crashmatt/Hardware/PX4uNode_V0_2_1.brd

## EAGLE design PX4uNode_V0_2_1.brd (2015-01-16)

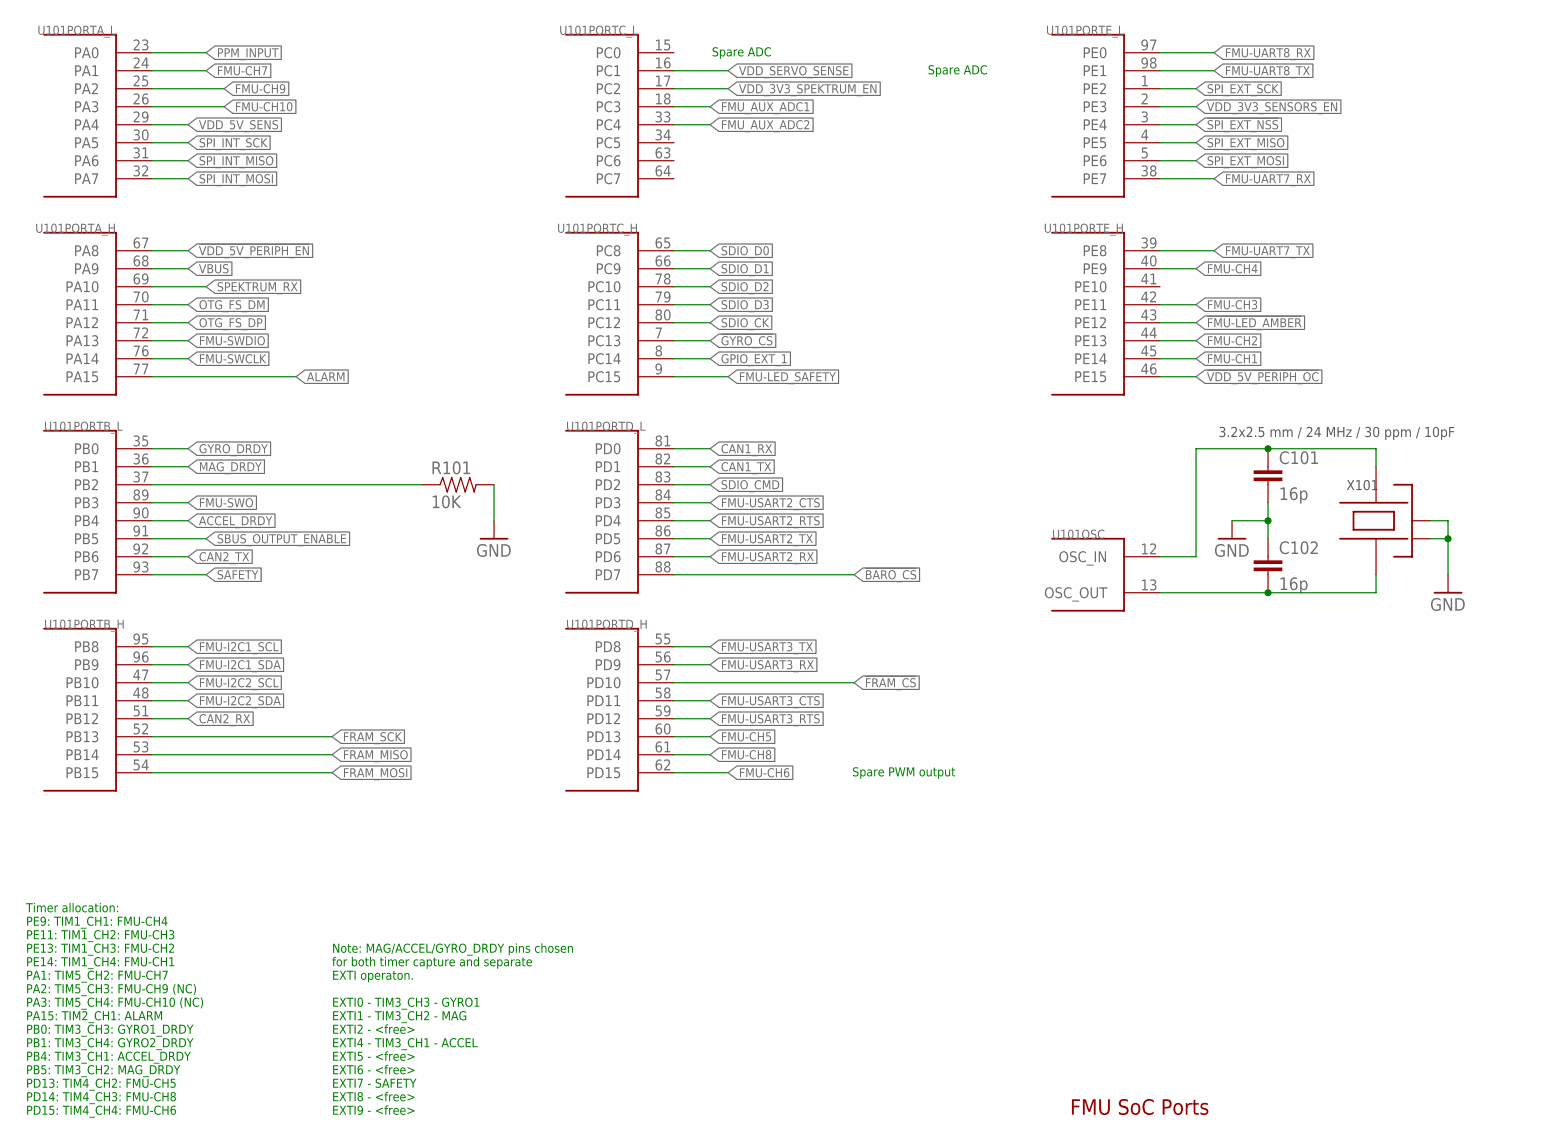
[picture p1: schematic PX4uNode_V0_2_1.sch, sheet 1]

Parts:
C101, C102: 16p; 0402-CAP; PARTNO C1005C0G1H160
R101: 10K; 0402-RES; PARTNO RC0402FR-0710KL
U101: STM32F4X7VX; TQFP100; PARTNO STM32F427VI
X101: 3.2x2.5 mm / 24 MHz / 30 ppm / 10pF; OSCILLATOR-3.2X2.5; PARTNO ABM8G-24.000MHZ-4Y-T3

Connections:
!BARO_CS: U101.88 (PD7)
!FMU-LED_AMBER: U101.43 (PE12); also elsewhere on the board
!FRAM_CS: U101.57 (PD10); also elsewhere on the board
!GYRO_CS: U101.7 (PC13); also elsewhere on the board
!SPI_EXT_NSS: U101.3 (PE4); also elsewhere on the board
!VDD_5V_PERIPH_EN: U101.67 (PA8); also elsewhere on the board
!VDD_5V_PERIPH_OC: U101.46 (PE15); also elsewhere on the board
ACCEL_DRDY: U101.90 (PB4); also elsewhere on the board
ALARM: U101.77 (PA15)
CAN1_RX: U101.81 (PD0); also elsewhere on the board
CAN1_TX: U101.82 (PD1); also elsewhere on the board
CAN2_RX: U101.51 (PB12); also elsewhere on the board
CAN2_TX: U101.92 (PB6); also elsewhere on the board
CLK1: C101.P$1 (1), U101.12 (OSC_IN), X101.3
CLK2: C102.P$2 (2), U101.13 (OSC_OUT), X101.1
FMU-CH1: U101.45 (PE14); also elsewhere on the board
FMU-CH2: U101.44 (PE13); also elsewhere on the board
FMU-CH3: U101.42 (PE11); also elsewhere on the board
FMU-CH4: U101.40 (PE9); also elsewhere on the board
FMU-CH5: U101.60 (PD13); also elsewhere on the board
FMU-CH6: U101.62 (PD15); also elsewhere on the board
FMU-CH7: U101.24 (PA1); also elsewhere on the board
FMU-CH8: U101.61 (PD14); also elsewhere on the board
FMU-CH9: U101.25 (PA2); also elsewhere on the board
FMU-CH10: U101.26 (PA3); also elsewhere on the board
FMU-I2C1_SCL: U101.95 (PB8); also elsewhere on the board
FMU-I2C1_SDA: U101.96 (PB9); also elsewhere on the board
FMU-I2C2_SCL: U101.47 (PB10); also elsewhere on the board
FMU-I2C2_SDA: U101.48 (PB11); also elsewhere on the board
FMU-LED_SAFETY: U101.9 (PC15); also elsewhere on the board
FMU-SWCLK: U101.76 (PA14); also elsewhere on the board
FMU-SWDIO: U101.72 (PA13); also elsewhere on the board
FMU-SWO: U101.89 (PB3); also elsewhere on the board
FMU-UART7_RX: U101.38 (PE7); also elsewhere on the board
FMU-UART7_TX: U101.39 (PE8); also elsewhere on the board
FMU-UART8_RX: U101.97 (PE0); also elsewhere on the board
FMU-UART8_TX: U101.98 (PE1); also elsewhere on the board
FMU-USART2_CTS: U101.84 (PD3); also elsewhere on the board
FMU-USART2_RTS: U101.85 (PD4); also elsewhere on the board
FMU-USART2_RX: U101.87 (PD6); also elsewhere on the board
FMU-USART2_TX: U101.86 (PD5); also elsewhere on the board
FMU-USART3_CTS: U101.58 (PD11); also elsewhere on the board
FMU-USART3_RTS: U101.59 (PD12); also elsewhere on the board
FMU-USART3_RX: U101.56 (PD9); also elsewhere on the board
FMU-USART3_TX: U101.55 (PD8); also elsewhere on the board
FMU_AUX_ADC1: U101.18 (PC3); also elsewhere on the board
FMU_AUX_ADC2: U101.33 (PC4); also elsewhere on the board
FRAM_MISO: U101.53 (PB14); also elsewhere on the board
FRAM_MOSI: U101.54 (PB15); also elsewhere on the board
FRAM_SCK: U101.52 (PB13); also elsewhere on the board
GND: C101.P$2 (2), C102.P$1 (1), R101.P$2 (2), X101.2 (NC_2), X101.4 (NC_4); also elsewhere on the board
GPIO_EXT_1: U101.8 (PC14); also elsewhere on the board
GYRO_DRDY: U101.35 (PB0); also elsewhere on the board
MAG_DRDY: U101.36 (PB1); also elsewhere on the board
OTG_FS_DM: U101.70 (PA11); also elsewhere on the board
OTG_FS_DP: U101.71 (PA12); also elsewhere on the board
PB2-BOOT1: R101.P$1 (1), U101.37 (PB2)
PPM_INPUT: U101.23 (PA0); also elsewhere on the board
SAFETY: U101.93 (PB7); also elsewhere on the board
SBUS_OUTPUT_ENABLE: U101.91 (PB5); also elsewhere on the board
SDIO_CK: U101.80 (PC12)
SDIO_CMD: U101.83 (PD2)
SDIO_D0: U101.65 (PC8)
SDIO_D1: U101.66 (PC9)
SDIO_D2: U101.78 (PC10)
SDIO_D3: U101.79 (PC11)
SPEKTRUM_RX: U101.69 (PA10); also elsewhere on the board
SPI_EXT_MISO: U101.4 (PE5); also elsewhere on the board
SPI_EXT_MOSI: U101.5 (PE6); also elsewhere on the board
SPI_EXT_SCK: U101.1 (PE2); also elsewhere on the board
SPI_INT_MISO: U101.31 (PA6); also elsewhere on the board
SPI_INT_MOSI: U101.32 (PA7); also elsewhere on the board
SPI_INT_SCK: U101.30 (PA5); also elsewhere on the board
VBUS: U101.68 (PA9); also elsewhere on the board
VDD_3V3_SENSORS_EN: U101.2 (PE3); also elsewhere on the board
VDD_3V3_SPEKTRUM_EN: U101.17 (PC2); also elsewhere on the board
VDD_5V_SENS: U101.29 (PA4); also elsewhere on the board
VDD_SERVO_SENSE: U101.16 (PC1); also elsewhere on the board

Notes on the sheet:
FMU SoC Ports
Note: MAG/ACCEL/GYRO_DRDY pins chosen for both timer capture and separate EXTI operaton. EXTI0 - TIM3_CH3 - GYRO1 EXTI1 - TIM3_CH2 - MAG EXTI2 - <free> EXTI4 - TIM3_CH1 - ACCEL EXTI5 - <free> EXTI6 - <free> EXTI7 - SAFETY EXTI8 - <free> EXTI9 - <free>
Timer allocation: PE9: TIM1_CH1: FMU-CH4 PE11: TIM1_CH2: FMU-CH3 PE13: TIM1_CH3: FMU-CH2 PE14: TIM1_CH4: FMU-CH1 PA1: TIM5_CH2: FMU-CH7 PA2: TIM5_CH3: FMU-CH9 (NC) PA3: TIM5_CH4: FMU-CH10 (NC) PA15: TIM2_CH1: ALARM PB0: TIM3_CH3: GYRO1_DRDY PB1: TIM3_CH4: GYRO2_DRDY PB4: TIM3_CH1: ACCEL_DRDY PB5: T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
Spare PWM output
Spare ADC

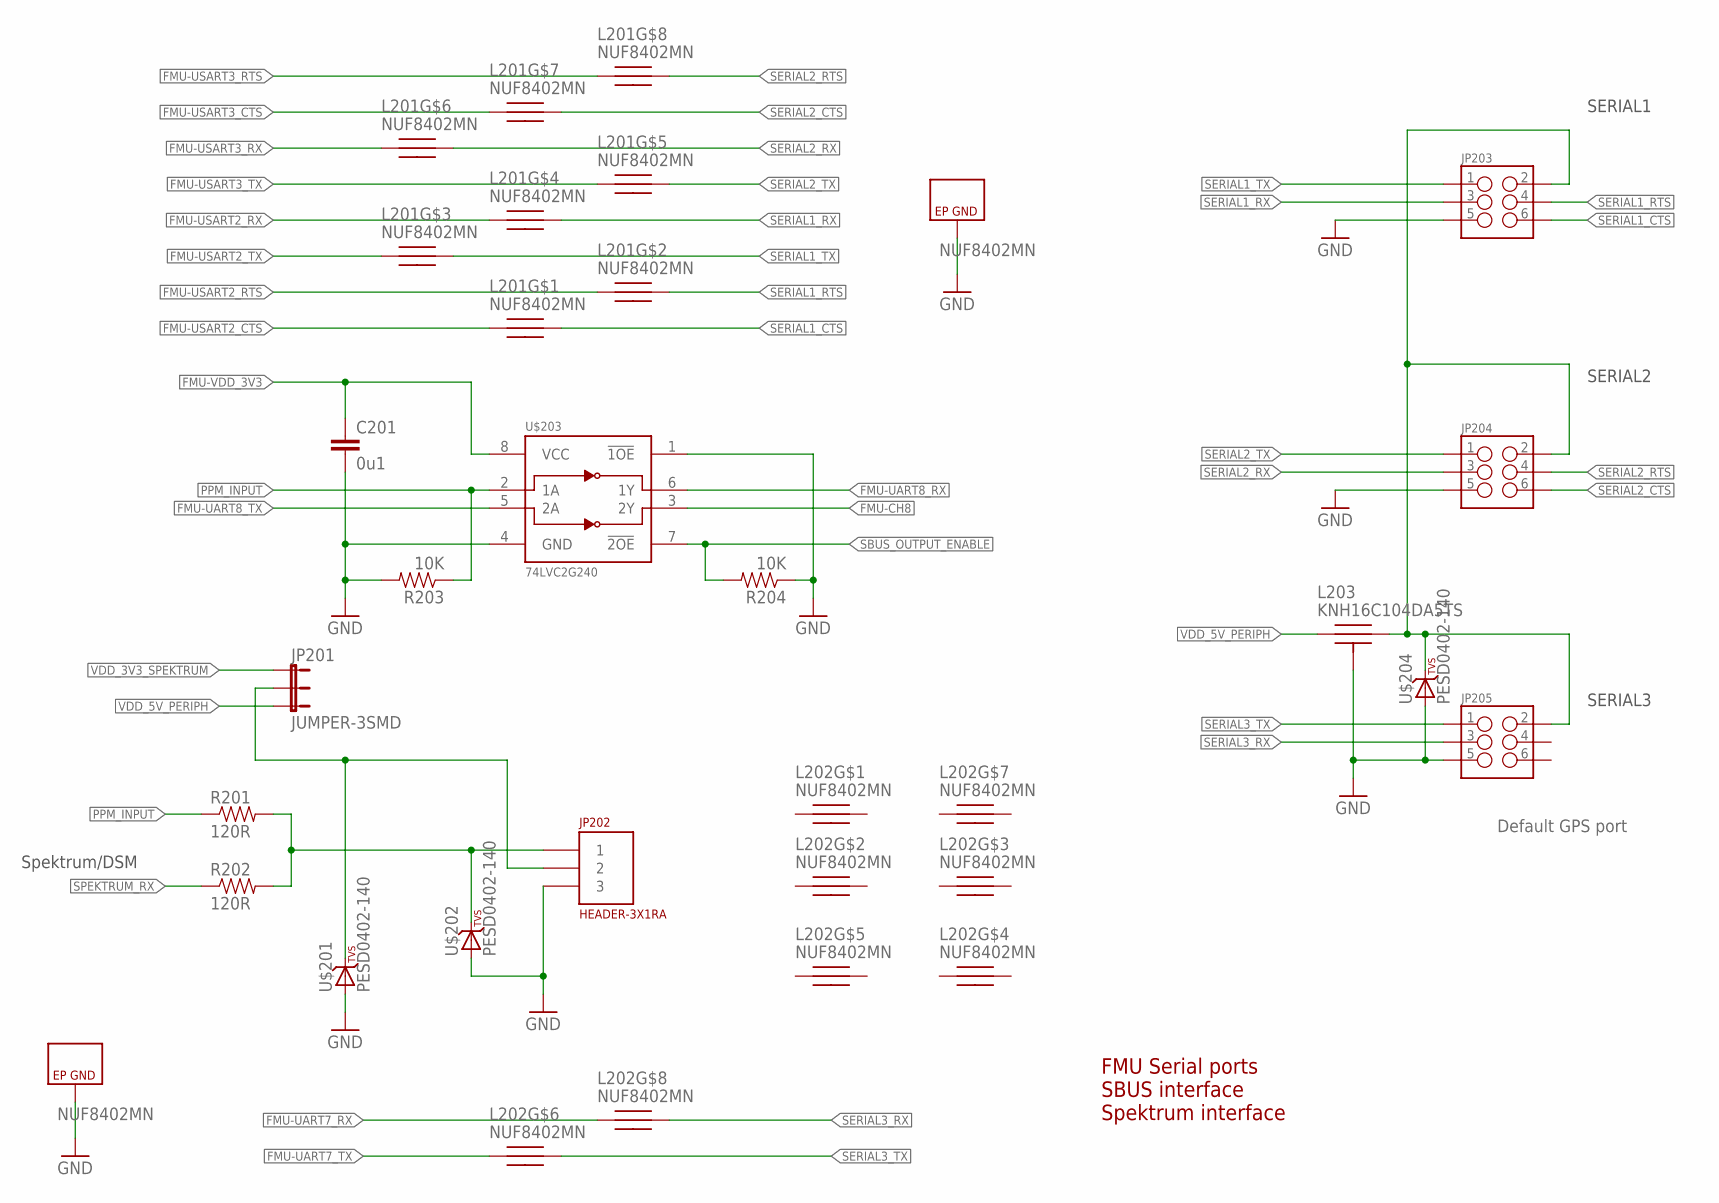
[picture p2: schematic PX4uNode_V0_2_1.sch, sheet 2]

Parts:
C201: 0u1; 0402-CAP; PARTNO CC0402ZRY5V7BB104
JP201: JUMPER-3SMD; SJ_3
JP202: HEADER-3X1RA; 3X1RA
JP203, JP204, JP205: M03X22X3_SILK_SM; 2X3
L201, L202: NUF8402MN; DFN16-THIN; PARTNO NUF8402MN
L203: KNH16C104DA5TS; KYOCERA-KNH16-DA; PARTNO KNH16C104DA5TS
R201, R202: 120R; 0402-RES; PARTNO RC0402FR-07120RL
R203, R204: 10K; 0402-RES; PARTNO RC0402FR-0710KL
U$201, U$202, U$204: PESD0402-140; 0402-TVS; PARTNO PESD0402-140
U$203: 74LVC2G240; VSSOP8; PARTNO 74LVC2G240

Connections:
5V_S3_FILTERED: JP203.2, JP204.2, JP205.2, L203.P$2, U$204.C
FMU-CH8: U$203.3 (2Y); also elsewhere on the board
FMU-UART7_RX: L202.P$8; also elsewhere on the board
FMU-UART7_TX: L202.P$6; also elsewhere on the board
FMU-UART8_RX: U$203.6 (1Y); also elsewhere on the board
FMU-UART8_TX: U$203.5 (2A); also elsewhere on the board
FMU-USART2_CTS: L201.P$1; also elsewhere on the board
FMU-USART2_RTS: L201.P$2; also elsewhere on the board
FMU-USART2_RX: L201.P$4; also elsewhere on the board
FMU-USART2_TX: L201.P$3; also elsewhere on the board
FMU-USART3_CTS: L201.P$7; also elsewhere on the board
FMU-USART3_RTS: L201.P$8; also elsewhere on the board
FMU-USART3_RX: L201.P$6; also elsewhere on the board
FMU-USART3_TX: L201.P$5; also elsewhere on the board
FMU-VDD_3V3: C201.P$1 (1), U$203.8 (VCC); also elsewhere on the board
GND: C201.P$2 (2), JP202.3, JP203.5, JP204.5, JP205.5, L201.P$EP (GND), L202.P$EP (GND), L203.P$3, L203.P$4, L203.P$5, R203.P$2 (2), R204.P$1 (1), U$201.A, U$202.A, U$203.1 (!1OE), U$203.4 (GND), U$204.A; also elsewhere on the board
unnamed: JP202.1, R201.P$2 (2), R202.P$2 (2), U$202.C
unnamed: JP201.2, JP202.2, U$201.C
PPM_INPUT: R201.P$1 (1), R203.P$1 (1), U$203.2 (1A); also elsewhere on the board
SBUS_OUTPUT_ENABLE: R204.P$2 (2), U$203.7 (!2OE); also elsewhere on the board
SERIAL1_CTS: JP203.6, L201.P$16
SERIAL1_RTS: JP203.4, L201.P$15
SERIAL1_RX: JP203.3, L201.P$13
SERIAL1_TX: JP203.1, L201.P$14
SERIAL2_CTS: JP204.6, L201.P$10
SERIAL2_RTS: JP204.4, L201.P$9
SERIAL2_RX: JP204.3, L201.P$11
SERIAL2_TX: JP204.1, L201.P$12
SERIAL3_RX: JP205.3, L202.P$9
SERIAL3_TX: JP205.1, L202.P$11
SPEKTRUM_RX: R202.P$1 (1); also elsewhere on the board
VDD_3V3_SPEKTRUM: JP201.1; also elsewhere on the board
VDD_5V_PERIPH: JP201.3, L203.P$1; also elsewhere on the board

Notes on the sheet:
FMU Serial ports SBUS interface Spektrum interface
SERIAL2
SERIAL1
SERIAL3
Default GPS port
Spektrum/DSM

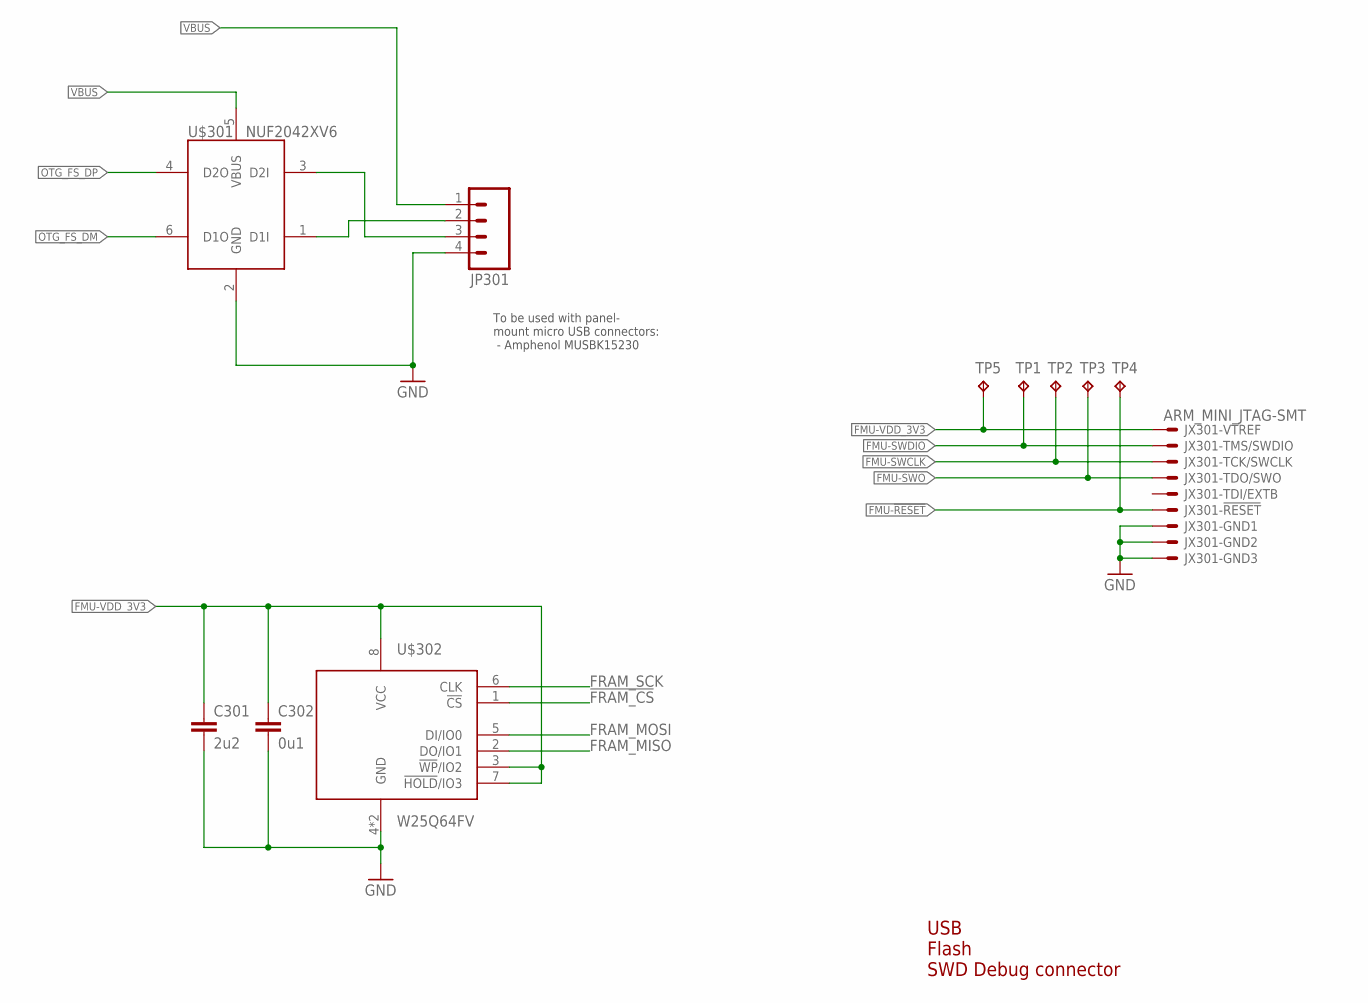
[picture p3: schematic PX4uNode_V0_2_1.sch, sheet 3]

Parts:
C301: 2u2; 0603-CAP; PARTNO C1608Y5V1C225Z
C302: 0u1; 0402-CAP; PARTNO CC0402ZRY5V7BB104
JP301: M04PTH; 1X04
JX301: ARM_MINI_JTAG-SMT; FTSH-105-01-XXX-DV-K; PARTNO M50-3900542
TP1, TP2, TP3, TP4, TP5: TPTP20R; TP20R
U$301: NUF2042XV6; SOT563-6; PARTNO NUF2042XV6
U$302: W25Q64FV; WSON-8-5X6; PARTNO W25Q64FVZP

Connections:
!FRAM_CS: U$302.1 (!CS); also elsewhere on the board
FMU-!RESET: JX301.10, TP4.TP; also elsewhere on the board
FMU-SWCLK: JX301.4, TP2.TP; also elsewhere on the board
FMU-SWDIO: JX301.2, TP1.TP; also elsewhere on the board
FMU-SWO: JX301.6, TP3.TP; also elsewhere on the board
FMU-VDD_3V3: C301.P$1 (1), C302.P$1 (1), JX301.1, TP5.TP, U$302.3 (!WP!/IO2), U$302.7 (!HOLD!/IO3), U$302.8 (VCC); also elsewhere on the board
FRAM_MISO: U$302.2 (DO/IO1); also elsewhere on the board
FRAM_MOSI: U$302.5 (DI/IO0); also elsewhere on the board
FRAM_SCK: U$302.6 (CLK); also elsewhere on the board
GND: C301.P$2 (2), C302.P$2 (2), JP301.4, JX301.3, JX301.5, JX301.9, U$301.2 (GND), U$302.4 (GND), U$302.PAD (GND); also elsewhere on the board
OTG_FS_DM: U$301.6 (D1O); also elsewhere on the board
OTG_FS_DP: U$301.4 (D2O); also elsewhere on the board
UDB_DP: JP301.3, U$301.3 (D2I)
USB_DM: JP301.2, U$301.1 (D1I)
VBUS: JP301.1, U$301.5 (VBUS); also elsewhere on the board

Notes on the sheet:
USB Flash SWD Debug connector
To be used with panel- mount micro USB connectors: - Amphenol MUSBK15230

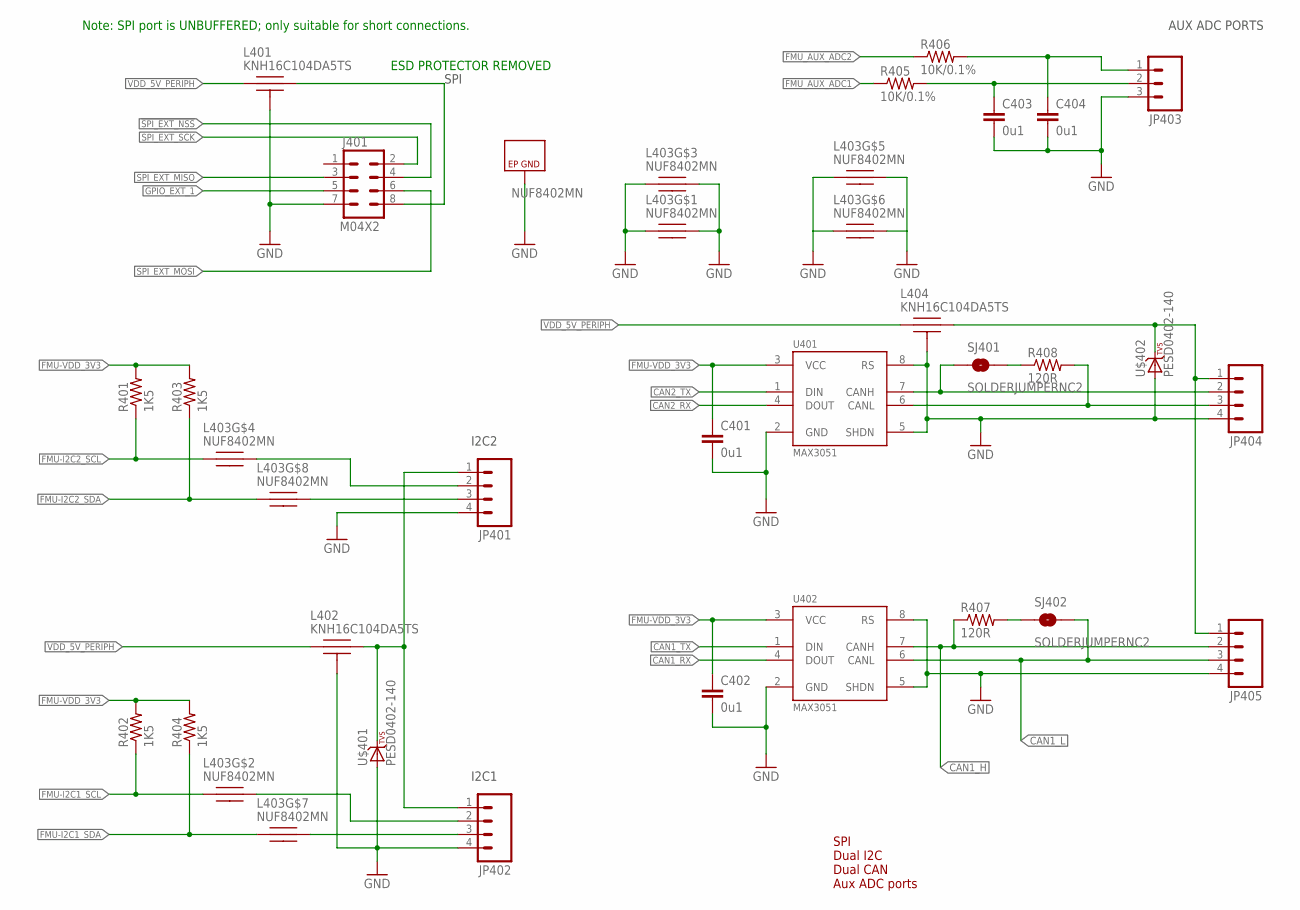
[picture p4: schematic PX4uNode_V0_2_1.sch, sheet 4]

Parts:
C401, C402, C403, C404: 0u1; 0402-CAP; PARTNO CC0402ZRY5V7BB104
J401: M04X2; 2X4
JP401, JP402, JP404, JP405: M04PTH; 1X04
JP403: M03PTH; 1X03; PARTNO EXCLUDE
L401, L402, L404: KNH16C104DA5TS; KYOCERA-KNH16-DA; PARTNO KNH16C104DA5TS
L403: NUF8402MN; DFN16-THIN; PARTNO NUF8402MN
R401, R402, R403, R404: 1K5; 0402-RES; PARTNO RC0402FR-071K5L
R405, R406: 10K/0.1%; 0402-RES; PARTNO ERA-2AEB103X
R407, R408: 120R; 0402-RES; PARTNO RC0402FR-07120RL
SJ401, SJ402: SOLDERJUMPERNC2; SJ_2S-NOTRACE
U401, U402: MAX3051; SOT23-8; PARTNO MAX3051EKA
U$401, U$402: PESD0402-140; 0402-TVS; PARTNO PESD0402-140

Connections:
!SPI_EXT_NSS: J401.4; also elsewhere on the board
CAN1_H: JP405.2, R407.P$1 (1), U402.7 (CANH)
CAN1_L: JP405.3, SJ402.2, U402.6 (CANL)
CAN1_RX: U402.4 (DOUT); also elsewhere on the board
CAN1_TX: U402.1 (DIN); also elsewhere on the board
CAN2_H: JP404.2, SJ401.1, U401.7 (CANH)
CAN2_L: JP404.3, R408.P$2 (2), U401.6 (CANL)
CAN2_RX: U401.4 (DOUT); also elsewhere on the board
CAN2_TX: U401.1 (DIN); also elsewhere on the board
FMU-I2C1_SCL: L403.P$2, R402.P$1 (1); also elsewhere on the board
FMU-I2C1_SDA: L403.P$7, R404.P$1 (1); also elsewhere on the board
FMU-I2C2_SCL: L403.P$4, R401.P$1 (1); also elsewhere on the board
FMU-I2C2_SDA: L403.P$8, R403.P$1 (1); also elsewhere on the board
FMU-VDD_3V3: C401.P$1 (1), C402.P$1 (1), R401.P$2 (2), R402.P$2 (2), R403.P$2 (2), R404.P$2 (2), U401.3 (VCC), U402.3 (VCC); also elsewhere on the board
FMU_AUX_ADC1: R405.P$1 (1); also elsewhere on the board
FMU_AUX_ADC1_PROT: C403.P$1 (1), JP403.2, R405.P$2 (2)
FMU_AUX_ADC2: R406.P$1 (1); also elsewhere on the board
FMU_AUX_ADC2_PROT: C404.P$1 (1), JP403.1, R406.P$2 (2)
GND: C401.P$2 (2), C402.P$2 (2), C403.P$2 (2), C404.P$2 (2), J401.7, JP401.4, JP402.4, JP403.3, JP404.4, JP405.4, L401.P$3, L401.P$4, L401.P$5, L402.P$3, L402.P$4, L402.P$5, L403.P$1, L403.P$3, L403.P$5, L403.P$6, L403.P$11, L403.P$12, L403.P$14, L403.P$16, L403.P$EP (GND), L404.P$3, L404.P$4, L404.P$5, U401.2 (GND), U401.5 (SHDN), U401.8 (RS), U402.2 (GND), U402.5 (SHDN), U402.8 (RS), U$401.A, U$402.A; also elsewhere on the board
GPIO_EXT_1: J401.5; also elsewhere on the board
IC2_VDD_5V: JP401.1, JP402.1, L402.P$2, U$401.C
unnamed: JP401.2, L403.P$13
unnamed: JP401.3, L403.P$9
unnamed: R408.P$1 (1), SJ401.2
unnamed: R407.P$2 (2), SJ402.1
unnamed: JP404.1, JP405.1, L404.P$2, U$402.C
unnamed: JP402.2, L403.P$15
unnamed: JP402.3, L403.P$10
unnamed: J401.8, L401.P$2
SPI_EXT_MISO: J401.3; also elsewhere on the board
SPI_EXT_MOSI: J401.6; also elsewhere on the board
SPI_EXT_SCK: J401.2; also elsewhere on the board
VDD_5V_PERIPH: L401.P$1, L402.P$1, L404.P$1; also elsewhere on the board

Notes on the sheet:
SPI
I2C2
AUX ADC PORTS
SPI Dual I2C Dual CAN Aux ADC ports
Note: SPI port is UNBUFFERED; only suitable for short connections.
I2C1
ESD PROTECTOR REMOVED

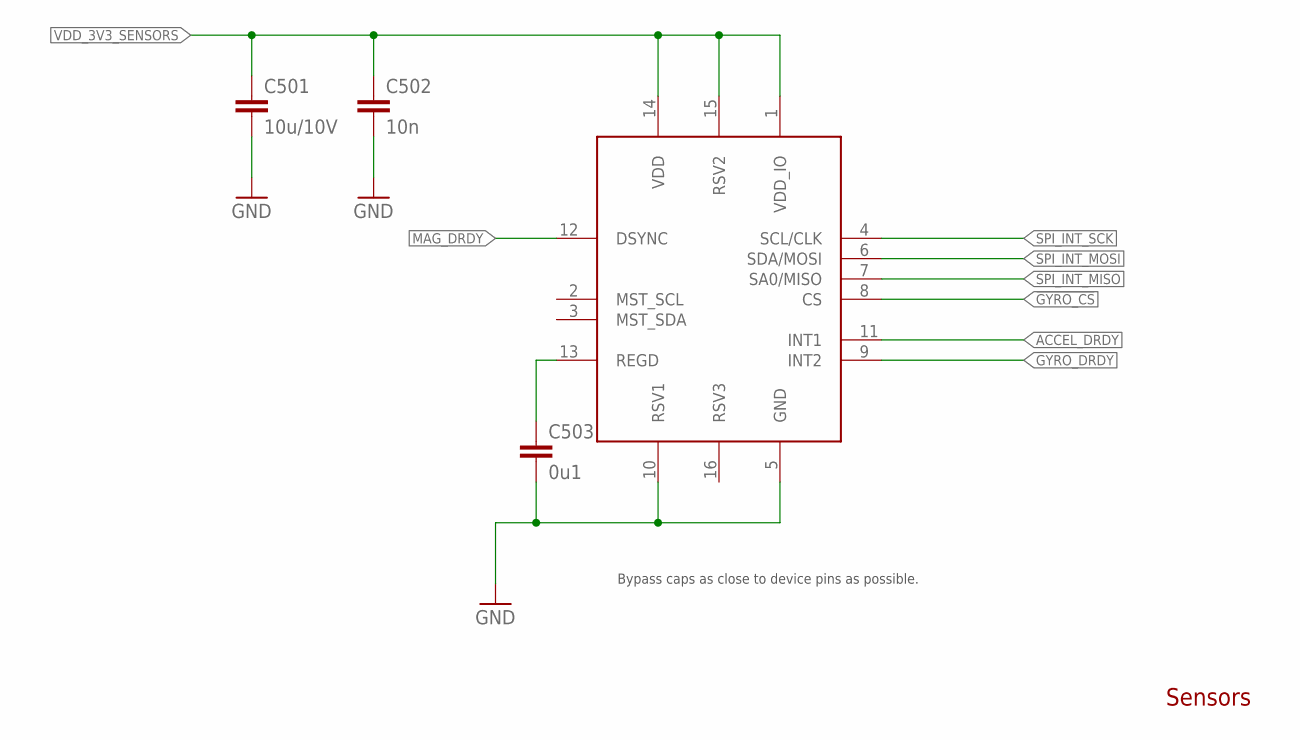
[picture p5: schematic PX4uNode_V0_2_1.sch, sheet 5]

Parts:
C501: 10u/10V; 0805-CAP; PARTNO CC0805ZKY5V6BB106
C502: 10n; 0402-CAP; PARTNO CC0402KRX7R7BB103
C503: 0u1; 0402-CAP; PARTNO CC0402ZRY5V7BB104
U$501: MAX21100; 16LGA-3X3; PARTNO MAX21100+

Connections:
!GYRO_CS: U$501.8 (CS); also elsewhere on the board
ACCEL_DRDY: U$501.11 (INT1); also elsewhere on the board
GND: C501.P$2 (2), C502.P$2 (2), C503.P$2 (2), U$501.5 (GND), U$501.10 (RSV1); also elsewhere on the board
GYRO_DRDY: U$501.9 (INT2); also elsewhere on the board
MAG_DRDY: U$501.12 (DSYNC); also elsewhere on the board
REGD: C503.P$1 (1), U$501.13 (REGD)
SPI_INT_MISO: U$501.7 (SA0/MISO); also elsewhere on the board
SPI_INT_MOSI: U$501.6 (SDA/MOSI); also elsewhere on the board
SPI_INT_SCK: U$501.4 (SCL/CLK); also elsewhere on the board
VDD_3V3_SENSORS: C501.P$1 (1), C502.P$1 (1), U$501.1 (VDD_IO), U$501.14 (VDD), U$501.15 (RSV2); also elsewhere on the board

Notes on the sheet:
Sensors
Bypass caps as close to device pins as possible.

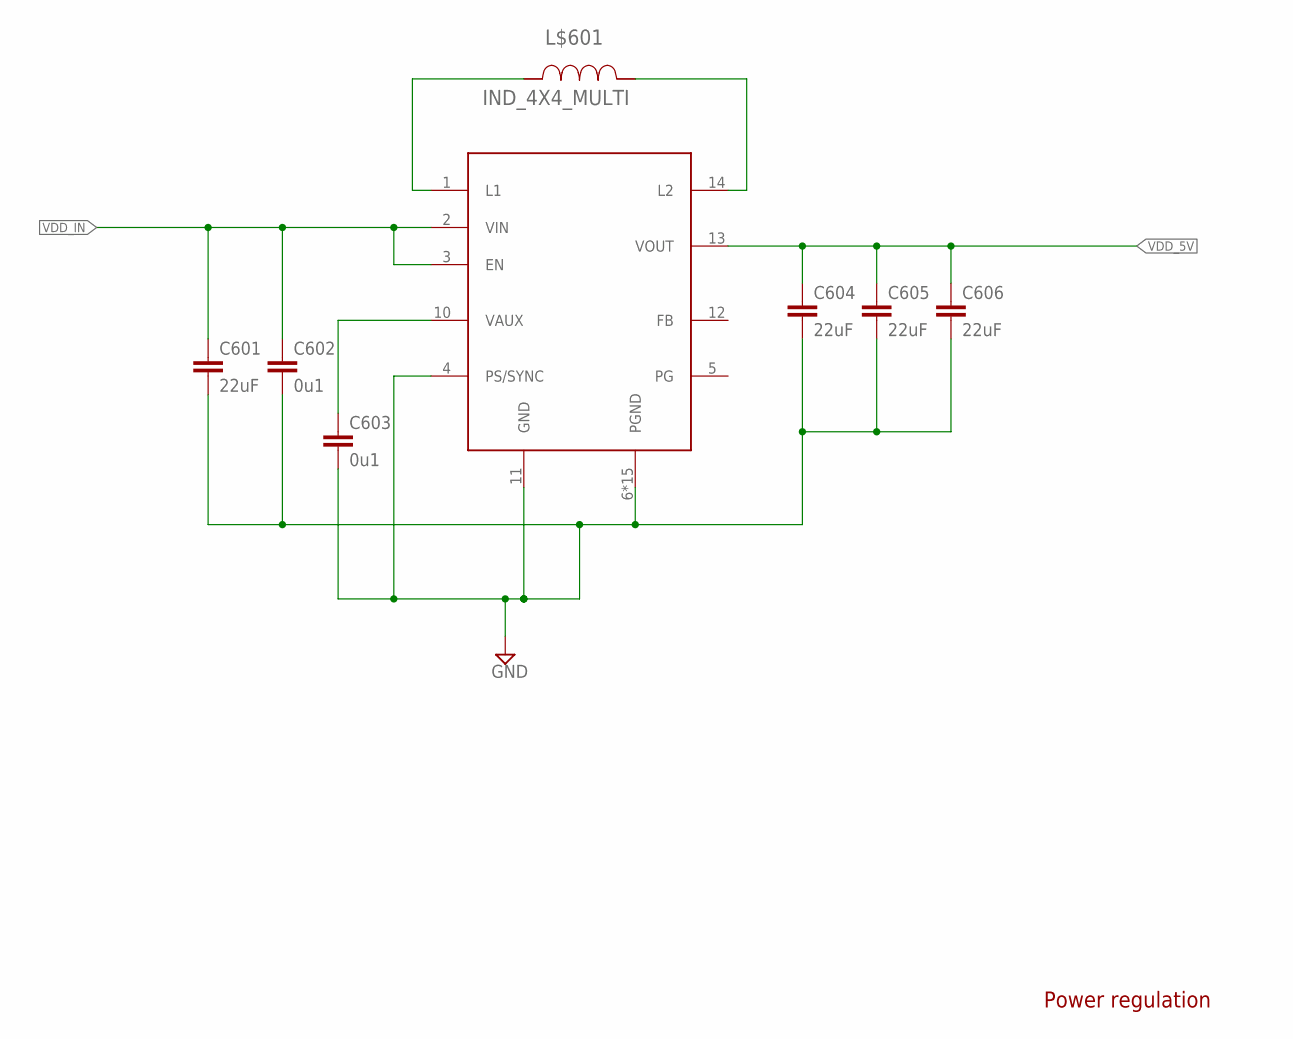
[picture p6: schematic PX4uNode_V0_2_1.sch, sheet 6]

Parts:
C601, C604, C605, C606: 22uF; 1210; PARTNO C3225X7R1C226M250AC
C602, C603: 0u1; 0402-CAP; PARTNO CC0402ZRY5V7BB104
L$601: IND_4X4_MULTI; PARTNO XFL4020-222MEB
U$601: TPS6303X; PWSON10; PARTNO TPS63061DSCT

Connections:
GND: C601.2, C602.P$2 (2), C603.P$2 (2), C604.2, C605.2, C606.2, U$601.4 (PS/SYNC), U$601.6 (PGND), U$601.7 (PGND), U$601.8 (PGND), U$601.9 (PGND), U$601.11 (GND), U$601.15 (PGND), U$601.16 (PGND), U$601.17 (PGND), U$601.18 (PGND), U$601.19 (PGND), U$601.20 (PGND), U$601.21 (PGND), U$601.22 (PGND), U$601.23 (PGND), U$601.EP (PGND), U$601.EP1 (PGND); also elsewhere on the board
unnamed: L$601.1, U$601.14 (L2)
unnamed: L$601.2, U$601.1 (L1)
unnamed: C603.P$1 (1), U$601.10 (VAUX)
VDD_5V: C604.1, C605.1, C606.1, U$601.13 (VOUT); also elsewhere on the board
VDD_IN: C601.1, C602.P$1 (1), U$601.2 (VIN), U$601.3 (EN); also elsewhere on the board

Notes on the sheet:
Power regulation

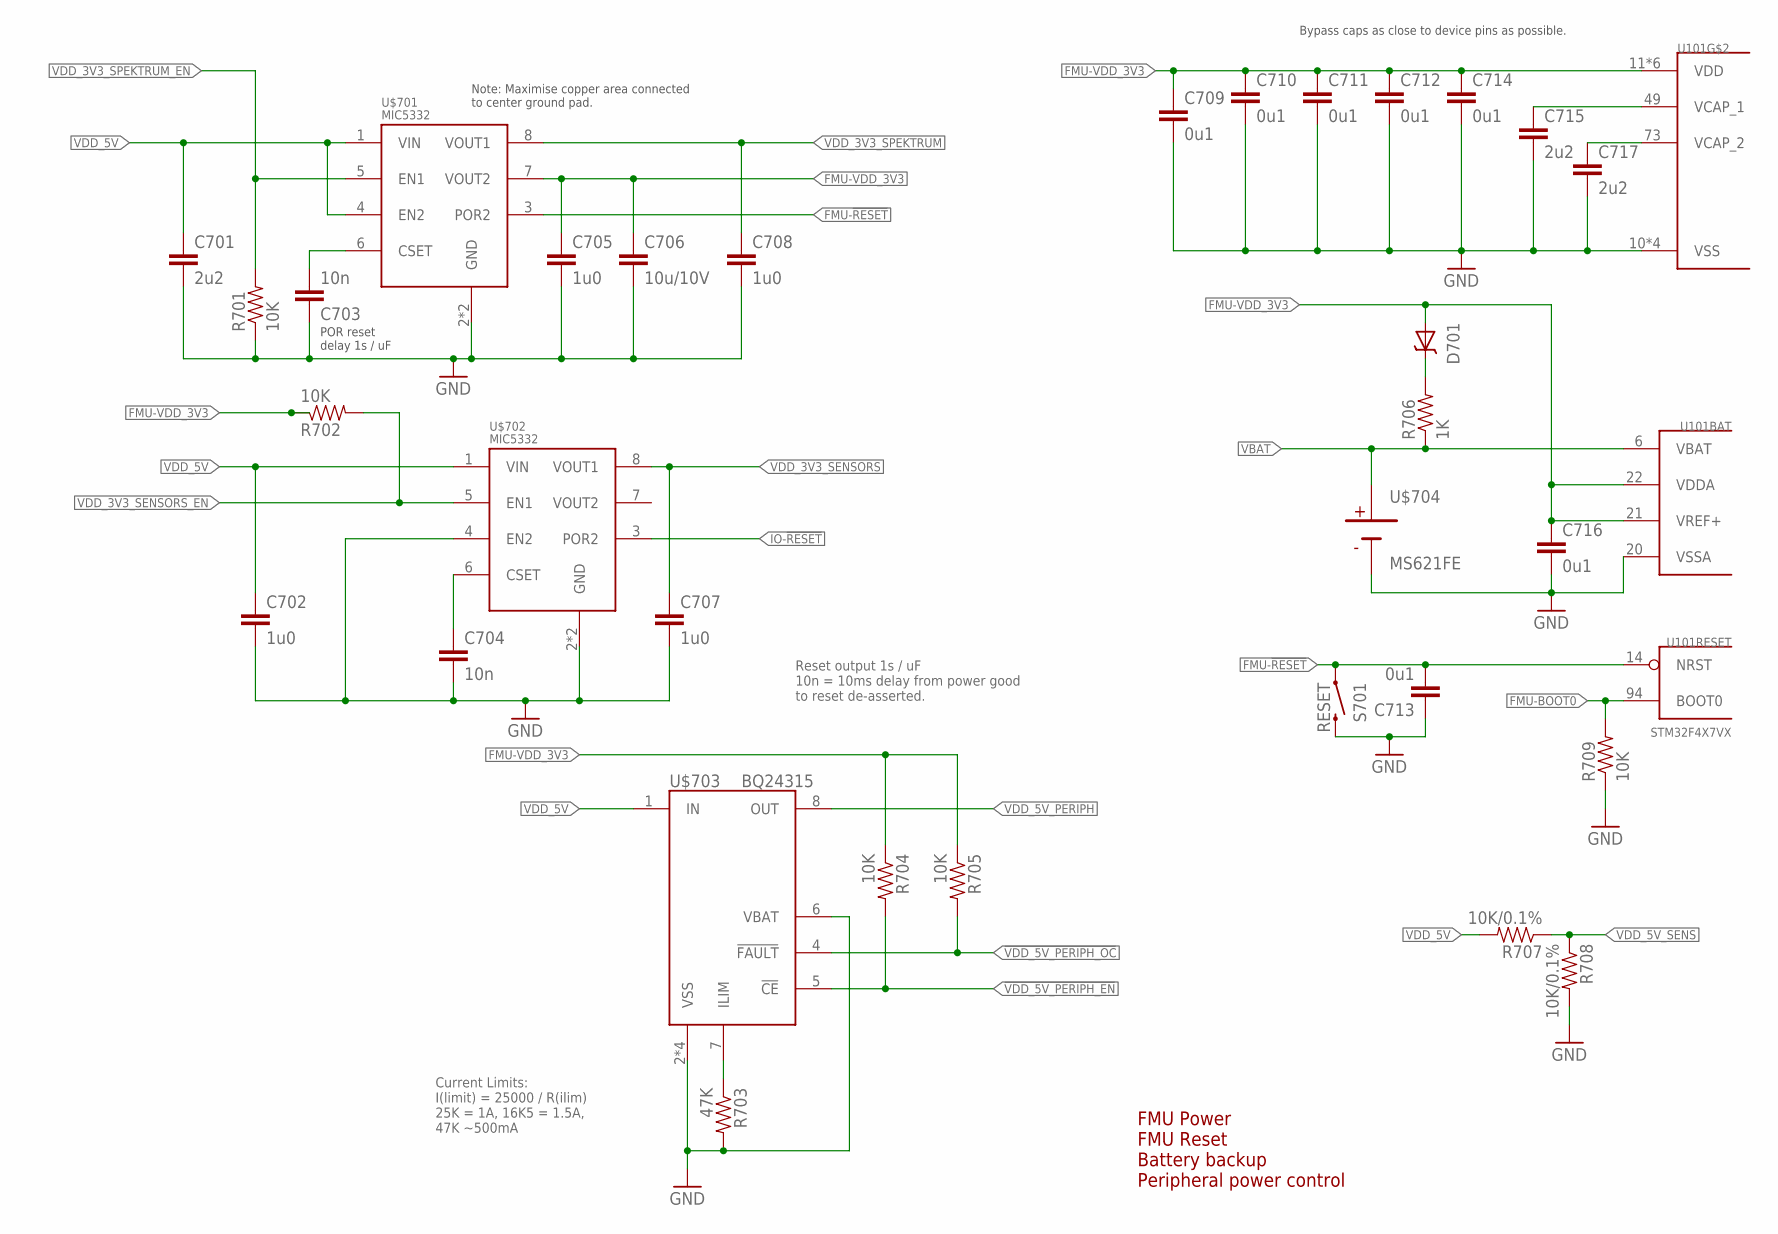
[picture p7: schematic PX4uNode_V0_2_1.sch, sheet 7]

Parts:
C701, C715, C717: 2u2; 0603-CAP; PARTNO C1608Y5V1C225Z
C702, C705, C707, C708: 1u0; 0603-CAP; PARTNO CC0603ZRY5V7BB105
C703, C704: 10n; 0402-CAP; PARTNO CC0402KRX7R7BB103
C706: 10u/10V; 0805-CAP; PARTNO CC0805ZKY5V6BB106
C709, C710, C711, C712, C713, C714, C716: 0u1; 0402-CAP; PARTNO CC0402ZRY5V7BB104
D701: DIODE-SCHOTTKY; SOD-523; PARTNO MBRA140
R701, R702, R704, R705, R709: 10K; 0402-RES; PARTNO RC0402FR-0710KL
R703: 47K; 0402-RES; PARTNO RMCF0402FT47K
R706: 1K; 0402-RES; PARTNO RC0402FR-071KL
R707, R708: 10K/0.1%; 0402-RES; PARTNO ERA-2AEB103X
S701: RESET; EVQP7J01K; PARTNO EVQP7J01K
U101: STM32F4X7VX; TQFP100; PARTNO STM32F427VI
U$701, U$702: MIC5332; MLF-8-EPAD; PARTNO MIC5332-SSYMT
U$703: BQ24315; QFN8-DSG; PARTNO BQ24315DSGR
U$704: MS621FE

Connections:
!VDD_5V_PERIPH_EN: R704.P$2 (2), U$703.5 (!CE); also elsewhere on the board
!VDD_5V_PERIPH_OC: R705.P$2 (2), U$703.4 (!FAULT); also elsewhere on the board
FMU-!RESET: C713.P$2 (2), S701.A1 (1), U101.14 (NRST), U$701.3 (POR2); also elsewhere on the board
FMU-BOOT0: R709.P$2 (2), U101.94 (BOOT0); also elsewhere on the board
FMU-VDD_3V3: C705.P$1 (1), C706.P$1 (1), C709.P$1 (1), C710.P$1 (1), C711.P$1 (1), C712.P$1 (1), C714.P$1 (1), C716.P$1 (1), D701.A, R702.P$1 (1), R704.P$1 (1), R705.P$1 (1), U101.11 (VDD), U101.19 (VDD), U101.21 (VREF+), U101.22 (VDDA), U101.28 (VDD), U101.50 (VDD), U101.75 (VDD), U101.100 (VDD), U$701.7 (VOUT2); also elsewhere on the board
GND: C701.P$2 (2), C702.P$2 (2), C703.P$1 (1), C704.P$2 (2), C705.P$2 (2), C706.P$2 (2), C707.P$2 (2), C708.P$2 (2), C709.P$2 (2), C710.P$2 (2), C711.P$2 (2), C712.P$2 (2), C713.P$1 (1), C714.P$2 (2), C715.P$2 (2), C716.P$2 (2), C717.P$2 (2), R701.P$1 (1), R703.P$2 (2), R708.P$2 (2), R709.P$1 (1), S701.B3 (2), U101.10 (VSS), U101.20 (VSSA), U101.27 (VSS), U101.74 (VSS), U101.99 (VSS), U$701.2 (GND), U$701.GND, U$702.2 (GND), U$702.4 (EN2), U$702.GND, U$703.2 (VSS), U$703.6 (VBAT), U$703.GND (VSS), U$703.P$2 (VSS), U$703.P$3 (VSS), U$704.2 (NEG); also elsewhere on the board
IO-!RESET: U$702.3 (POR2)
unnamed: D701.C, R706.P$2 (2)
unnamed: C703.P$2 (2), U$701.6 (CSET)
unnamed: R703.P$1 (1), U$703.7 (ILIM)
unnamed: C704.P$1 (1), U$702.6 (CSET)
VBAT: R706.P$1 (1), U101.6 (VBAT), U$704.1 (POS)
VCAP_1: C715.P$1 (1), U101.49 (VCAP_1)
VCAP_2: C717.P$1 (1), U101.73 (VCAP_2)
VDD_3V3_SENSORS: C707.P$1 (1), U$702.8 (VOUT1); also elsewhere on the board
VDD_3V3_SENSORS_EN: R702.P$2 (2), U$702.5 (EN1); also elsewhere on the board
VDD_3V3_SPEKTRUM: C708.P$1 (1), U$701.8 (VOUT1); also elsewhere on the board
VDD_3V3_SPEKTRUM_EN: R701.P$2 (2), U$701.5 (EN1); also elsewhere on the board
VDD_5V: C701.P$1 (1), C702.P$1 (1), R707.P$2 (2), U$701.1 (VIN), U$701.4 (EN2), U$702.1 (VIN), U$703.1 (IN); also elsewhere on the board
VDD_5V_PERIPH: U$703.8 (OUT); also elsewhere on the board
VDD_5V_SENS: R707.P$1 (1), R708.P$1 (1); also elsewhere on the board

Notes on the sheet:
FMU Power FMU Reset Battery backup Peripheral power control
Bypass caps as close to device pins as possible.
Note: Maximise copper area connected to center ground pad.
POR reset delay 1s / uF
Current Limits: I(limit) = 25000 / R(ilim) 25K = 1A, 16K5 = 1.5A, 47K ~500mA
Reset output 1s / uF 10n = 10ms delay from power good to reset de-asserted.

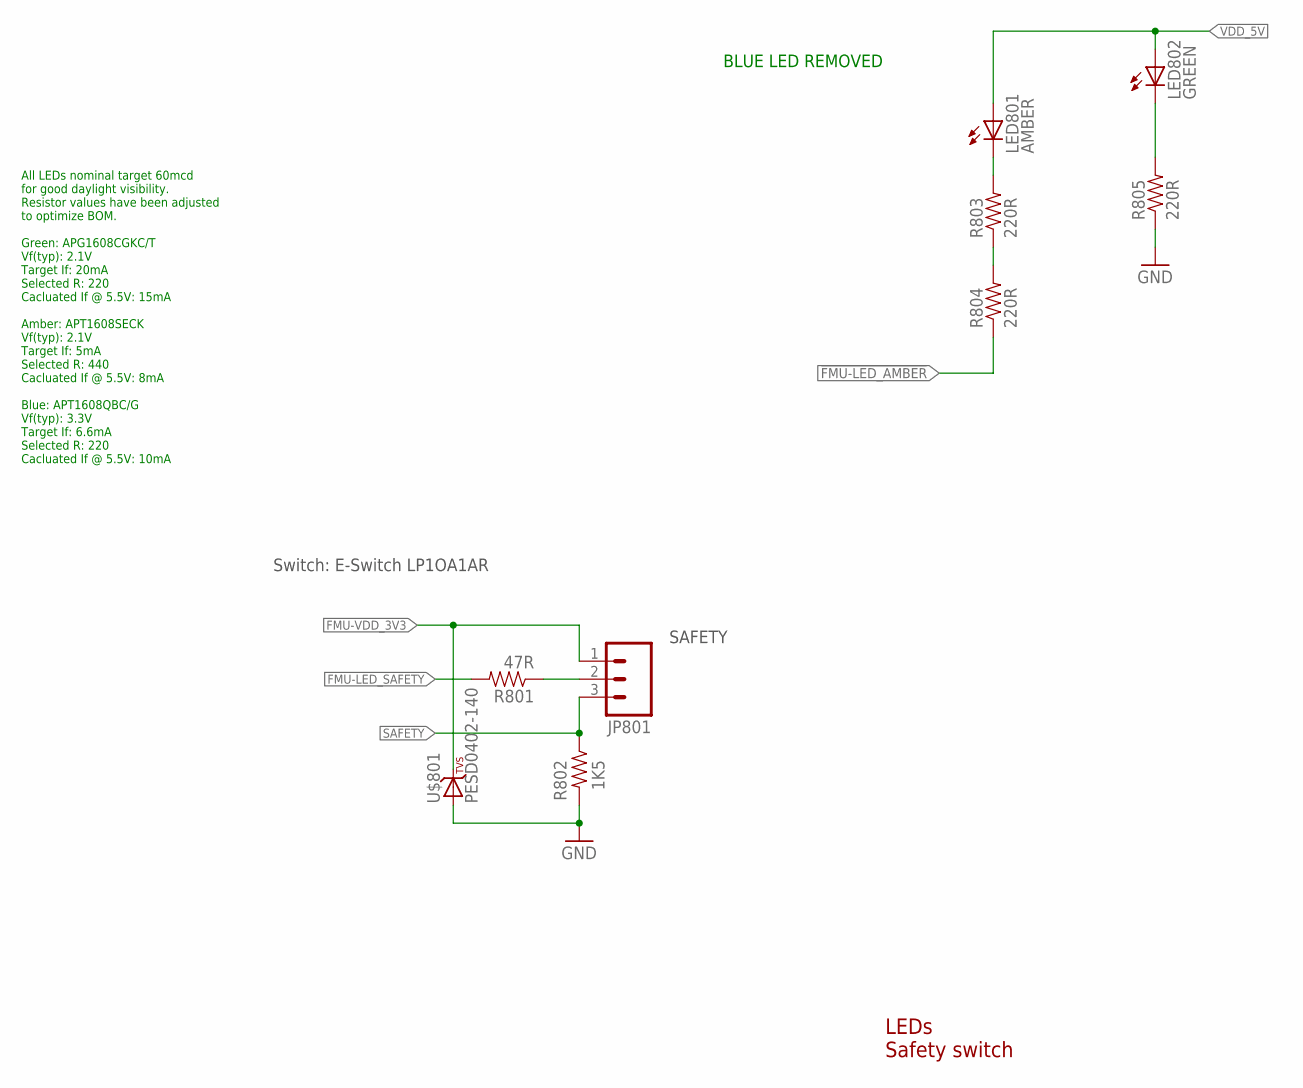
[picture p8: schematic PX4uNode_V0_2_1.sch, sheet 8]

Parts:
JP801: M03PTH; 1X03
LED801: AMBER; 0603-LED; PARTNO APTD1608SECK
LED802: GREEN; 0603-LED; PARTNO APTD1608CGCK
R801: 47R; 0402-RES; PARTNO RC0402JR-0747RL
R802: 1K5; 0402-RES; PARTNO RC0402FR-071K5L
R803, R804, R805: 220R; 0402-RES; PARTNO RC0402FR-07220RL
U$801: PESD0402-140; 0402-TVS; PARTNO PESD0402-140

Connections:
!FMU-LED_AMBER: R804.P$1 (1); also elsewhere on the board
FMU-LED_SAFETY: R801.P$2 (2); also elsewhere on the board
FMU-VDD_3V3: JP801.1, U$801.C; also elsewhere on the board
GND: R802.P$2 (2), R805.P$1 (1), U$801.A; also elsewhere on the board
unnamed: LED802.C, R805.P$2 (2)
unnamed: R803.P$1 (1), R804.P$2 (2)
unnamed: LED801.C, R803.P$2 (2)
unnamed: JP801.2, R801.P$1 (1)
SAFETY: JP801.3, R802.P$1 (1); also elsewhere on the board
VDD_5V: LED801.A, LED802.A; also elsewhere on the board

Notes on the sheet:
LEDs Safety switch
Switch: E-Switch LP1OA1AR
SAFETY
All LEDs nominal target 60mcd for good daylight visibility. Resistor values have been adjusted to optimize BOM. Green: APG1608CGKC/T Vf(typ): 2.1V Target If: 20mA Selected R: 220 Cacluated If @ 5.5V: 15mA Amber: APT1608SECK Vf(typ): 2.1V Target If: 5mA Selected R: 440 Cacluated If @ 5.5V: 8mA Blue: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
BLUE LED REMOVED
