crashmatt/Hardware/PX4uNode_V0_2_1.brd

## EAGLE design PX4uNode_V0_2_1.brd (continued)

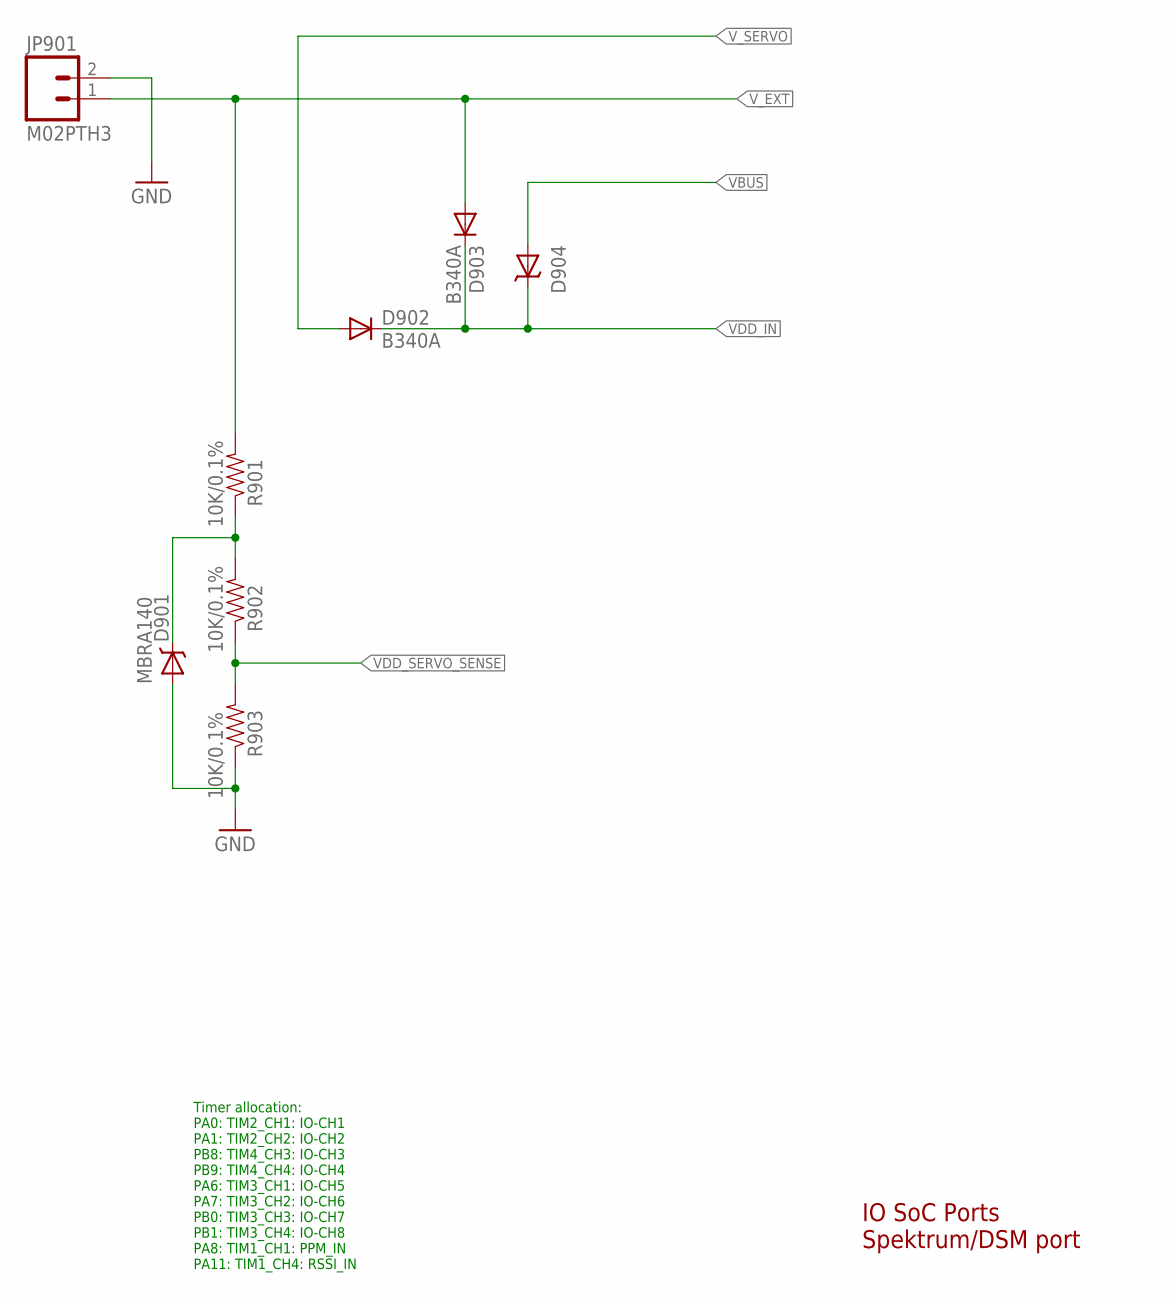
[picture p9: schematic PX4uNode_V0_2_1.sch, sheet 9]

Parts:
D901: DIODE-SCHOTTKY; SOD-523; PARTNO MBRA140
D902, D903: B340A; SMA-DIODE; PARTNO B340A
D904: MSS1P4-M3; MICROSMP; PARTNO MSS1P4-M3/89A
JP901: M02PTH3; 1X02_LONGPADS
R901, R902, R903: 10K/0.1%; 0402-RES; PARTNO ERA-2AEB103X

Connections:
GND: D901.A, JP901.2, R903.P$1 (1); also elsewhere on the board
unnamed: D901.C, R901.P$1 (1), R902.P$2 (2)
VBUS: D904.ANODE (A); also elsewhere on the board
VDD_IN: D902.C, D903.C, D904.CATHODE (C); also elsewhere on the board
VDD_SERVO_SENSE: R902.P$1 (1), R903.P$2 (2); also elsewhere on the board
V_EXT: D903.A, JP901.1, R901.P$2 (2)
V_SERVO: D902.A; also elsewhere on the board

Notes on the sheet:
IO SoC Ports Spektrum/DSM port
Timer allocation: PA0: TIM2_CH1: IO-CH1 PA1: TIM2_CH2: IO-CH2 PB8: TIM4_CH3: IO-CH3 PB9: TIM4_CH4: IO-CH4 PA6: TIM3_CH1: IO-CH5 PA7: TIM3_CH2: IO-CH6 PB0: TIM3_CH3: IO-CH7 PB1: TIM3_CH4: IO-CH8 PA8: TIM1_CH1: PPM_IN PA11: TIM1_CH4: RSSI_IN

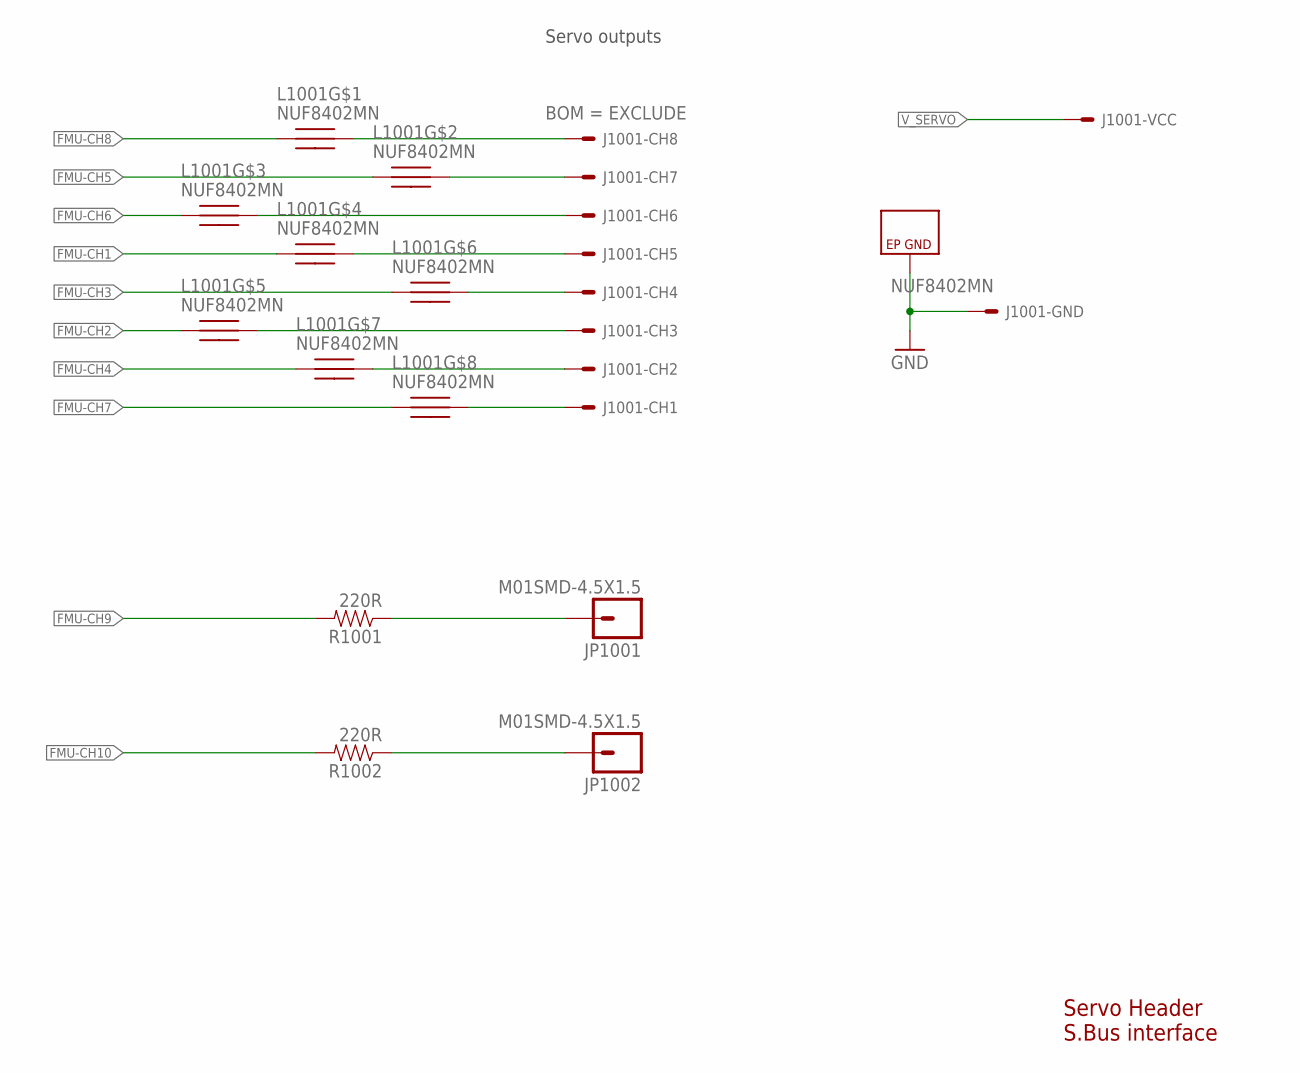
[picture p10: schematic PX4uNode_V0_2_1.sch, sheet 10]

Parts:
J1001: SERVO_HEADER-3X8; 3X8RA_SERVO
JP1001, JP1002: M01SMD-4.5X1.5; PAD-1.5X4.5
L1001: NUF8402MN; DFN16-THIN; PARTNO NUF8402MN
R1001, R1002: 220R; 0402-RES; PARTNO RC0402FR-07220RL

Connections:
FMU-CH1: L1001.P$4; also elsewhere on the board
FMU-CH1-PROT: J1001.S1, L1001.P$9
FMU-CH2: L1001.P$5; also elsewhere on the board
FMU-CH3: L1001.P$6; also elsewhere on the board
FMU-CH4: L1001.P$7; also elsewhere on the board
FMU-CH5: L1001.P$2; also elsewhere on the board
FMU-CH6: L1001.P$3; also elsewhere on the board
FMU-CH7: L1001.P$8; also elsewhere on the board
FMU-CH8: L1001.P$1; also elsewhere on the board
FMU-CH9: R1001.P$2 (2); also elsewhere on the board
FMU-CH10: R1002.P$2 (2); also elsewhere on the board
GND: J1001.GND_S1, J1001.GND_S2, J1001.GND_S3, J1001.GND_S4, J1001.GND_S5, J1001.GND_S6, J1001.GND_S7, J1001.GND_S8, L1001.P$EP (GND); also elsewhere on the board
unnamed: J1001.S8, L1001.P$16
unnamed: J1001.S7, L1001.P$15
unnamed: JP1001.P$1, R1001.P$1 (1)
unnamed: JP1002.P$1, R1002.P$1 (1)
unnamed: J1001.S6, L1001.P$14
unnamed: J1001.S5, L1001.P$13
unnamed: J1001.S4, L1001.P$11
unnamed: J1001.S3, L1001.P$12
unnamed: J1001.S2, L1001.P$10
V_SERVO: J1001.PWR_S1, J1001.PWR_S2, J1001.PWR_S3, J1001.PWR_S4, J1001.PWR_S5, J1001.PWR_S6, J1001.PWR_S7, J1001.PWR_S8; also elsewhere on the board

Notes on the sheet:
Servo Header S.Bus interface
Servo outputs

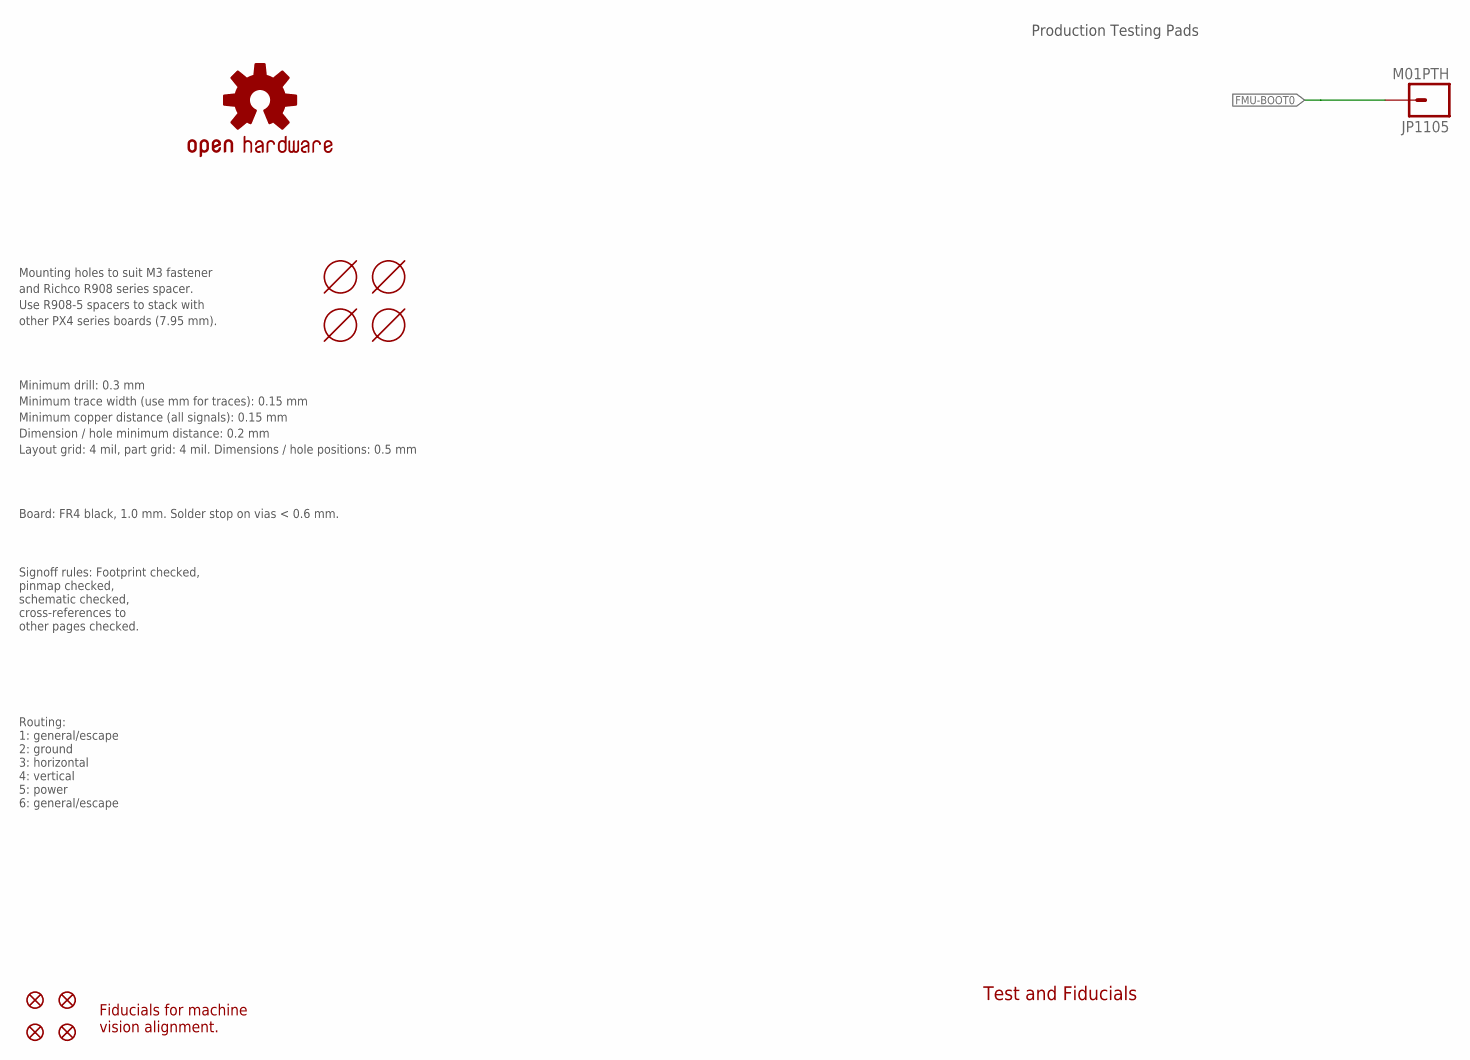
[picture p11: schematic PX4uNode_V0_2_1.sch, sheet 11]

Parts:
JP1101, JP1102, JP1103, JP1104: FIDUCIAL1.5X3; FIDUCIAL-1.5X3; PARTNO *
JP1105: M01PTH; 1X01
M3_MOUNT1101, M3_MOUNT1102, M3_MOUNT1103, M3_MOUNT1104: MOUNT-HOLE3.1MM; MOUNT-HOLE3.1; PARTNO *
OSHW_LOGO: OSHW-LOGOS; OSHW-LOGO-S; PARTNO *

Connections:
FMU-BOOT0: JP1105.1; also elsewhere on the board

Notes on the sheet:
Mounting holes to suit M3 fastener
and Richco R908 series spacer.
Use R908-5 spacers to stack with
other PX4 series boards (7.95 mm).
Production Testing Pads
Test and Fiducials
Minimum drill: 0.3 mm
Minimum trace width (use mm for traces): 0.15 mm
Minimum copper distance (all signals): 0.15 mm
Dimension / hole minimum distance: 0.2 mm
Layout grid: 4 mil, part grid: 4 mil. Dimensions / hole positions: 0.5 mm
Board: FR4 black, 1.0 mm. Solder stop on vias < 0.6 mm.
Signoff rules: Footprint checked, pinmap checked, schematic checked, cross-references to other pages checked.
Routing: 1: general/escape 2: ground 3: horizontal 4: vertical 5: power 6: general/escape
Fiducials for machine vision alignment.

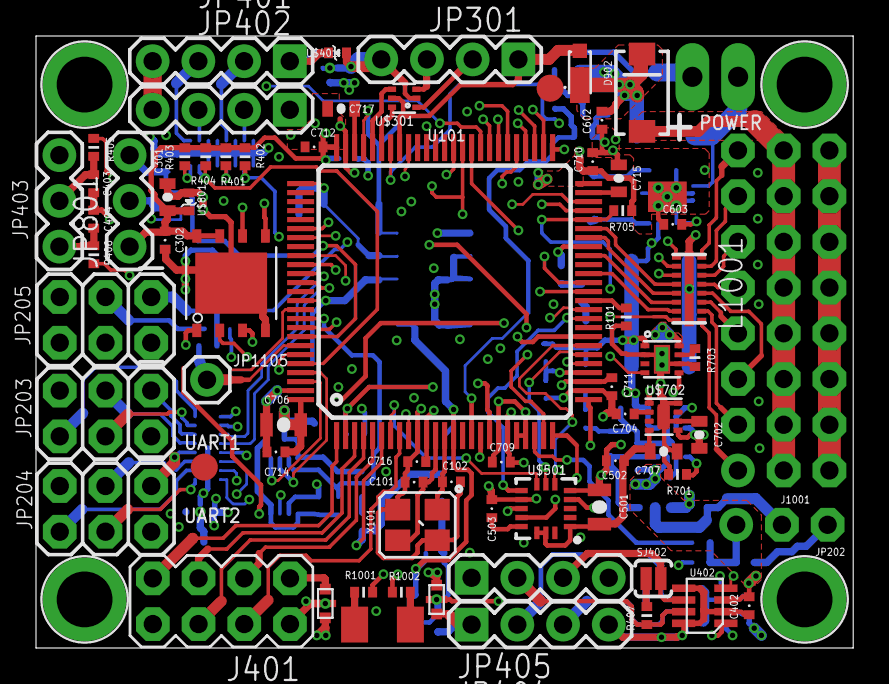
[picture p12: board PX4uNode_V0_2_1.brd from above]

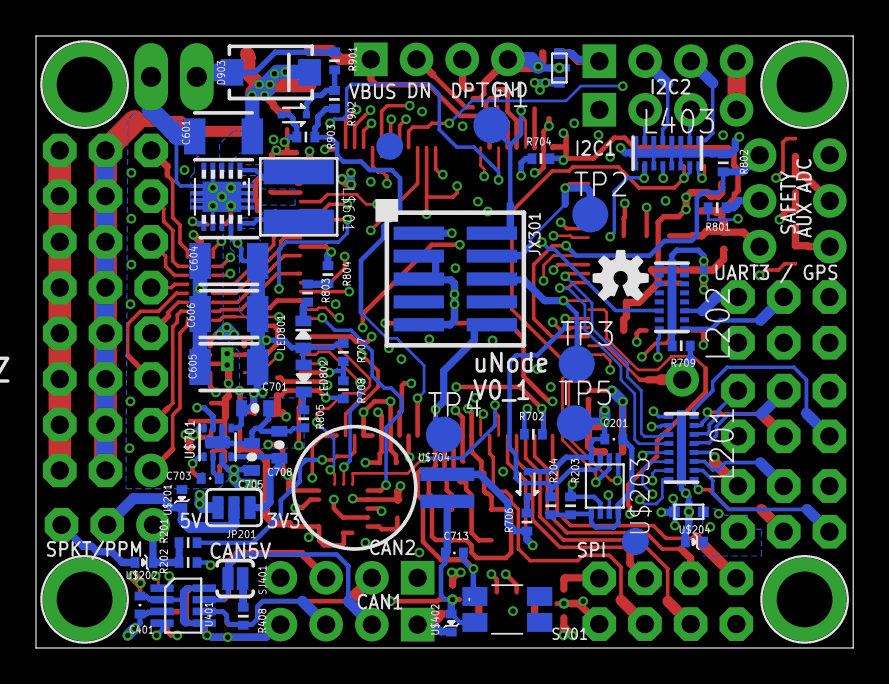
[picture p13: board PX4uNode_V0_2_1.brd from below]

Board: 6 copper layers, 45.4 x 34.0 mm, 138 parts (62 on the bottom side), 136 nets.
