crashmatt/Hardware/PX4mNode_V0_1_1.brd

## EAGLE design PX4mNode_V0_1_1.brd (2014-02-04)

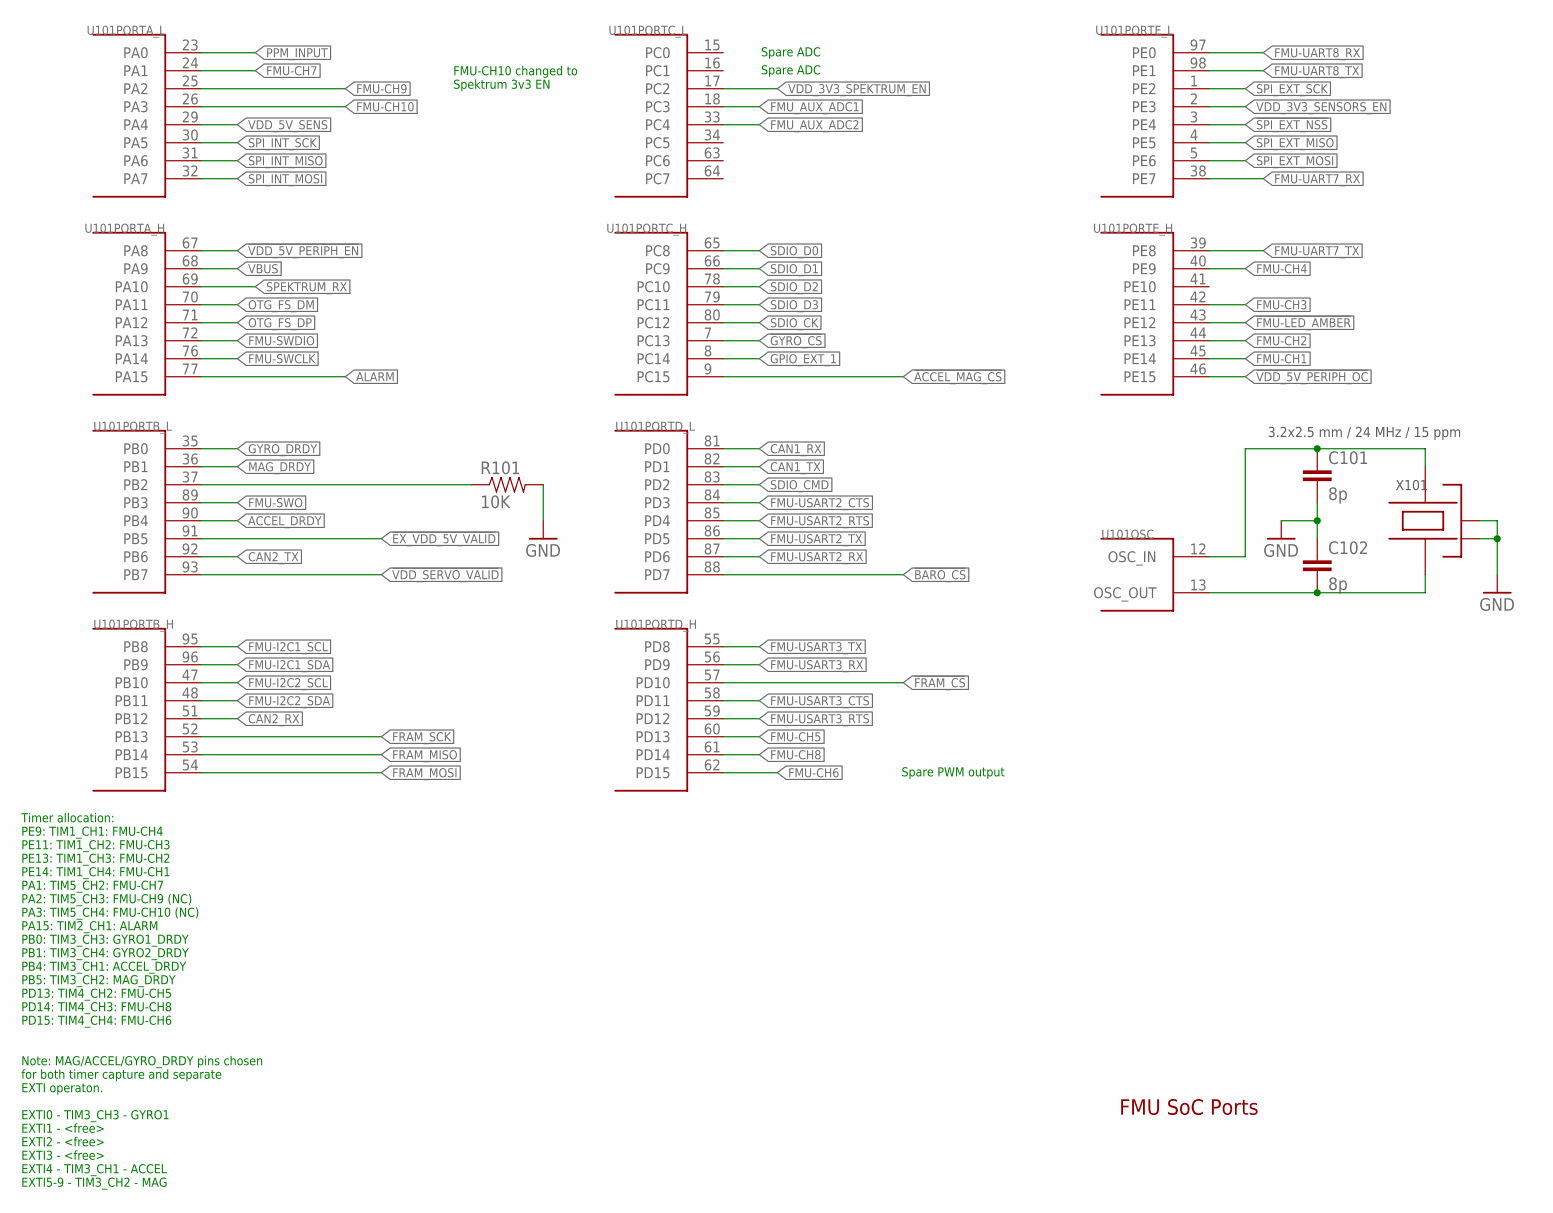
[picture p14: schematic PX4mNode_V0_1_1.sch, sheet 1]

Parts:
C101, C102: 8p; 0402-CAP; PARTNO C1005C0G1H080C
R101: 10K; 0402-RES; PARTNO RC0402FR-0710KL
U101: STM32F4X7VX; TQFP100; PARTNO STM32F427VI
X101: 3.2x2.5 mm / 24 MHz / 15 ppm; OSCILLATOR-3.2X2.5; PARTNO NX3225SA-24.000000MHZ

Connections:
!ACCEL_MAG_CS: U101.9 (PC15)
!BARO_CS: U101.88 (PD7)
!EX_VDD_5V_VALID: U101.91 (PB5)
!FMU-LED_AMBER: U101.43 (PE12); also elsewhere on the board
!FRAM_CS: U101.57 (PD10)
!GYRO_CS: U101.7 (PC13); also elsewhere on the board
!SPI_EXT_NSS: U101.3 (PE4); also elsewhere on the board
!VDD_5V_PERIPH_EN: U101.67 (PA8); also elsewhere on the board
!VDD_5V_PERIPH_OC: U101.46 (PE15); also elsewhere on the board
!VDD_SERVO_VALID: U101.93 (PB7)
ACCEL_DRDY: U101.90 (PB4); also elsewhere on the board
ALARM: U101.77 (PA15)
CAN1_RX: U101.81 (PD0); also elsewhere on the board
CAN1_TX: U101.82 (PD1); also elsewhere on the board
CAN2_RX: U101.51 (PB12); also elsewhere on the board
CAN2_TX: U101.92 (PB6); also elsewhere on the board
FMU-CH1: U101.45 (PE14); also elsewhere on the board
FMU-CH2: U101.44 (PE13); also elsewhere on the board
FMU-CH3: U101.42 (PE11); also elsewhere on the board
FMU-CH4: U101.40 (PE9); also elsewhere on the board
FMU-CH5: U101.60 (PD13); also elsewhere on the board
FMU-CH6: U101.62 (PD15); also elsewhere on the board
FMU-CH7: U101.24 (PA1); also elsewhere on the board
FMU-CH8: U101.61 (PD14); also elsewhere on the board
FMU-CH9: U101.25 (PA2); also elsewhere on the board
FMU-CH10: U101.26 (PA3); also elsewhere on the board
FMU-I2C1_SCL: U101.95 (PB8); also elsewhere on the board
FMU-I2C1_SDA: U101.96 (PB9); also elsewhere on the board
FMU-I2C2_SCL: U101.47 (PB10); also elsewhere on the board
FMU-I2C2_SDA: U101.48 (PB11); also elsewhere on the board
FMU-SWCLK: U101.76 (PA14); also elsewhere on the board
FMU-SWDIO: U101.72 (PA13); also elsewhere on the board
FMU-SWO: U101.89 (PB3); also elsewhere on the board
FMU-UART7_RX: U101.38 (PE7); also elsewhere on the board
FMU-UART7_TX: U101.39 (PE8); also elsewhere on the board
FMU-UART8_RX: U101.97 (PE0); also elsewhere on the board
FMU-UART8_TX: U101.98 (PE1); also elsewhere on the board
FMU-USART2_CTS: U101.84 (PD3); also elsewhere on the board
FMU-USART2_RTS: U101.85 (PD4); also elsewhere on the board
FMU-USART2_RX: U101.87 (PD6); also elsewhere on the board
FMU-USART2_TX: U101.86 (PD5); also elsewhere on the board
FMU-USART3_CTS: U101.58 (PD11); also elsewhere on the board
FMU-USART3_RTS: U101.59 (PD12); also elsewhere on the board
FMU-USART3_RX: U101.56 (PD9); also elsewhere on the board
FMU-USART3_TX: U101.55 (PD8); also elsewhere on the board
FMU_AUX_ADC1: U101.18 (PC3); also elsewhere on the board
FMU_AUX_ADC2: U101.33 (PC4); also elsewhere on the board
FRAM_MISO: U101.53 (PB14)
FRAM_MOSI: U101.54 (PB15)
FRAM_SCK: U101.52 (PB13)
GND: C101.P$2 (2), C102.P$1 (1), R101.P$2 (2), X101.2 (NC_2), X101.4 (NC_4); also elsewhere on the board
GPIO_EXT_1: U101.8 (PC14); also elsewhere on the board
GYRO_DRDY: U101.35 (PB0); also elsewhere on the board
MAG_DRDY: U101.36 (PB1); also elsewhere on the board
unnamed: C102.P$2 (2), U101.13 (OSC_OUT), X101.1
unnamed: C101.P$1 (1), U101.12 (OSC_IN), X101.3
OTG_FS_DM: U101.70 (PA11); also elsewhere on the board
OTG_FS_DP: U101.71 (PA12); also elsewhere on the board
PB2-BOOT1: R101.P$1 (1), U101.37 (PB2)
PPM_INPUT: U101.23 (PA0); also elsewhere on the board
SDIO_CK: U101.80 (PC12); also elsewhere on the board
SDIO_CMD: U101.83 (PD2); also elsewhere on the board
SDIO_D0: U101.65 (PC8); also elsewhere on the board
SDIO_D1: U101.66 (PC9); also elsewhere on the board
SDIO_D2: U101.78 (PC10); also elsewhere on the board
SDIO_D3: U101.79 (PC11); also elsewhere on the board
SPEKTRUM_RX: U101.69 (PA10); also elsewhere on the board
SPI_EXT_MISO: U101.4 (PE5); also elsewhere on the board
SPI_EXT_MOSI: U101.5 (PE6); also elsewhere on the board
SPI_EXT_SCK: U101.1 (PE2); also elsewhere on the board
SPI_INT_MISO: U101.31 (PA6); also elsewhere on the board
SPI_INT_MOSI: U101.32 (PA7); also elsewhere on the board
SPI_INT_SCK: U101.30 (PA5); also elsewhere on the board
VBUS: U101.68 (PA9); also elsewhere on the board
VDD_3V3_SENSORS_EN: U101.2 (PE3); also elsewhere on the board
VDD_3V3_SPEKTRUM_EN: U101.17 (PC2); also elsewhere on the board
VDD_5V_SENS: U101.29 (PA4); also elsewhere on the board

Notes on the sheet:
FMU SoC Ports
Note: MAG/ACCEL/GYRO_DRDY pins chosen for both timer capture and separate EXTI operaton. EXTI0 - TIM3_CH3 - GYRO1 EXTI1 - <free> EXTI2 - <free> EXTI3 - <free> EXTI4 - TIM3_CH1 - ACCEL EXTI5-9 - TIM3_CH2 - MAG
Timer allocation: PE9: TIM1_CH1: FMU-CH4 PE11: TIM1_CH2: FMU-CH3 PE13: TIM1_CH3: FMU-CH2 PE14: TIM1_CH4: FMU-CH1 PA1: TIM5_CH2: FMU-CH7 PA2: TIM5_CH3: FMU-CH9 (NC) PA3: TIM5_CH4: FMU-CH10 (NC) PA15: TIM2_CH1: ALARM PB0: TIM3_CH3: GYRO1_DRDY PB1: TIM3_CH4: GYRO2_DRDY PB4: TIM3_CH1: ACCEL_DRDY PB5: T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
Spare PWM output
Spare ADC
FMU-CH10 changed to Spektrum 3v3 EN

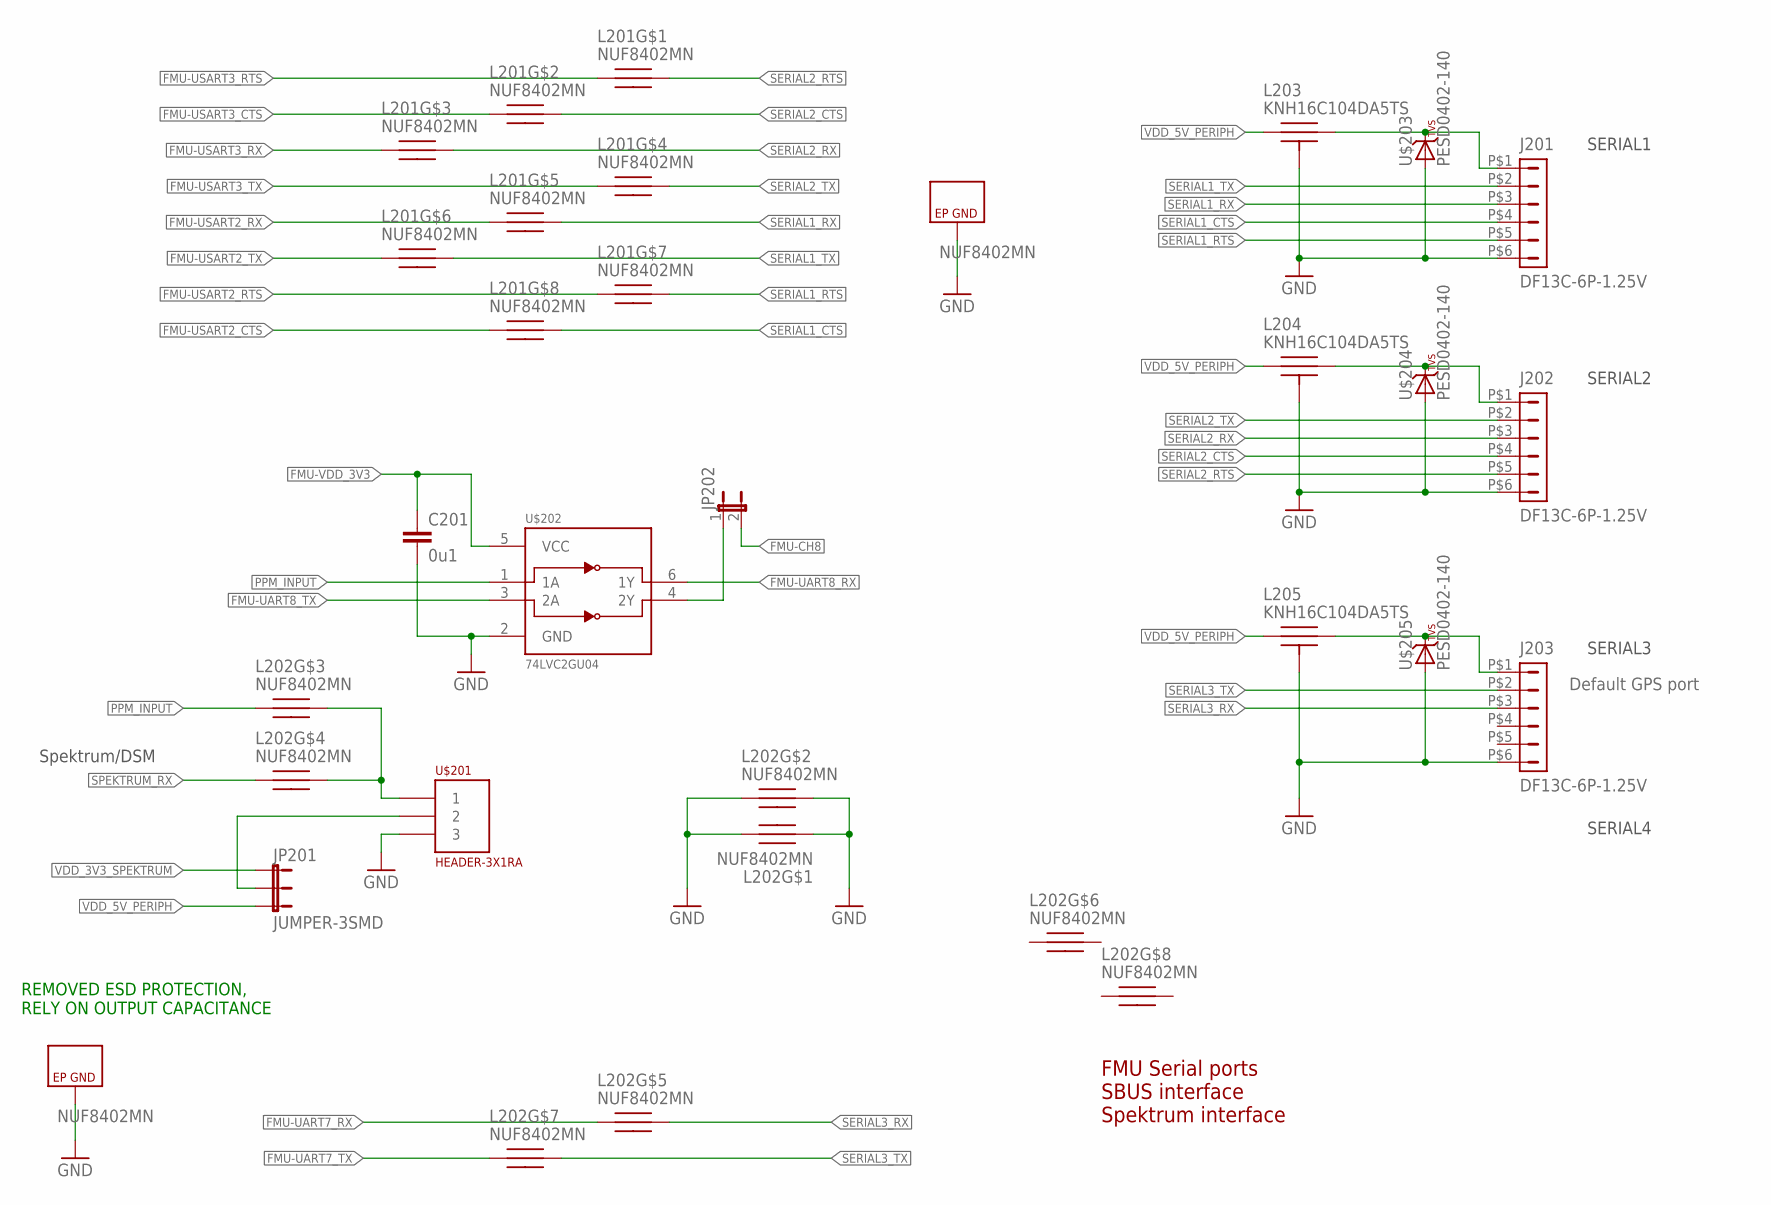
[picture p15: schematic PX4mNode_V0_1_1.sch, sheet 2]

Parts:
C201: 0u1; 0402-CAP; PARTNO CC0402ZRY5V7BB104
J201, J202, J203: DF13C-6P-1.25V; PARTNO DF13C-6P-1.25V(20)
JP201: JUMPER-3SMD; SJ_3
JP202: JUMPER-2SMD-NO; SJ_2S-NO
L201, L202: NUF8402MN; DFN16-THIN
L203, L204, L205: KNH16C104DA5TS; KYOCERA-KNH16-DA; PARTNO KNH16C104DA5TS
U$201: HEADER-3X1RA; 3X1RA
U$202: 74LVC2GU04; SOT363_PHILIPS; PARTNO 74LVC2GU04
U$203, U$204, U$205: PESD0402-140; 0402-TVS; PARTNO PESD0402-140

Connections:
5V_S1_FILTERED: J201.P$1 (1), L203.P$2, U$203.C
5V_S2_FILTERED: J202.P$1 (1), L204.P$2, U$204.C
5V_S3_FILTERED: J203.P$1 (1), L205.P$2, U$205.C
FMU-CH8: JP202.2; also elsewhere on the board
FMU-UART7_RX: L202.P$5; also elsewhere on the board
FMU-UART7_TX: L202.P$7; also elsewhere on the board
FMU-UART8_RX: U$202.6 (1Y); also elsewhere on the board
FMU-UART8_TX: U$202.3 (2A); also elsewhere on the board
FMU-USART2_CTS: L201.P$8; also elsewhere on the board
FMU-USART2_RTS: L201.P$7; also elsewhere on the board
FMU-USART2_RX: L201.P$5; also elsewhere on the board
FMU-USART2_TX: L201.P$6; also elsewhere on the board
FMU-USART3_CTS: L201.P$2; also elsewhere on the board
FMU-USART3_RTS: L201.P$1; also elsewhere on the board
FMU-USART3_RX: L201.P$3; also elsewhere on the board
FMU-USART3_TX: L201.P$4; also elsewhere on the board
FMU-VDD_3V3: C201.P$1 (1), U$202.5 (VCC); also elsewhere on the board
GND: C201.P$2 (2), J201.P$6 (6), J202.P$6 (6), J203.P$6 (6), L201.P$EP (GND), L202.P$1, L202.P$2, L202.P$15, L202.P$16, L202.P$EP (GND), L203.P$3, L203.P$4, L203.P$5, L204.P$3, L204.P$4, L204.P$5, L205.P$3, L205.P$4, L205.P$5, U$201.3, U$202.2 (GND), U$203.A, U$204.A, U$205.A; also elsewhere on the board
unnamed: JP202.1, U$202.4 (2Y)
unnamed: L202.P$13, L202.P$14, U$201.1
PPM_INPUT: L202.P$3, U$202.1 (1A); also elsewhere on the board
SERIAL1_CTS: J201.P$4 (4), L201.P$9
SERIAL1_RTS: J201.P$5 (5), L201.P$10
SERIAL1_RX: J201.P$3 (3), L201.P$12
SERIAL1_TX: J201.P$2 (2), L201.P$11
SERIAL2_CTS: J202.P$4 (4), L201.P$15
SERIAL2_RTS: J202.P$5 (5), L201.P$16
SERIAL2_RX: J202.P$3 (3), L201.P$14
SERIAL2_TX: J202.P$2 (2), L201.P$13
SERIAL3_RX: J203.P$3 (3), L202.P$12
SERIAL3_TX: J203.P$2 (2), L202.P$10
SPEKTRUM_RX: L202.P$4; also elsewhere on the board
VDD_3V3_SPEKTRUM: JP201.1; also elsewhere on the board
VDD_5V_PERIPH: JP201.3, L203.P$1, L204.P$1, L205.P$1; also elsewhere on the board
VDD_RX_POWER: JP201.2, U$201.2

Notes on the sheet:
FMU Serial ports SBUS interface Spektrum interface
SERIAL2
SERIAL1
SERIAL3
SERIAL4
Default GPS port
Spektrum/DSM
REMOVED ESD PROTECTION, RELY ON OUTPUT CAPACITANCE

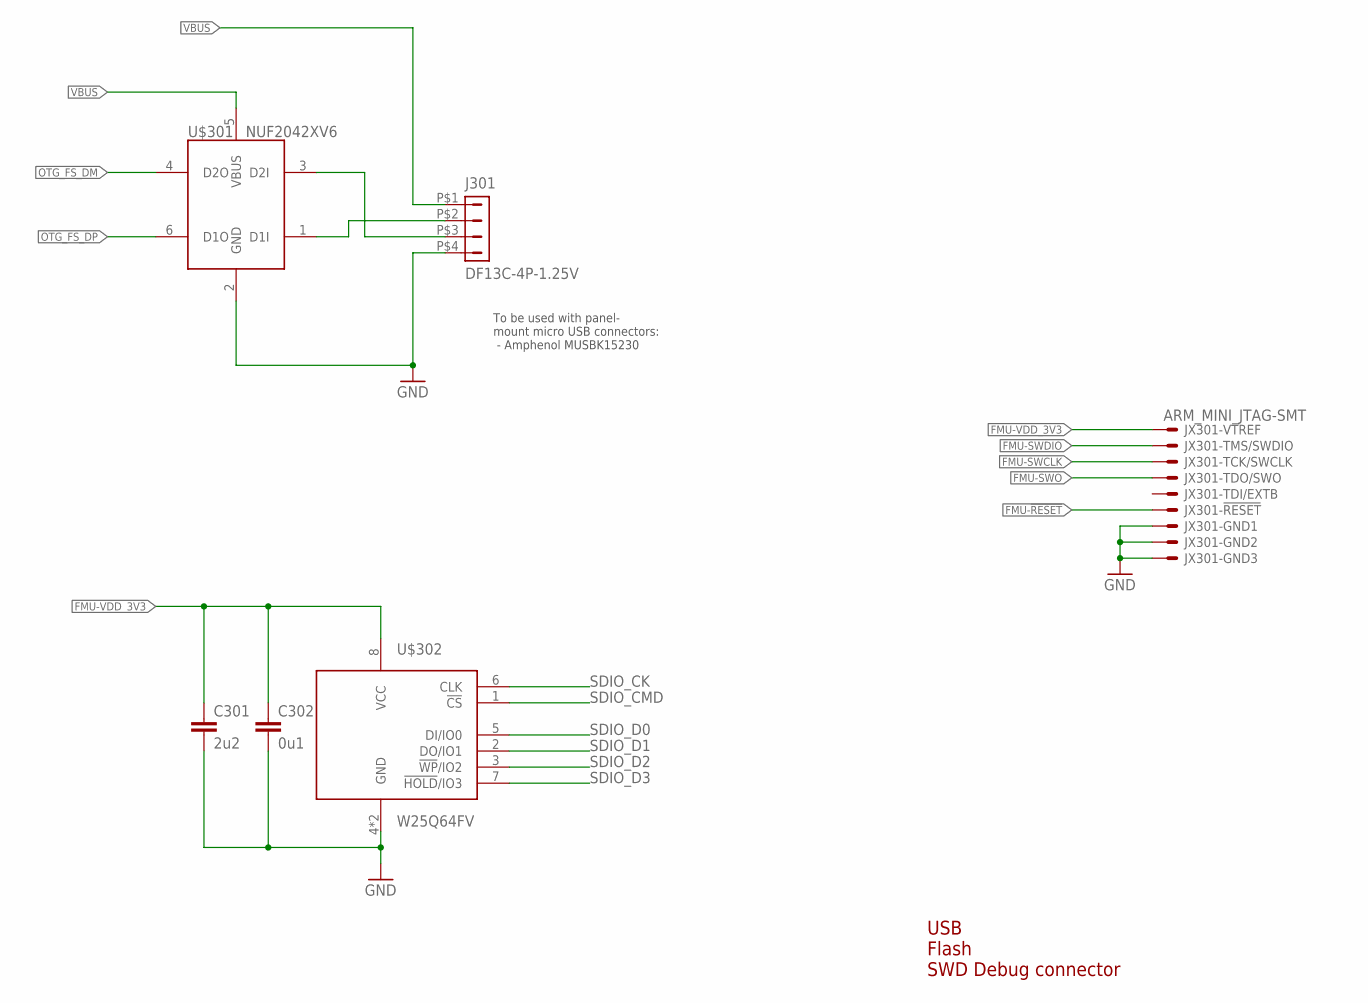
[picture p16: schematic PX4mNode_V0_1_1.sch, sheet 3]

Parts:
C301: 2u2; 0603-CAP; PARTNO C1608Y5V1C225Z
C302: 0u1; 0402-CAP; PARTNO CC0402ZRY5V7BB104
J301: DF13C-4P-1.25V; PARTNO DF13C-4P-1.25V(20)
JX301: ARM_MINI_JTAG-SMT; FTSH-105-01-XXX-DV-K; PARTNO M50-3900542
U$301: NUF2042XV6; SOT563-6
U$302: W25Q64FV; WSON-8-5X6

Connections:
FMU-!RESET: JX301.10; also elsewhere on the board
FMU-SWCLK: JX301.4; also elsewhere on the board
FMU-SWDIO: JX301.2; also elsewhere on the board
FMU-SWO: JX301.6; also elsewhere on the board
FMU-VDD_3V3: C301.P$1 (1), C302.P$1 (1), JX301.1, U$302.8 (VCC); also elsewhere on the board
GND: C301.P$2 (2), C302.P$2 (2), J301.P$4 (4), JX301.3, JX301.5, JX301.9, U$301.2 (GND), U$302.4 (GND), U$302.PAD (GND); also elsewhere on the board
OTG_DM1: J301.P$3 (3), U$301.3 (D2I)
OTG_DP1: J301.P$2 (2), U$301.1 (D1I)
OTG_FS_DM: U$301.4 (D2O); also elsewhere on the board
OTG_FS_DP: U$301.6 (D1O); also elsewhere on the board
SDIO_CK: U$302.6 (CLK); also elsewhere on the board
SDIO_CMD: U$302.1 (!CS); also elsewhere on the board
SDIO_D0: U$302.5 (DI/IO0); also elsewhere on the board
SDIO_D1: U$302.2 (DO/IO1); also elsewhere on the board
SDIO_D2: U$302.3 (!WP!/IO2); also elsewhere on the board
SDIO_D3: U$302.7 (!HOLD!/IO3); also elsewhere on the board
VBUS: J301.P$1 (1), U$301.5 (VBUS); also elsewhere on the board

Notes on the sheet:
USB Flash SWD Debug connector
To be used with panel- mount micro USB connectors: - Amphenol MUSBK15230

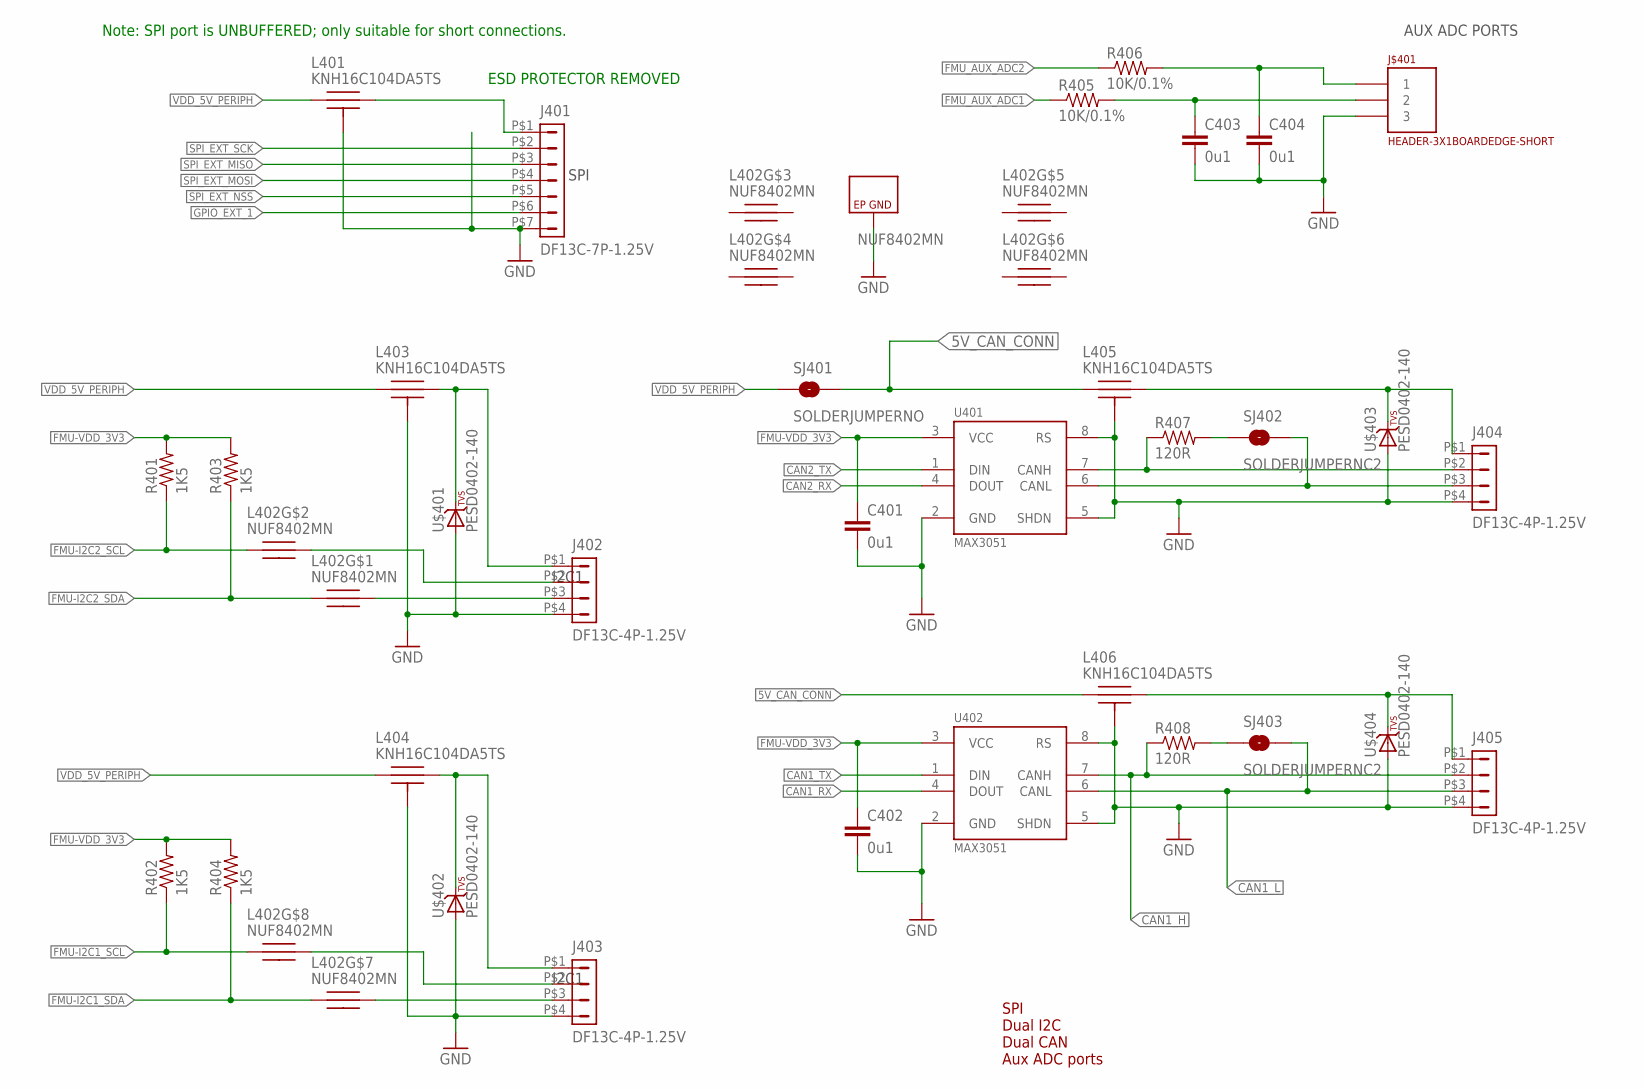
[picture p17: schematic PX4mNode_V0_1_1.sch, sheet 4]

Parts:
C401, C402, C403, C404: 0u1; 0402-CAP; PARTNO CC0402ZRY5V7BB104
J401: DF13C-7P-1.25V; PARTNO DF13C-7P-1.25V(20)
J402, J403, J404, J405: DF13C-4P-1.25V; PARTNO DF13C-4P-1.25V(20)
J$401: HEADER-3X1BOARDEDGE-SHORT; HEADER_3X01_SMD_H_BOARD_EDGE_SHORT
L401, L403, L404, L405, L406: KNH16C104DA5TS; KYOCERA-KNH16-DA; PARTNO KNH16C104DA5TS
L402: NUF8402MN; DFN16-THIN
R401, R402, R403, R404: 1K5; 0402-RES; PARTNO RC0402FR-071K5L
R405, R406: 10K/0.1%; 0402-RES; PARTNO ERA-2AEB103X
R407, R408: 120R; 0402-RES; PARTNO RC0402FR-07120RL
SJ401: SOLDERJUMPERNO; SJ_2S-NO
SJ402, SJ403: SOLDERJUMPERNC2; SJ_2S-NOTRACE
U401, U402: MAX3051; SOT23-8; PARTNO MAX3051EKA
U$401, U$402, U$403, U$404: PESD0402-140; 0402-TVS; PARTNO PESD0402-140

Connections:
5V_CAN_CONN: L405.P$1, L406.P$1, SJ401.2
!SPI_EXT_NSS: J401.P$5 (5); also elsewhere on the board
CAN1_H: J405.P$2 (2), R408.P$1 (1), U402.7 (CANH)
CAN1_L: J405.P$3 (3), SJ403.2, U402.6 (CANL)
CAN1_RX: U402.4 (DOUT); also elsewhere on the board
CAN1_TX: U402.1 (DIN); also elsewhere on the board
CAN2_H: J404.P$2 (2), R407.P$1 (1), U401.7 (CANH)
CAN2_L: J404.P$3 (3), SJ402.2, U401.6 (CANL)
CAN2_RX: U401.4 (DOUT); also elsewhere on the board
CAN2_TX: U401.1 (DIN); also elsewhere on the board
FMU-I2C1_SCL: L402.P$8, R402.P$1 (1); also elsewhere on the board
FMU-I2C1_SDA: L402.P$7, R404.P$1 (1); also elsewhere on the board
FMU-I2C2_SCL: L402.P$2, R401.P$1 (1); also elsewhere on the board
FMU-I2C2_SDA: L402.P$1, R403.P$1 (1); also elsewhere on the board
FMU-VDD_3V3: C401.P$1 (1), C402.P$1 (1), R401.P$2 (2), R402.P$2 (2), R403.P$2 (2), R404.P$2 (2), U401.3 (VCC), U402.3 (VCC); also elsewhere on the board
FMU_AUX_ADC1: R405.P$1 (1); also elsewhere on the board
FMU_AUX_ADC1_PROT: C403.P$1 (1), J$401.2, R405.P$2 (2)
FMU_AUX_ADC2: R406.P$1 (1); also elsewhere on the board
FMU_AUX_ADC2_PROT: C404.P$1 (1), J$401.1, R406.P$2 (2)
GND: C401.P$2 (2), C402.P$2 (2), C403.P$2 (2), C404.P$2 (2), J401.P$7 (7), J402.P$4 (4), J403.P$4 (4), J404.P$4 (4), J405.P$4 (4), J$401.3, L401.P$3, L401.P$4, L401.P$5, L402.P$EP (GND), L403.P$3, L403.P$4, L403.P$5, L404.P$3, L404.P$4, L404.P$5, L405.P$3, L405.P$4, L405.P$5, L406.P$3, L406.P$4, L406.P$5, U401.2 (GND), U401.5 (SHDN), U401.8 (RS), U402.2 (GND), U402.5 (SHDN), U402.8 (RS), U$401.A, U$402.A, U$403.A, U$404.A; also elsewhere on the board
GPIO_EXT_1: J401.P$6 (6); also elsewhere on the board
unnamed: J402.P$2 (2), L402.P$15
unnamed: J402.P$3 (3), L402.P$16
unnamed: J402.P$1 (1), L403.P$2, U$401.C
unnamed: R408.P$2 (2), SJ403.1
unnamed: J404.P$1 (1), L405.P$2, U$403.C
unnamed: R407.P$2 (2), SJ402.1
unnamed: J403.P$2 (2), L402.P$9
unnamed: J403.P$3 (3), L402.P$10
unnamed: J401.P$1 (1), L401.P$2
unnamed: J403.P$1 (1), L404.P$2, U$402.C
unnamed: J405.P$1 (1), L406.P$2, U$404.C
SPI_EXT_MISO: J401.P$3 (3); also elsewhere on the board
SPI_EXT_MOSI: J401.P$4 (4); also elsewhere on the board
SPI_EXT_SCK: J401.P$2 (2); also elsewhere on the board
VDD_5V_PERIPH: L401.P$1, L403.P$1, L404.P$1, SJ401.1; also elsewhere on the board

Notes on the sheet:
SPI
I2C1
AUX ADC PORTS
SPI Dual I2C Dual CAN Aux ADC ports
Note: SPI port is UNBUFFERED; only suitable for short connections.
ESD PROTECTOR REMOVED
