crashmatt/Hardware/PX4mNode_V0_1_1.brd

## EAGLE design PX4mNode_V0_1_1.brd (continued)


Parts:
C501: 10u/10V; 0805-CAP; PARTNO CC0805ZKY5V6BB106
C502: 10n; 0402-CAP; PARTNO CC0402KRX7R7BB103
C503: 0u1; 0402-CAP; PARTNO CC0402ZRY5V7BB104
U$501: MAX21100; 16LGA-3X3

Connections:
!GYRO_CS: U$501.8 (CS); also elsewhere on the board
ACCEL_DRDY: U$501.11 (INT1); also elsewhere on the board
GND: C501.P$2 (2), C502.P$2 (2), C503.P$2 (2), U$501.5 (GND), U$501.10 (RSV1); also elsewhere on the board
GYRO_DRDY: U$501.9 (INT2); also elsewhere on the board
MAG_DRDY: U$501.12 (DSYNC); also elsewhere on the board
REGD: C503.P$1 (1), U$501.13 (REGD)
SPI_INT_MISO: U$501.7 (SA0/MISO); also elsewhere on the board
SPI_INT_MOSI: U$501.6 (SDA/MOSI); also elsewhere on the board
SPI_INT_SCK: U$501.4 (SCL/CLK); also elsewhere on the board
VDD_3V3_SENSORS: C501.P$1 (1), C502.P$1 (1), U$501.1 (VDD_IO), U$501.14 (VDD), U$501.15 (RSV2); also elsewhere on the board

Notes on the sheet:
Sensors
Bypass caps as close to device pins as possible.

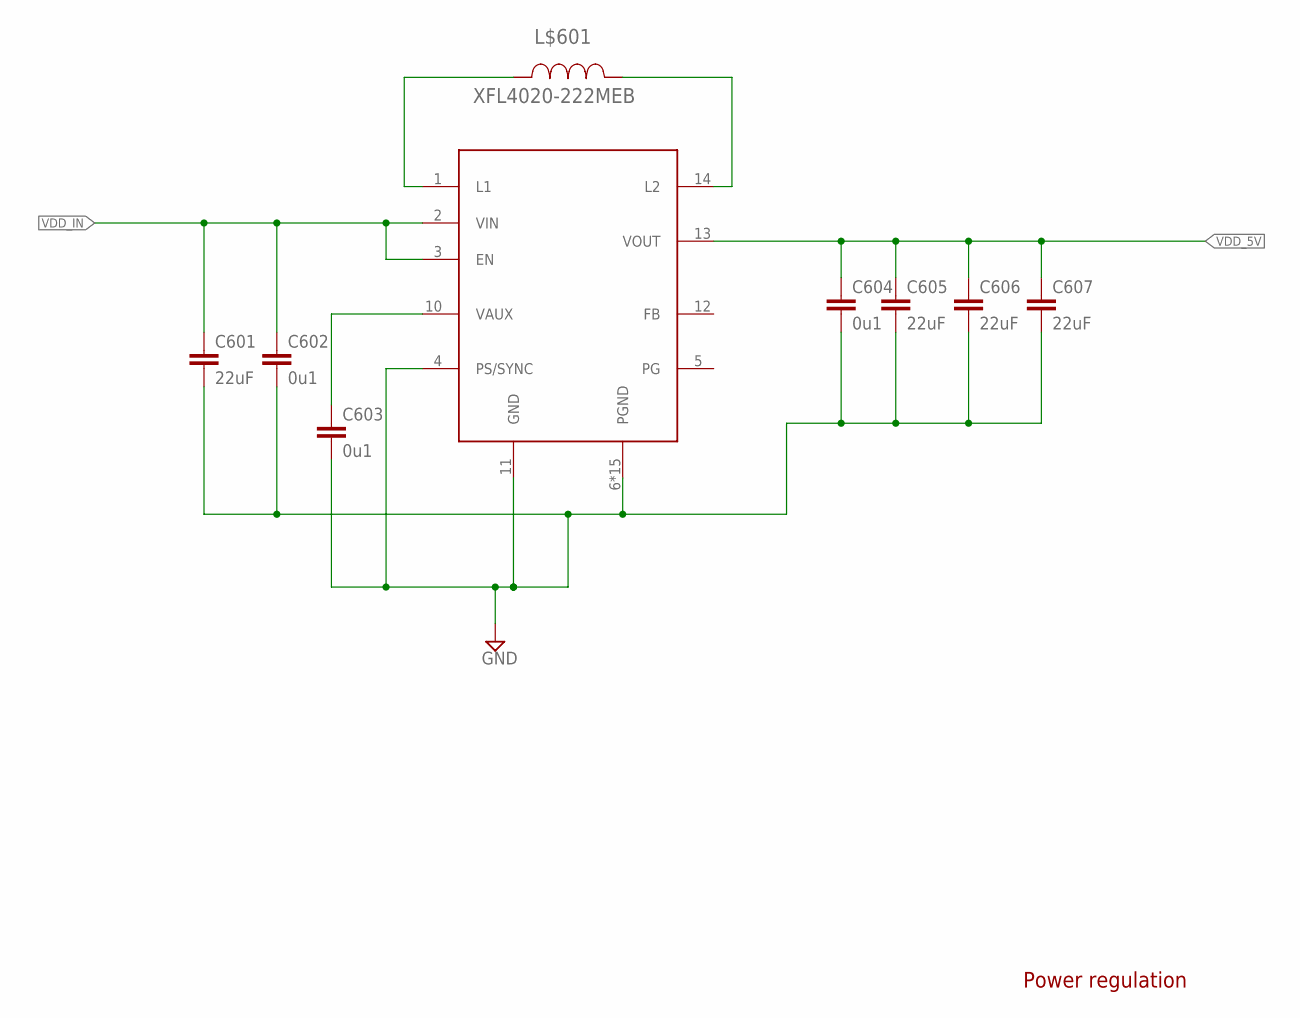
[picture p18: schematic PX4mNode_V0_1_1.sch, sheet 6]

Parts:
C601, C605, C606, C607: 22uF; 1210
C602, C603, C604: 0u1; 0402-CAP; PARTNO CC0402ZRY5V7BB104
L$601: XFL4020-222MEB; XFL4020
U$601: TPS6303X; PWSON10

Connections:
GND: C601.2, C602.P$2 (2), C603.P$2 (2), C604.P$2 (2), C605.2, C606.2, C607.2, U$601.4 (PS/SYNC), U$601.6 (PGND), U$601.7 (PGND), U$601.8 (PGND), U$601.9 (PGND), U$601.11 (GND), U$601.15 (PGND), U$601.16 (PGND), U$601.17 (PGND), U$601.18 (PGND), U$601.19 (PGND), U$601.20 (PGND), U$601.21 (PGND), U$601.22 (PGND), U$601.23 (PGND), U$601.EP (PGND), U$601.EP1 (PGND); also elsewhere on the board
unnamed: L$601.1, U$601.14 (L2)
unnamed: L$601.2, U$601.1 (L1)
unnamed: C603.P$1 (1), U$601.10 (VAUX)
VDD_5V: C604.P$1 (1), C605.1, C606.1, C607.1, U$601.13 (VOUT); also elsewhere on the board
VDD_IN: C601.1, C602.P$1 (1), U$601.2 (VIN), U$601.3 (EN); also elsewhere on the board

Notes on the sheet:
Power regulation

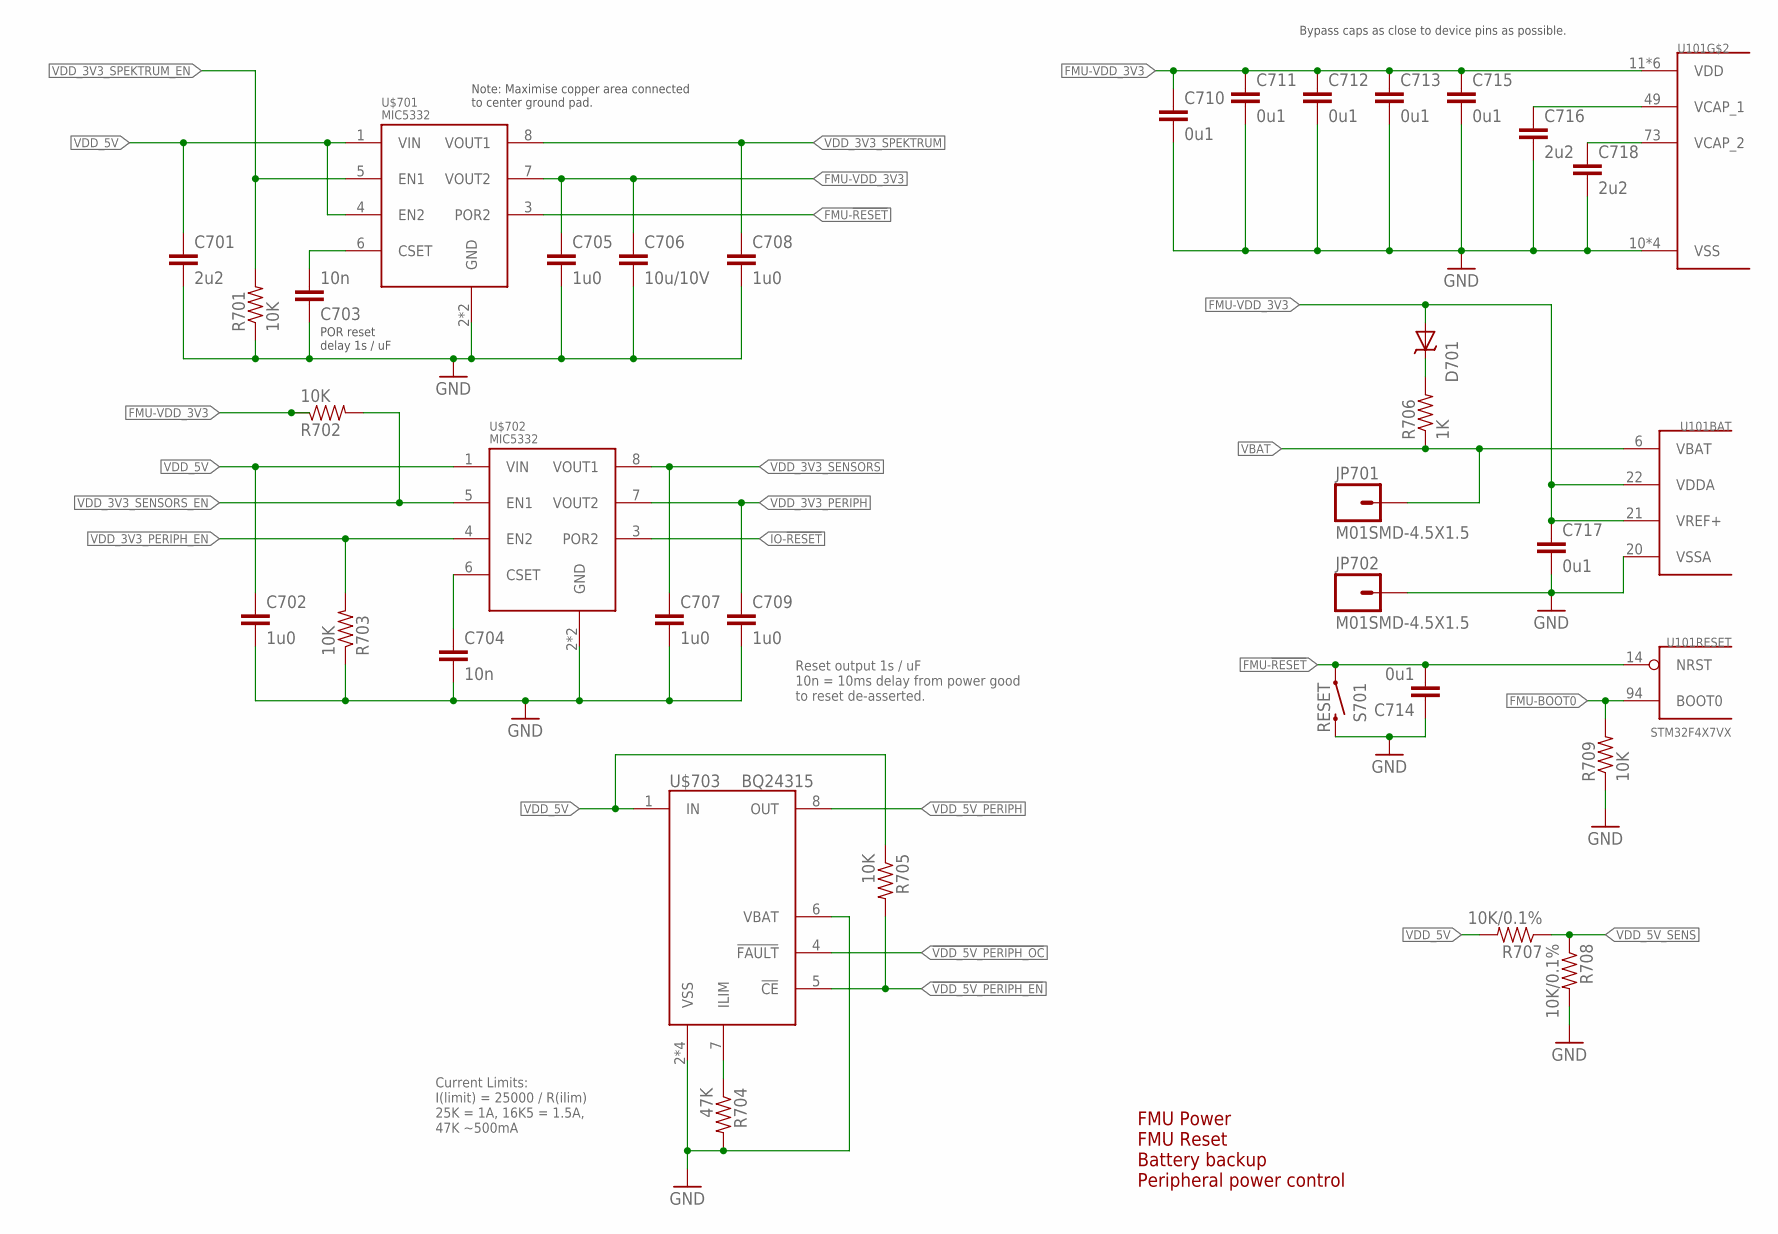
[picture p19: schematic PX4mNode_V0_1_1.sch, sheet 7]

Parts:
C701, C716, C718: 2u2; 0603-CAP; PARTNO C1608Y5V1C225Z
C702, C705, C707, C708, C709: 1u0; 0603-CAP; PARTNO CC0603ZRY5V7BB105
C703, C704: 10n; 0402-CAP; PARTNO CC0402KRX7R7BB103
C706: 10u/10V; 0805-CAP; PARTNO CC0805ZKY5V6BB106
C710, C711, C712, C713, C714, C715, C717: 0u1; 0402-CAP; PARTNO CC0402ZRY5V7BB104
D701: MSS1P4-M3; MICROSMP; PARTNO MSS1P4-M3/89A
JP701, JP702: M01SMD-4.5X1.5; PAD-1.5X4.5
R701, R702, R703, R705, R709: 10K; 0402-RES; PARTNO RC0402FR-0710KL
R704: 47K; 0402-RES; PARTNO RMCF0402FT47K
R706: 1K; 0402-RES; PARTNO RC0402FR-071KL
R707, R708: 10K/0.1%; 0402-RES; PARTNO ERA-2AEB103X
S701: RESET; EVQP7J01K; PARTNO EVQP7J01K
U101: STM32F4X7VX; TQFP100; PARTNO STM32F427VI
U$701, U$702: MIC5332; MLF-8-EPAD; PARTNO MIC5332-SSYMT
U$703: BQ24315; QFN8-DSG; PARTNO BQ24315DSGR

Connections:
!VDD_5V_PERIPH_EN: R705.P$2 (2), U$703.5 (!CE); also elsewhere on the board
!VDD_5V_PERIPH_OC: U$703.4 (!FAULT); also elsewhere on the board
FMU-!RESET: C714.P$2 (2), S701.A1 (1), U101.14 (NRST), U$701.3 (POR2); also elsewhere on the board
FMU-BOOT0: R709.P$2 (2), U101.94 (BOOT0); also elsewhere on the board
FMU-VDD_3V3: C705.P$1 (1), C706.P$1 (1), C710.P$1 (1), C711.P$1 (1), C712.P$1 (1), C713.P$1 (1), C715.P$1 (1), C717.P$1 (1), D701.ANODE (A), R702.P$1 (1), U101.11 (VDD), U101.19 (VDD), U101.21 (VREF+), U101.22 (VDDA), U101.28 (VDD), U101.50 (VDD), U101.75 (VDD), U101.100 (VDD), U$701.7 (VOUT2); also elsewhere on the board
GND: C701.P$2 (2), C702.P$2 (2), C703.P$1 (1), C704.P$2 (2), C705.P$2 (2), C706.P$2 (2), C707.P$2 (2), C708.P$2 (2), C709.P$2 (2), C710.P$2 (2), C711.P$2 (2), C712.P$2 (2), C713.P$2 (2), C714.P$1 (1), C715.P$2 (2), C716.P$2 (2), C717.P$2 (2), C718.P$2 (2), JP702.P$1, R701.P$1 (1), R703.P$1 (1), R704.P$2 (2), R708.P$2 (2), R709.P$1 (1), S701.B3 (2), U101.10 (VSS), U101.20 (VSSA), U101.27 (VSS), U101.74 (VSS), U101.99 (VSS), U$701.2 (GND), U$701.GND, U$702.2 (GND), U$702.GND, U$703.2 (VSS), U$703.6 (VBAT), U$703.GND (VSS), U$703.P$2 (VSS), U$703.P$3 (VSS); also elsewhere on the board
IO-!RESET: U$702.3 (POR2)
unnamed: C718.P$1 (1), U101.73 (VCAP_2)
unnamed: D701.CATHODE (C), R706.P$2 (2)
unnamed: C703.P$2 (2), U$701.6 (CSET)
unnamed: C716.P$1 (1), U101.49 (VCAP_1)
unnamed: R704.P$1 (1), U$703.7 (ILIM)
unnamed: C704.P$1 (1), U$702.6 (CSET)
VBAT: JP701.P$1, R706.P$1 (1), U101.6 (VBAT)
VDD_3V3_PERIPH: C709.P$1 (1), U$702.7 (VOUT2)
VDD_3V3_PERIPH_EN: R703.P$2 (2), U$702.4 (EN2)
VDD_3V3_SENSORS: C707.P$1 (1), U$702.8 (VOUT1); also elsewhere on the board
VDD_3V3_SENSORS_EN: R702.P$2 (2), U$702.5 (EN1); also elsewhere on the board
VDD_3V3_SPEKTRUM: C708.P$1 (1), U$701.8 (VOUT1); also elsewhere on the board
VDD_3V3_SPEKTRUM_EN: R701.P$2 (2), U$701.5 (EN1); also elsewhere on the board
VDD_5V: C701.P$1 (1), C702.P$1 (1), R705.P$1 (1), R707.P$2 (2), U$701.1 (VIN), U$701.4 (EN2), U$702.1 (VIN), U$703.1 (IN); also elsewhere on the board
VDD_5V_PERIPH: U$703.8 (OUT); also elsewhere on the board
VDD_5V_SENS: R707.P$1 (1), R708.P$1 (1); also elsewhere on the board

Notes on the sheet:
FMU Power FMU Reset Battery backup Peripheral power control
Bypass caps as close to device pins as possible.
Note: Maximise copper area connected to center ground pad.
POR reset delay 1s / uF
Current Limits: I(limit) = 25000 / R(ilim) 25K = 1A, 16K5 = 1.5A, 47K ~500mA
Reset output 1s / uF 10n = 10ms delay from power good to reset de-asserted.

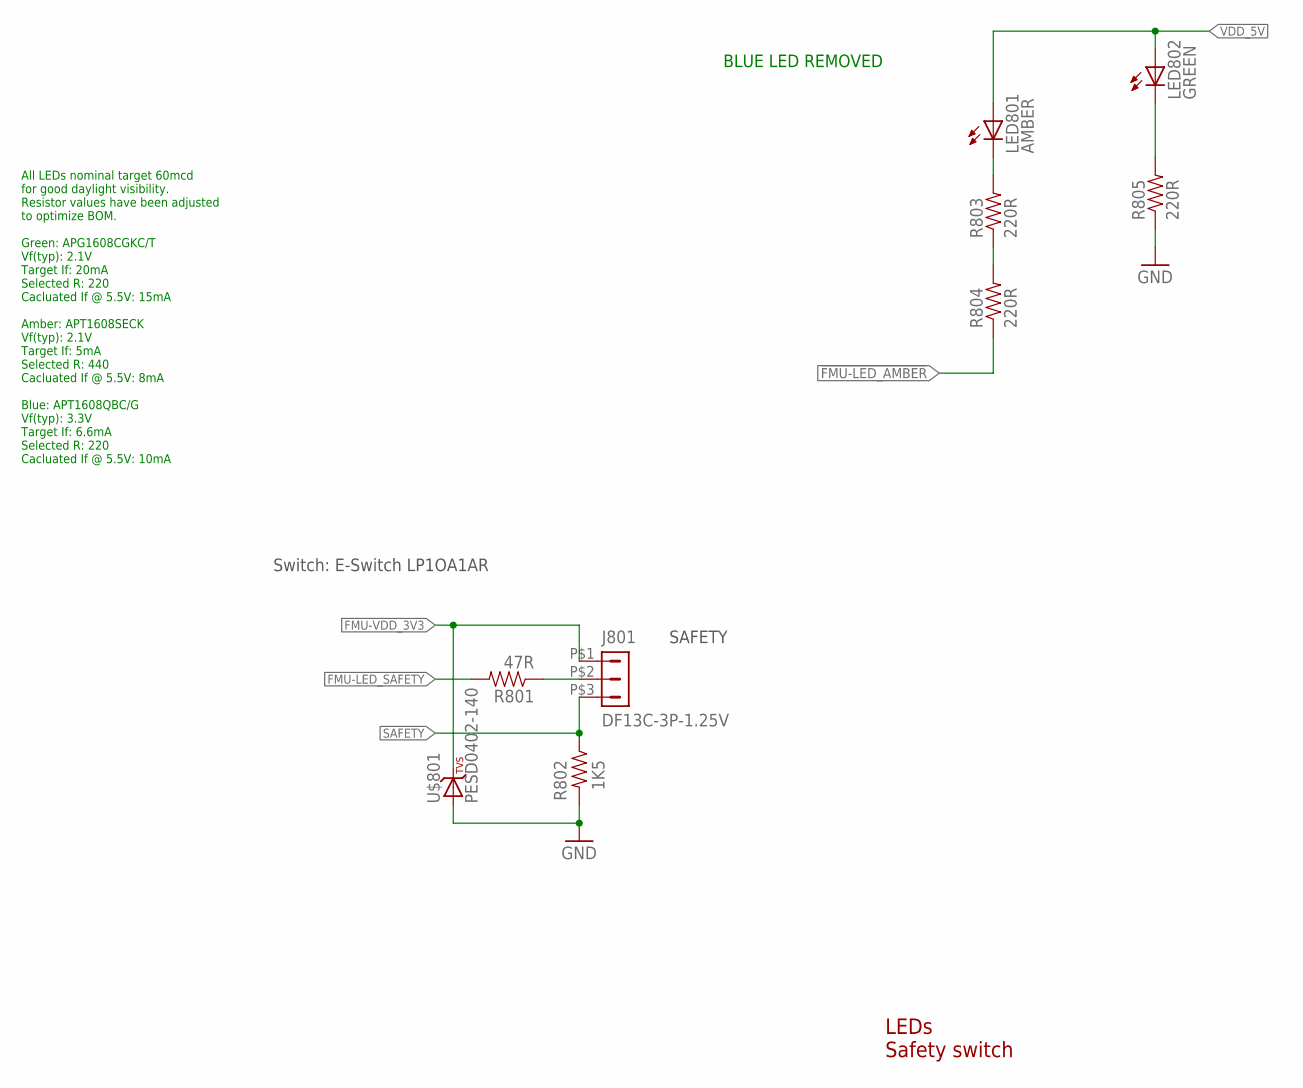
[picture p20: schematic PX4mNode_V0_1_1.sch, sheet 8]

Parts:
J801: DF13C-3P-1.25V; PARTNO DF13C-3P-1.25V(20)
LED801: AMBER; 0603-LED; PARTNO APTD1608SECK
LED802: GREEN; 0603-LED; PARTNO APTD1608CGCK
R801: 47R; 0402-RES; PARTNO RC0402JR-0747RL
R802: 1K5; 0402-RES; PARTNO RC0402FR-071K5L
R803, R804, R805: 220R; 0402-RES; PARTNO RC0402FR-07220RL
U$801: PESD0402-140; 0402-TVS; PARTNO PESD0402-140

Connections:
!FMU-LED_AMBER: R804.P$1 (1); also elsewhere on the board
FMU-LED_SAFETY: R801.P$2 (2)
FMU-VDD_3V3: J801.P$1 (1), U$801.C; also elsewhere on the board
GND: R802.P$2 (2), R805.P$1 (1), U$801.A; also elsewhere on the board
unnamed: LED802.C, R805.P$2 (2)
unnamed: R803.P$1 (1), R804.P$2 (2)
unnamed: LED801.C, R803.P$2 (2)
unnamed: J801.P$2 (2), R801.P$1 (1)
SAFETY: J801.P$3 (3), R802.P$1 (1)
VDD_5V: LED801.A, LED802.A; also elsewhere on the board

Notes on the sheet:
LEDs Safety switch
Switch: E-Switch LP1OA1AR
SAFETY
All LEDs nominal target 60mcd for good daylight visibility. Resistor values have been adjusted to optimize BOM. Green: APG1608CGKC/T Vf(typ): 2.1V Target If: 20mA Selected R: 220 Cacluated If @ 5.5V: 15mA Amber: APT1608SECK Vf(typ): 2.1V Target If: 5mA Selected R: 440 Cacluated If @ 5.5V: 8mA Blue: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
BLUE LED REMOVED

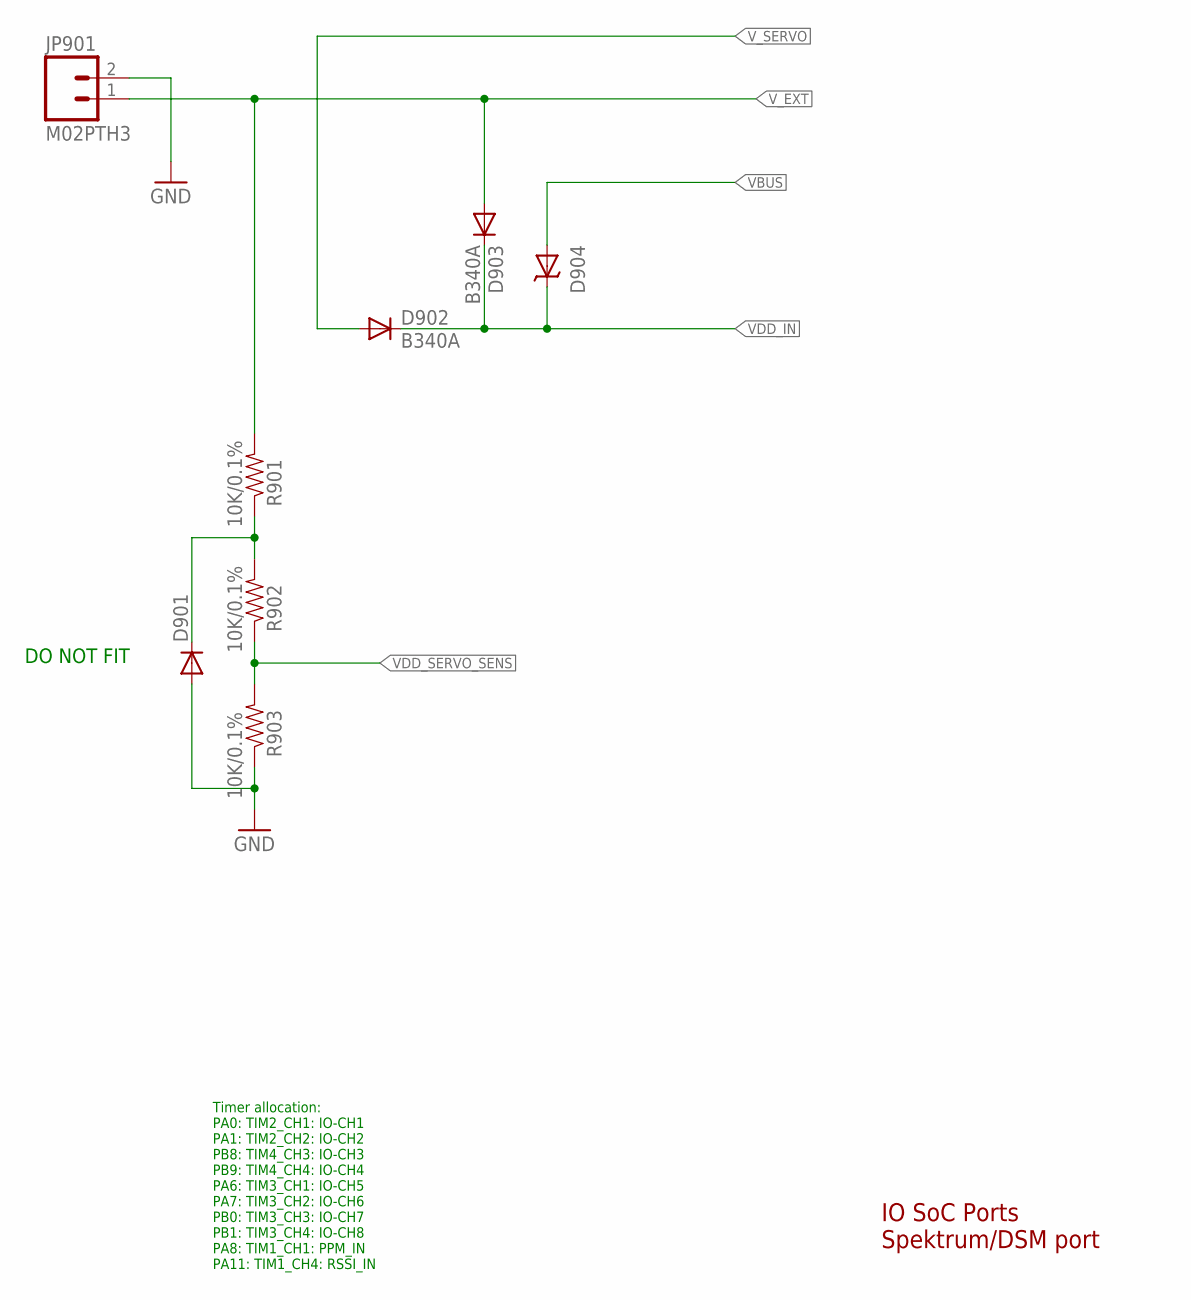
[picture p21: schematic PX4mNode_V0_1_1.sch, sheet 9]

Parts:
D901: DIODESOD; SOD-323
D902, D903: B340A; SMA-DIODE; PARTNO B340A
D904: MSS1P4-M3; MICROSMP; PARTNO MSS1P4-M3/89A
JP901: M02PTH3; 1X02_LONGPADS
R901, R902, R903: 10K/0.1%; 0402-RES; PARTNO ERA-2AEB103X

Connections:
GND: D901.2 (A), JP901.2, R903.P$1 (1); also elsewhere on the board
unnamed: D901.1 (C), R901.P$1 (1), R902.P$2 (2)
VBUS: D904.ANODE (A); also elsewhere on the board
VDD_IN: D902.C, D903.C, D904.CATHODE (C); also elsewhere on the board
VDD_SERVO_SENS: R902.P$1 (1), R903.P$2 (2)
V_EXT: D903.A, JP901.1, R901.P$2 (2)
V_SERVO: D902.A; also elsewhere on the board

Notes on the sheet:
IO SoC Ports Spektrum/DSM port
Timer allocation: PA0: TIM2_CH1: IO-CH1 PA1: TIM2_CH2: IO-CH2 PB8: TIM4_CH3: IO-CH3 PB9: TIM4_CH4: IO-CH4 PA6: TIM3_CH1: IO-CH5 PA7: TIM3_CH2: IO-CH6 PB0: TIM3_CH3: IO-CH7 PB1: TIM3_CH4: IO-CH8 PA8: TIM1_CH1: PPM_IN PA11: TIM1_CH4: RSSI_IN
DO NOT FIT

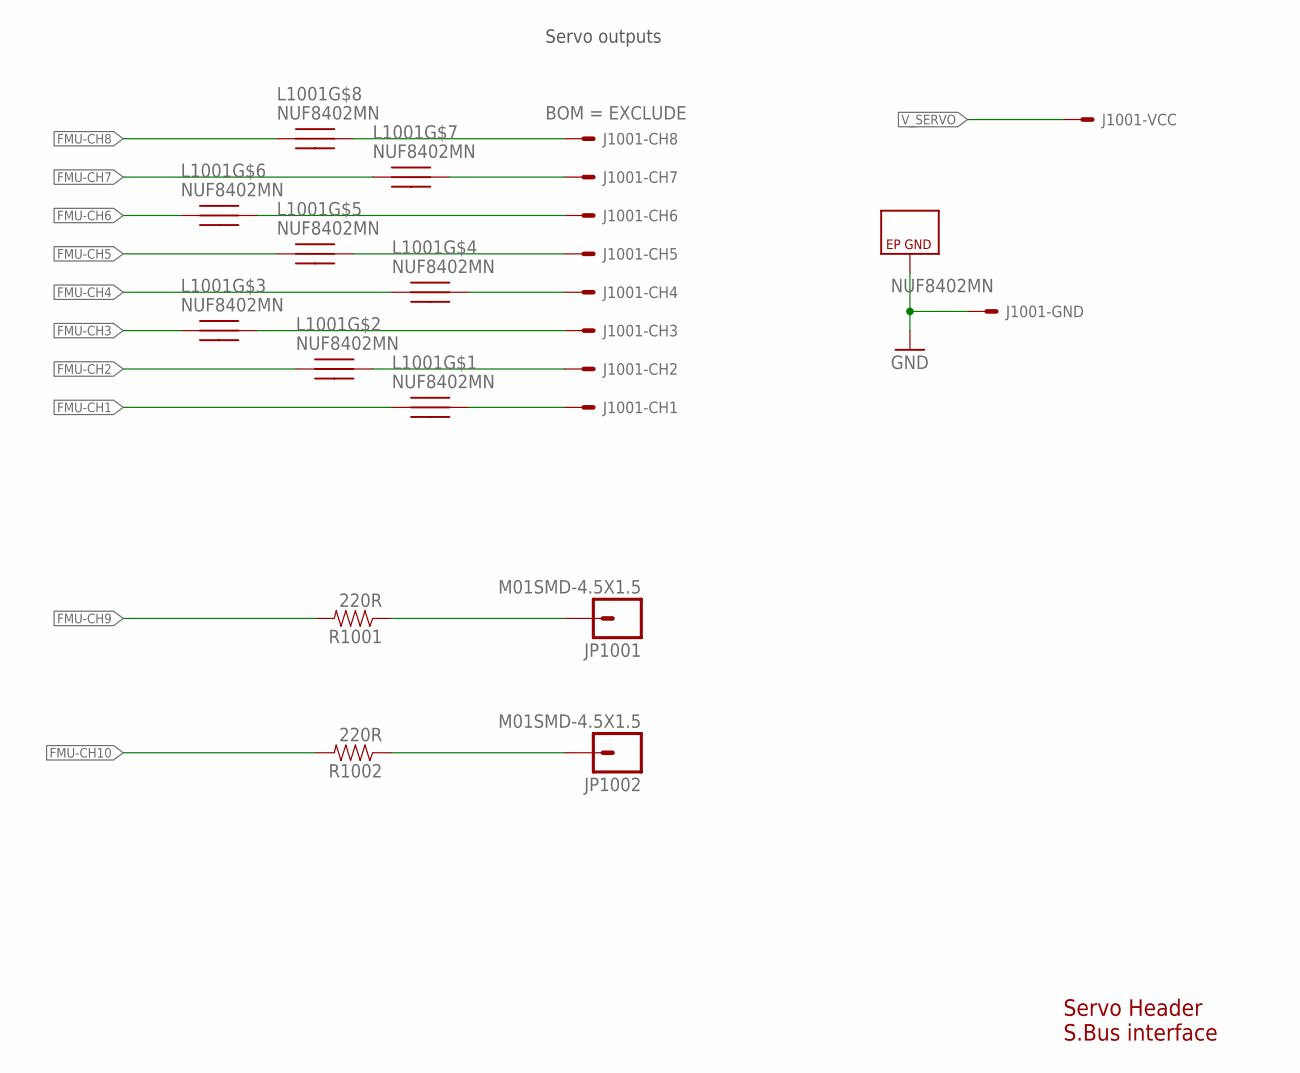
[picture p22: schematic PX4mNode_V0_1_1.sch, sheet 10]

Parts:
J1001: SERVO_HEADER-3X8; 3X8RA_SERVO
JP1001, JP1002: M01SMD-4.5X1.5; PAD-1.5X4.5
L1001: NUF8402MN; DFN16-THIN
R1001, R1002: 220R; 0402-RES; PARTNO RC0402FR-07220RL

Connections:
FMU-CH1: L1001.P$1; also elsewhere on the board
FMU-CH1-PROT: J1001.S1, L1001.P$16
FMU-CH2: L1001.P$2; also elsewhere on the board
FMU-CH3: L1001.P$3; also elsewhere on the board
FMU-CH4: L1001.P$4; also elsewhere on the board
FMU-CH5: L1001.P$5; also elsewhere on the board
FMU-CH6: L1001.P$6; also elsewhere on the board
FMU-CH7: L1001.P$7; also elsewhere on the board
FMU-CH8: L1001.P$8; also elsewhere on the board
FMU-CH9: R1001.P$2 (2); also elsewhere on the board
FMU-CH10: R1002.P$2 (2); also elsewhere on the board
GND: J1001.GND_S1, J1001.GND_S2, J1001.GND_S3, J1001.GND_S4, J1001.GND_S5, J1001.GND_S6, J1001.GND_S7, J1001.GND_S8, L1001.P$EP (GND); also elsewhere on the board
unnamed: J1001.S8, L1001.P$9
unnamed: J1001.S7, L1001.P$10
unnamed: JP1001.P$1, R1001.P$1 (1)
unnamed: JP1002.P$1, R1002.P$1 (1)
unnamed: J1001.S6, L1001.P$11
unnamed: J1001.S5, L1001.P$12
unnamed: J1001.S4, L1001.P$13
unnamed: J1001.S3, L1001.P$14
unnamed: J1001.S2, L1001.P$15
V_SERVO: J1001.PWR_S1, J1001.PWR_S2, J1001.PWR_S3, J1001.PWR_S4, J1001.PWR_S5, J1001.PWR_S6, J1001.PWR_S7, J1001.PWR_S8; also elsewhere on the board

Notes on the sheet:
Servo Header S.Bus interface
Servo outputs

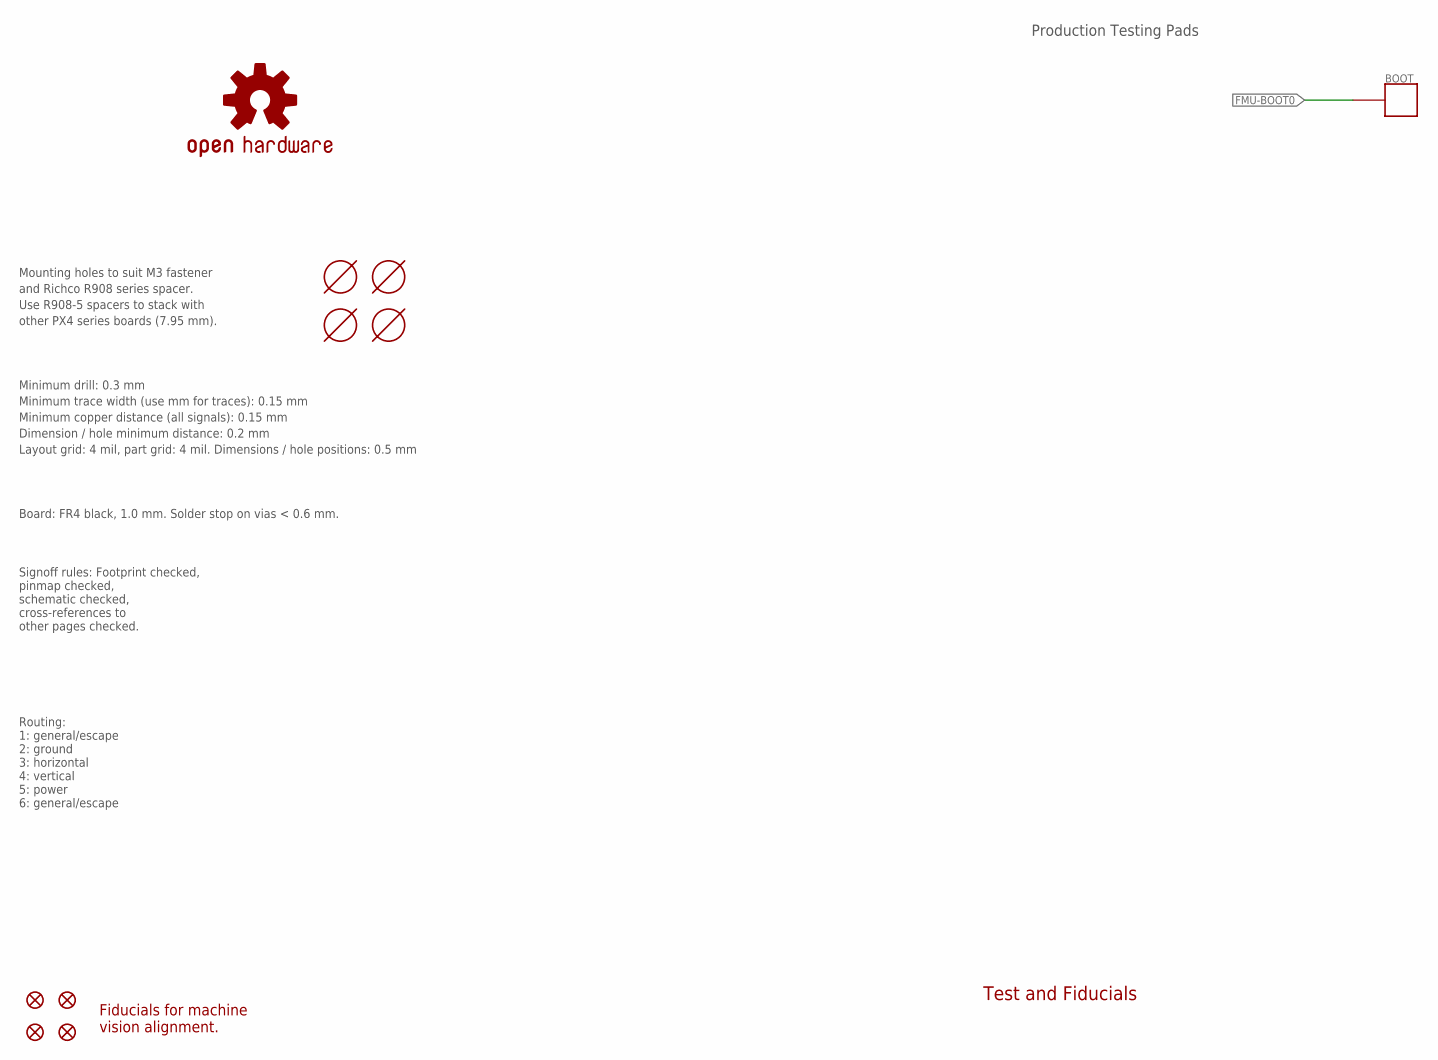
[picture p23: schematic PX4mNode_V0_1_1.sch, sheet 11]

Parts:
BOOT: PAD.04; PAD.04X.04; PARTNO *
JP1101, JP1102, JP1103, JP1104: FIDUCIAL1.5X3; FIDUCIAL-1.5X3; PARTNO *
M3_MOUNT1101, M3_MOUNT1102, M3_MOUNT1103, M3_MOUNT1104: MOUNT-HOLE3.1MM; MOUNT-HOLE3.1; PARTNO *
OSHW_LOGO: OSHW-LOGOS; OSHW-LOGO-S; PARTNO *

Connections:
FMU-BOOT0: BOOT.P$1; also elsewhere on the board

Notes on the sheet:
Mounting holes to suit M3 fastener
and Richco R908 series spacer.
Use R908-5 spacers to stack with
other PX4 series boards (7.95 mm).
Production Testing Pads
Test and Fiducials
Minimum drill: 0.3 mm
Minimum trace width (use mm for traces): 0.15 mm
Minimum copper distance (all signals): 0.15 mm
Dimension / hole minimum distance: 0.2 mm
Layout grid: 4 mil, part grid: 4 mil. Dimensions / hole positions: 0.5 mm
Board: FR4 black, 1.0 mm. Solder stop on vias < 0.6 mm.
Signoff rules: Footprint checked, pinmap checked, schematic checked, cross-references to other pages checked.
Routing: 1: general/escape 2: ground 3: horizontal 4: vertical 5: power 6: general/escape
Fiducials for machine vision alignment.

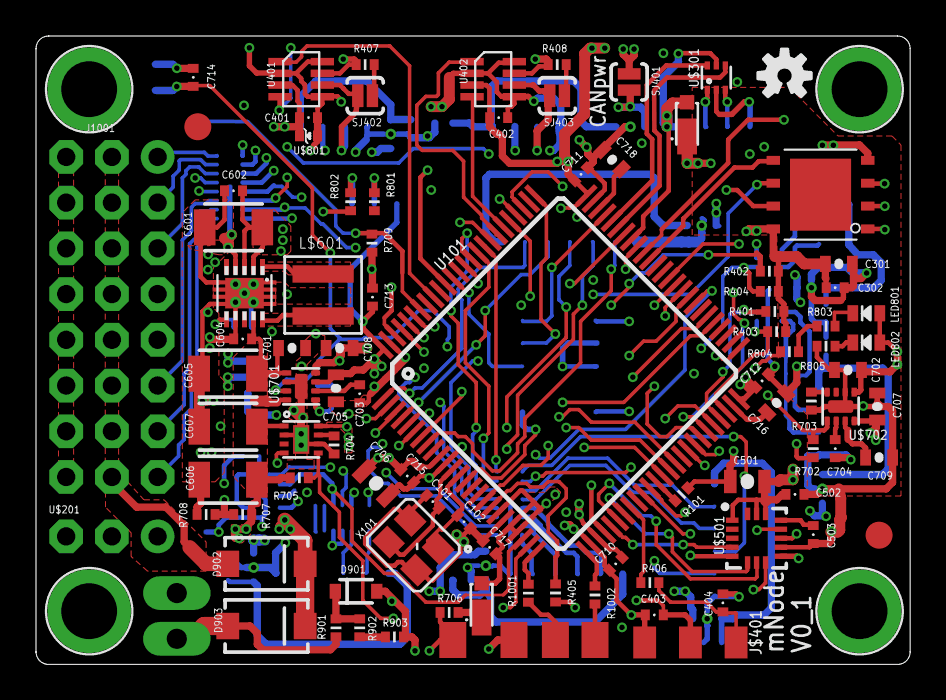
[picture p24: board PX4mNode_V0_1_1.brd from above]

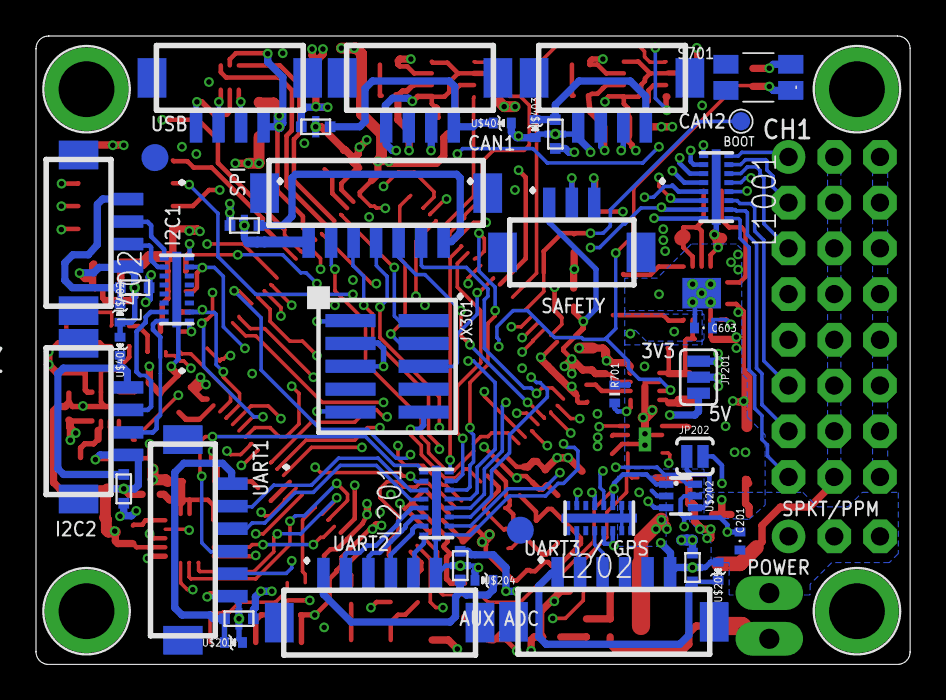
[picture p25: board PX4mNode_V0_1_1.brd from below]

Board: 6 copper layers, 48.6 x 34.9 mm, 140 parts (40 on the bottom side), 144 nets.
