crashmatt/Hardware/PX4Isolator.brd

## EAGLE design PX4Isolator.brd (2013-12-21)

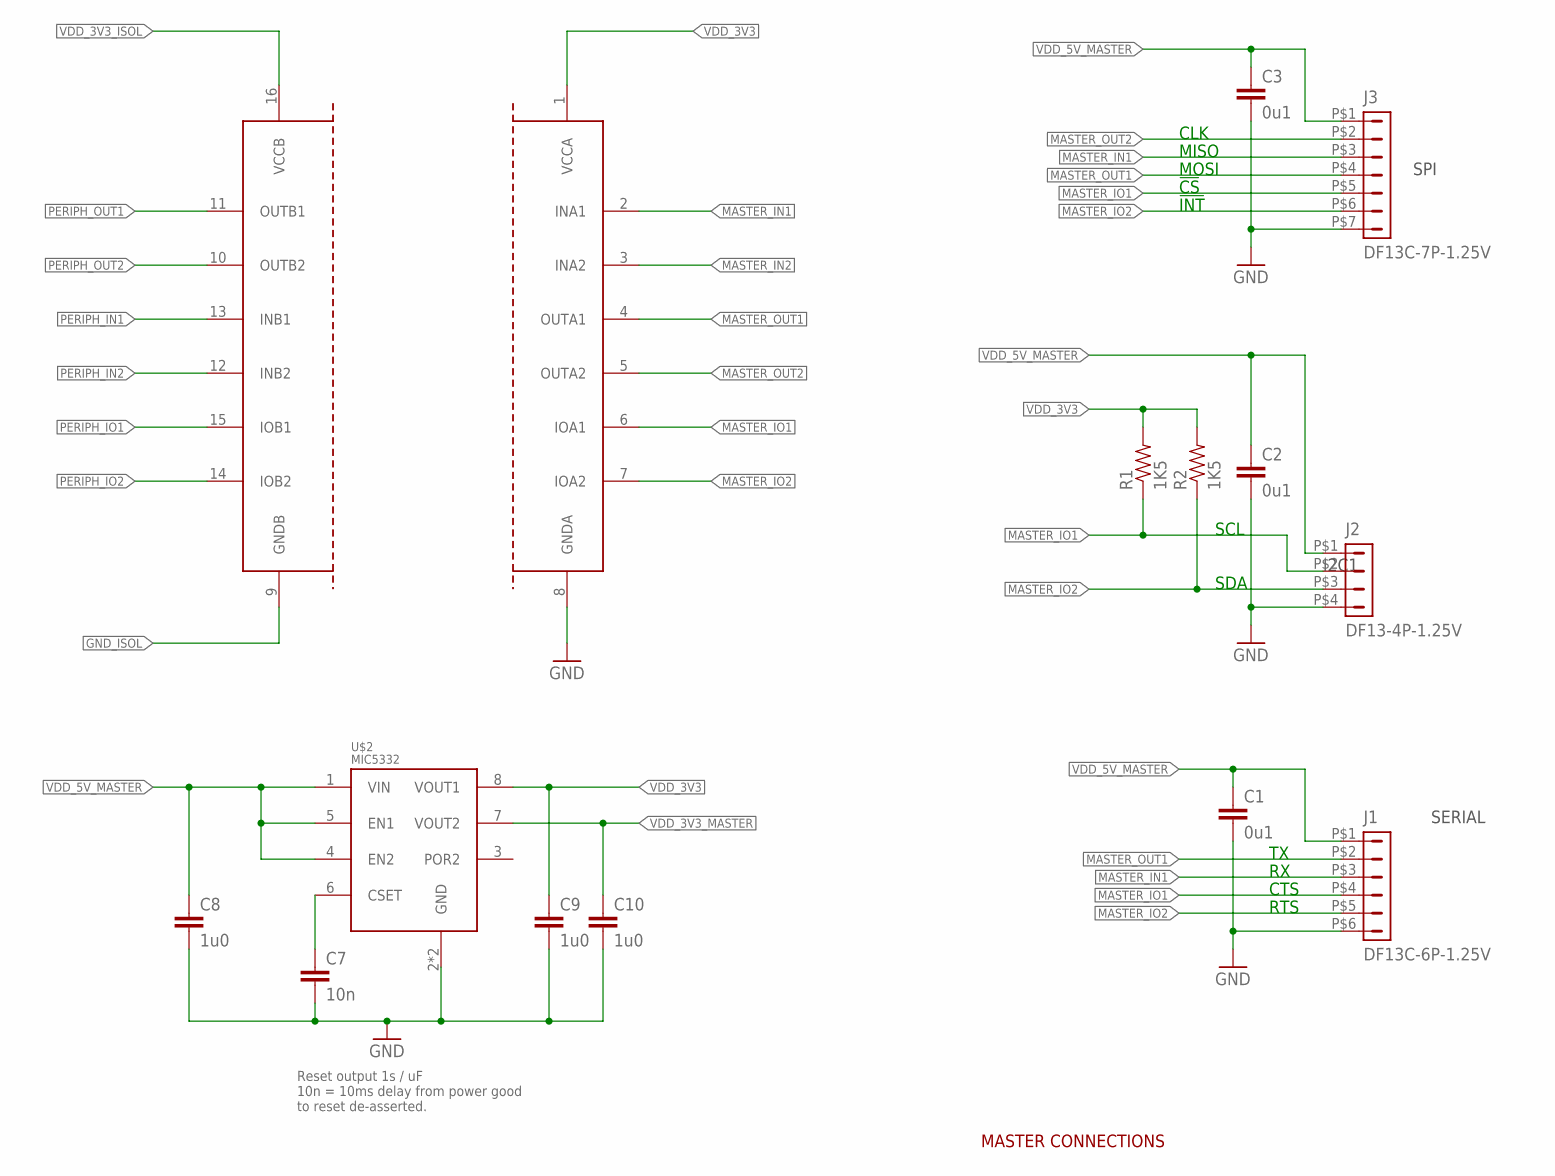
[picture p26: schematic PX4Isolator.sch, sheet 1]

Parts:
C1, C2, C3: 0u1; 0402-CAP; PARTNO CC0402ZRY5V7BB104
C7: 10n; 0402-CAP; PARTNO CC0402KRX7R7BB103
C8, C9, C10: 1u0; 0603-CAP; PARTNO CC0603ZRY5V7BB105
J1: DF13C-6P-1.25V; PARTNO DF13C-6P-1.25V(20)
J2: DF13-4P-1.25V; DF13C-4P-1.25V; PARTNO DF13C-4P-1.25V(20)
J3: DF13C-7P-1.25V; PARTNO DF13C-7P-1.25V(20)
R1, R2: 1K5; 0402-RES; PARTNO RC0402FR-071K5L
U$1: MAX14850; SOIC16
U$2: MIC5332; MLF-8-EPAD; PARTNO MIC5332-SSYMT

Connections:
GND: C1.P$2 (2), C2.P$2 (2), C3.P$2 (2), C7.P$2 (2), C8.P$2 (2), C9.P$2 (2), C10.P$2 (2), J1.P$6 (6), J2.P$4 (4), J3.P$7 (7), U$1.8 (GNDA), U$2.2 (GND), U$2.GND; also elsewhere on the board
GND_ISOL: U$1.9 (GNDB); also elsewhere on the board
MASTER_IN1: J1.P$3 (3), J3.P$3 (3), U$1.2 (INA1)
MASTER_IN2: U$1.3 (INA2)
MASTER_IO1: J1.P$4 (4), J2.P$2 (2), J3.P$5 (5), R1.P$1 (1), U$1.6 (IOA1)
MASTER_IO2: J1.P$5 (5), J2.P$3 (3), J3.P$6 (6), R2.P$1 (1), U$1.7 (IOA2)
MASTER_OUT1: J1.P$2 (2), J3.P$4 (4), U$1.4 (OUTA1)
MASTER_OUT2: J3.P$2 (2), U$1.5 (OUTA2)
unnamed: C7.P$1 (1), U$2.6 (CSET)
PERIPH_IN1: U$1.13 (INB1); also elsewhere on the board
PERIPH_IN2: U$1.12 (INB2)
PERIPH_IO1: U$1.15 (IOB1); also elsewhere on the board
PERIPH_IO2: U$1.14 (IOB2); also elsewhere on the board
PERIPH_OUT1: U$1.11 (OUTB1); also elsewhere on the board
PERIPH_OUT2: U$1.10 (OUTB2); also elsewhere on the board
VDD_3V3: C9.P$1 (1), R1.P$2 (2), R2.P$2 (2), U$1.1 (VCCA), U$2.8 (VOUT1); also elsewhere on the board
VDD_3V3_ISOL: U$1.16 (VCCB); also elsewhere on the board
VDD_3V3_MASTER: C10.P$1 (1), U$2.7 (VOUT2)
VDD_5V_MASTER: C1.P$1 (1), C2.P$1 (1), C3.P$1 (1), C8.P$1 (1), J1.P$1 (1), J2.P$1 (1), J3.P$1 (1), U$2.1 (VIN), U$2.4 (EN2), U$2.5 (EN1)

Notes on the sheet:
SPI
MASTER CONNECTIONS
I2C1
SERIAL
CLK
MISO
MOSI
!CS
!INT
SCL
SDA
CTS
RTS
Reset output 1s / uF 10n = 10ms delay from power good to reset de-asserted.
