crashmatt/Hardware/PX4Isolator.brd

## EAGLE design PX4Isolator.brd (continued)

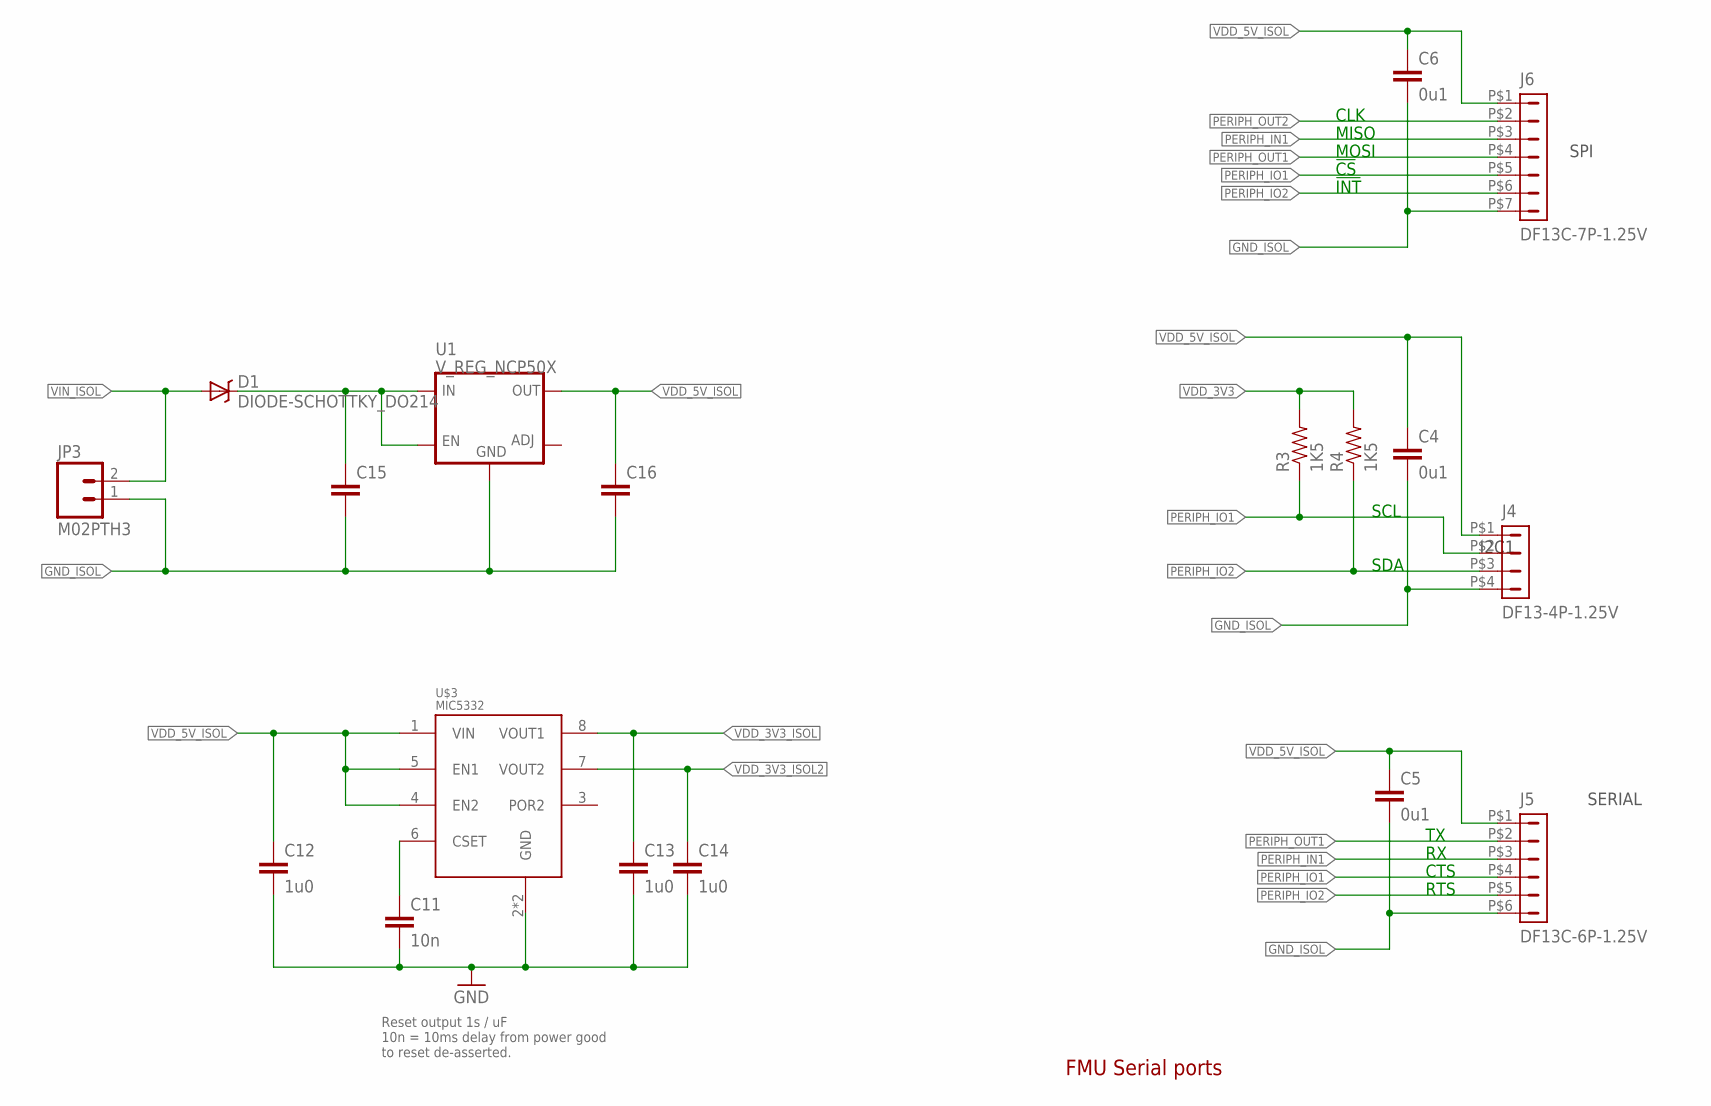
[picture p27: schematic PX4Isolator.sch, sheet 2]

Parts:
C4, C5, C6: 0u1; 0402-CAP; PARTNO CC0402ZRY5V7BB104
C11: 10n; 0402-CAP; PARTNO CC0402KRX7R7BB103
C12, C13, C14: 1u0; 0603-CAP; PARTNO CC0603ZRY5V7BB105
C15, C16: CAP0603; 0603-CAP
D1: DIODE-SCHOTTKY_DO214; DO214AC
J4: DF13-4P-1.25V; DF13C-4P-1.25V; PARTNO DF13C-4P-1.25V(20)
J5: DF13C-6P-1.25V; PARTNO DF13C-6P-1.25V(20)
J6: DF13C-7P-1.25V; PARTNO DF13C-7P-1.25V(20)
JP3: M02PTH3; 1X02_LONGPADS
R3, R4: 1K5; 0402-RES; PARTNO RC0402FR-071K5L
U1: V_REG_NCP50X; DPAK-5
U$3: MIC5332; MLF-8-EPAD; PARTNO MIC5332-SSYMT

Connections:
GND: C11.P$2 (2), C12.P$2 (2), C13.P$2 (2), C14.P$2 (2), U$3.2 (GND), U$3.GND; also elsewhere on the board
GND_ISOL: C4.P$2 (2), C5.P$2 (2), C6.P$2 (2), C15.P$2 (2), C16.P$2 (2), J4.P$4 (4), J5.P$6 (6), J6.P$7 (7), JP3.1, U1.GND; also elsewhere on the board
unnamed: C11.P$1 (1), U$3.6 (CSET)
unnamed: C15.P$1 (1), D1.C, U1.EN, U1.VIN (IN)
PERIPH_IN1: J5.P$3 (3), J6.P$3 (3); also elsewhere on the board
PERIPH_IO1: J4.P$2 (2), J5.P$4 (4), J6.P$5 (5), R3.P$1 (1); also elsewhere on the board
PERIPH_IO2: J4.P$3 (3), J5.P$5 (5), J6.P$6 (6), R4.P$1 (1); also elsewhere on the board
PERIPH_OUT1: J5.P$2 (2), J6.P$4 (4); also elsewhere on the board
PERIPH_OUT2: J6.P$2 (2); also elsewhere on the board
VDD_3V3: R3.P$2 (2), R4.P$2 (2); also elsewhere on the board
VDD_3V3_ISOL: C13.P$1 (1), U$3.8 (VOUT1); also elsewhere on the board
VDD_3V3_ISOL2: C14.P$1 (1), U$3.7 (VOUT2)
VDD_5V_ISOL: C4.P$1 (1), C5.P$1 (1), C6.P$1 (1), C12.P$1 (1), C16.P$1 (1), J4.P$1 (1), J5.P$1 (1), J6.P$1 (1), U1.VOUT (OUT), U$3.1 (VIN), U$3.4 (EN2), U$3.5 (EN1)
VIN_ISOL: D1.A, JP3.2

Notes on the sheet:
FMU Serial ports
SPI
I2C1
SERIAL
CLK
MISO
MOSI
!CS
!INT
SCL
SDA
CTS
RTS
Reset output 1s / uF 10n = 10ms delay from power good to reset de-asserted.

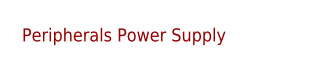
[picture p28: schematic PX4Isolator.sch, sheet 3]

Notes on the sheet:
Peripherals Power Supply

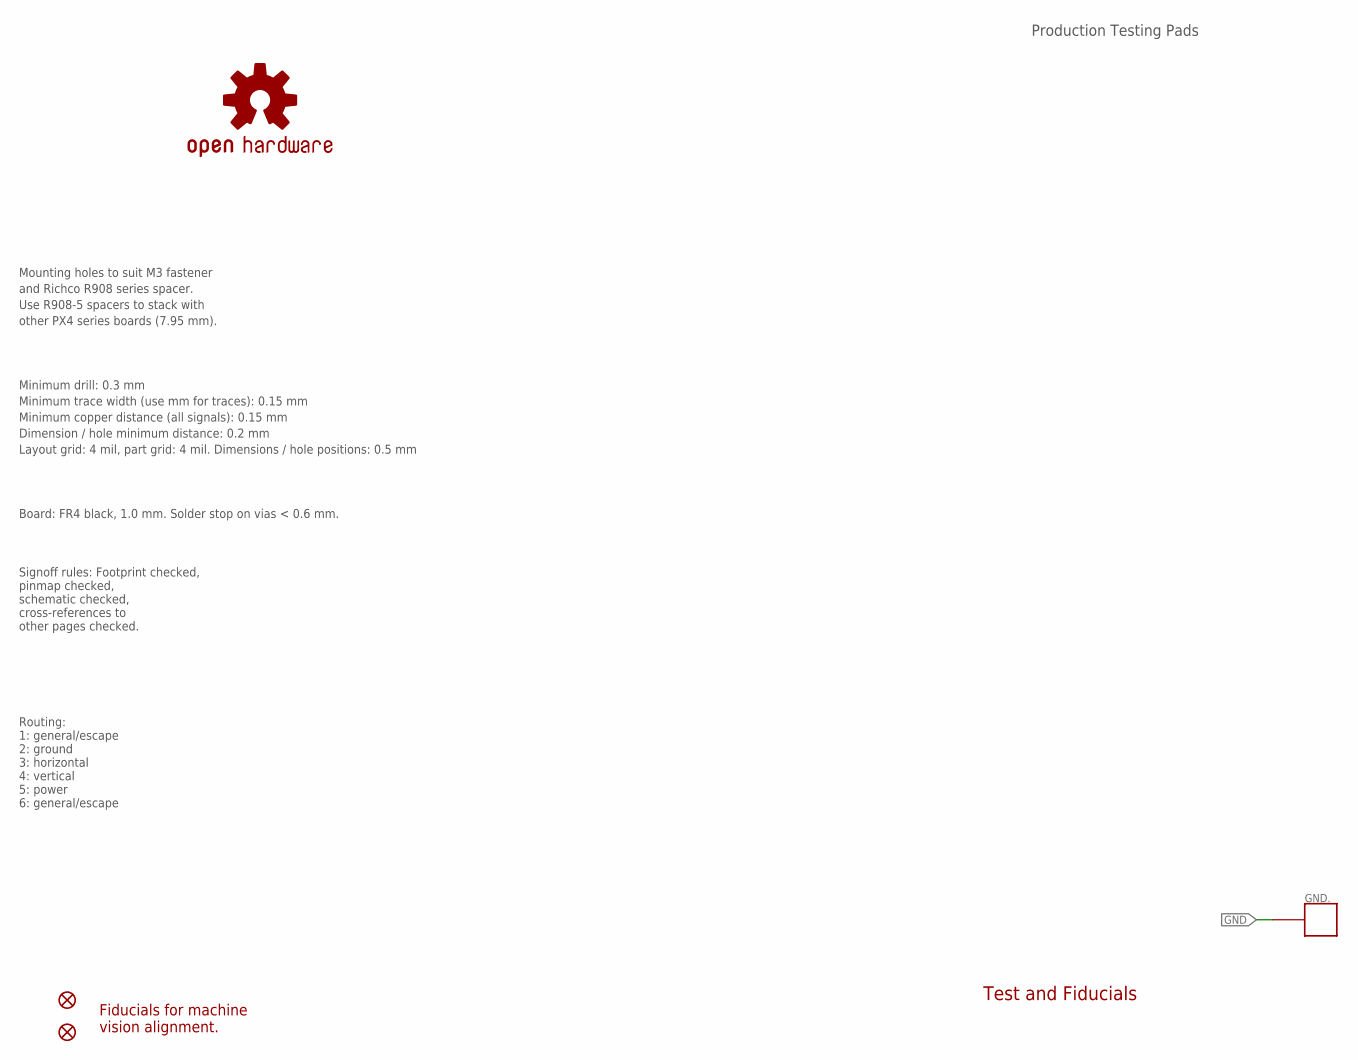
[picture p29: schematic PX4Isolator.sch, sheet 4]

Parts:
GND.: PAD.04; PAD.04X.04; PARTNO *
JP1, JP2: FIDUCIAL1.5X3; FIDUCIAL-1.5X3; PARTNO *
OSHW_LOGO: OSHW-LOGOS; OSHW-LOGO-S; PARTNO *

Connections:
GND: GND..P$1; also elsewhere on the board

Notes on the sheet:
Mounting holes to suit M3 fastener
and Richco R908 series spacer.
Use R908-5 spacers to stack with
other PX4 series boards (7.95 mm).
Production Testing Pads
Test and Fiducials
Minimum drill: 0.3 mm
Minimum trace width (use mm for traces): 0.15 mm
Minimum copper distance (all signals): 0.15 mm
Dimension / hole minimum distance: 0.2 mm
Layout grid: 4 mil, part grid: 4 mil. Dimensions / hole positions: 0.5 mm
Board: FR4 black, 1.0 mm. Solder stop on vias < 0.6 mm.
Signoff rules: Footprint checked, pinmap checked, schematic checked, cross-references to other pages checked.
Routing: 1: general/escape 2: ground 3: horizontal 4: vertical 5: power 6: general/escape
Fiducials for machine vision alignment.

Board: 6 copper layers, 36 parts (10 on the bottom side), 22 nets, no tracks yet.
