crashmatt/Hardware/(commit log)

2013-12-16 added PX4lite - work in progress
    [PX4FMUlite_V5.brd, PX4FMUlite_V5.sch]
2013-12-16 changed PX4FMUlite to from V5 to V0_1
    [PX4FMUlite_V0_1.brd, PX4FMUlite_V0_1.sch]
2013-12-16 lots of ripus done on V0_1
    [PX4FMUlite_V0_1.brd]
2013-12-16 Resize board, resized servo conn plus more
    [PX4FMUlite_V0_1.brd, PX4FMUlite_V0_1.sch]
2013-12-17 Removed TXS0105 buffer on excess uarts
    [PX4FMUlite_V0_1.brd, PX4FMUlite_V0_1.sch]
2013-12-17 Replaced lvl translators with NFU8042 ESD/EMI filters
    [PX4FMUlite_V0_1.brd, PX4FMUlite_V0_1.sch]
2013-12-18 Change to MPU6000 (sparkfun - needs changing), Removed DF13 powerbrick conn
    [PX4FMUlite_V0_1.brd, PX4FMUlite_V0_1.sch]
2013-12-18 Added V0_2 because V0_1 would not save
    [PX4FMUlite_V0_2.brd, PX4FMUlite_V0_2.sch]
2013-12-18 Changed to winbond W25Q64 64mbit flash in 5*6 8WSON
    [PX4FMUlite_V0_2.brd, PX4FMUlite_V0_2.sch]
2013-12-18 Test positioning
    [PX4FMUlite_V0_2.brd, PX4FMUlite_V0_2.sch]
2013-12-19 Removed excess UART4/5 connector
    [PX4FMUlite_V0_2.brd, PX4FMUlite_V0_2.sch]
2013-12-19 I2C2 connector added.
    [PX4FMUlite_V0_2.brd, PX4FMUlite_V0_2.sch]
2013-12-19 General shuffling of filters
    [PX4FMUlite_V0_2.brd, PX4FMUlite_V0_2.sch]
2013-12-20 USB connector move to side. UART conns together
    [PX4FMUlite_V0_2.brd, PX4FMUlite_V0_2.sch]
2013-12-20 Tweaks on MPU6000
    [PX4FMUlite_V0_2.brd, PX4FMUlite_V0_2.sch]
2013-12-20 Moved to V0_3 to make bigger changes
    [PX4FMUlite_V0_3.brd, PX4FMUlite_V0_3.sch]
2013-12-20 More tweaks
    [PX4FMUlite_V0_3.brd, PX4FMUlite_V0_3.sch]
2013-12-21 Change IO power to 3V3 peripheral power
    [PX4FMUlite_V0_3.brd, PX4FMUlite_V0_3.sch]
2013-12-21 Start of isolator-power injector design
    [PX4Isolator.brd, PX4Isolator.sch]
2013-12-21 Isolator peripheral side signals done
    [PX4Isolator.brd, PX4Isolator.sch]
2013-12-21 Regulator added
    [PX4Isolator.brd, PX4Isolator.sch]
2013-12-21 Added TPS62143 buck, moved mounting points
    [PX4FMUlite_V0_3.brd, PX4FMUlite_V0_3.sch, PX4Isolator.brd, PX4Isolator.sch]
2013-12-21 Changed to MAX21100
    [PX4FMUlite_V0_3.brd, PX4FMUlite_V0_3.sch]
2013-12-21 Moved switch plus more tweaks
    [PX4FMUlite_V0_3.brd]
2013-12-22 Another connector reposition
    [PX4FMUlite_V0_3.brd]
2013-12-22 Added power input diodes
    [PX4FMUlite_V0_3.brd, PX4FMUlite_V0_3.sch]
2013-12-22 Added cap to TPS63031 buck-boost
    [PX4FMUlite_V0_3.brd, PX4FMUlite_V0_3.sch]
2013-12-23 Crystal rewire
    [PX4FMUlite_V0_3.brd, PX4FMUlite_V0_3.sch]
2013-12-23 buck-boost half wired. CAN wiring in progress.
    [PX4FMUlite_V0_3.brd, PX4FMUlite_V0_3.sch]
2013-12-23 Adjusted servo connector direction
    [PX4FMUlite_V0_3.brd, PX4FMUlite_V0_3.sch]
2013-12-23 More wiring done
    [PX4FMUlite_V0_3.brd, PX4FMUlite_V0_3.sch]
2013-12-23 Rewired servo ESD a little
    [PX4FMUlite_V0_3.brd]
2013-12-23 Getting too tight
    [PX4FMUlite_V0_3.brd, PX4FMUlite_V0_3.sch]
2013-12-23 Added FMU 3V3 LDO
    [PX4FMUlite_V0_3.brd, PX4FMUlite_V0_3.sch]
2013-12-24 LDO shuffle. VBUS reconnected
    [PX4FMUlite_V0_3.brd, PX4FMUlite_V0_3.sch]
2013-12-24 USB mostly wired up
    [PX4FMUlite_V0_3.brd]
2013-12-24 Reconnected VDD_5V_PERIPHERAL
    [PX4FMUlite_V0_3.brd, PX4FMUlite_V0_3.sch]
2013-12-24 started to wire MAX21100
    [PX4FMUlite_V0_3.brd, PX4FMUlite_V0_3.sch]
2013-12-25 Filter taken from Vin since it is well decoupled through TPS63031
    [PX4FMUlite_V0_3.brd, PX4FMUlite_V0_3.sch]
2013-12-25 I2C ESD and VBUS to VIN wired
    [PX4FMUlite_V0_3.brd]
2013-12-25 Addingsome extra vias to VBUS and GNDs
    [PX4FMUlite_V0_3.brd]
2013-12-25 More wiring of peripheral 5V power
    [PX4FMUlite_V0_3.brd]
2013-12-25 Removed SBUS interface that would not fit
    [PX4FMUlite_V0_3.brd, PX4FMUlite_V0_3.sch]
2013-12-25 Reworked PPM and spektrum through ESD/filter
    [PX4FMUlite_V0_3.brd, PX4FMUlite_V0_3.sch]
2013-12-25 Spektrum 3V3 power routing half done
    [PX4FMUlite_V0_3.brd]
2013-12-26 Tweaks to FMU 5V LDO layout
    [PX4FMUlite_V0_3.brd]
2013-12-26 More power routing
    [PX4FMUlite_V0_3.brd, PX4FMUlite_V0_3.sch]
2013-12-26 More power routing. flash placed and part routed
    [PX4FMUlite_V0_3.brd]
2013-12-26 Flash power decoupling
    [PX4FMUlite_V0_3.brd, PX4FMUlite_V0_3.sch]
2013-12-26 Sensor LDO routed
    [PX4FMUlite_V0_3.brd]
2013-12-26 More stuff
    [PX4FMUlite_V0_3.brd, PX4FMUlite_V0_3.sch]
2013-12-27 VDD_5V_PERIPH and GND powerplanes added
    [PX4FMUlite_V0_3.brd, PX4FMUlite_V0_3.sch]
2013-12-27 Rerouting of 5V_IN to improve V_SERVO routing
    [PX4FMUlite_V0_3.brd, PX4FMUlite_V0_3.sch]
2013-12-27 Fitting pull-up down resistors in
    [PX4FMUlite_V0_3.brd]
2013-12-27 Moved gps to uart 7 to make room for using timer1/5 for IO
    [PX4FMUlite_V0_3.brd, PX4FMUlite_V0_3.sch, PX4FMUv2.3.sch]
2013-12-27 Added PPM and CH7,9,10 to TIM2&TIM5 pins 22,23,24 etc..
    [PX4FMUlite_V0_3.brd, PX4FMUlite_V0_3.sch]
2013-12-27 Added 3v3 power tracks to CAN drivers
    [PX4FMUlite_V0_3.brd, PX4FMUlite_V0_3.sch]
2013-12-28 PX4FMULite_V0_4 to remove features that don't fit
    [PX4FMUlite_V0_4.brd, PX4FMUlite_V0_4.sch]
2013-12-28 Blue LED removed
    [PX4FMUlite_V0_4.brd, PX4FMUlite_V0_4.sch]
2013-12-28 Positioned buckboost Vaux decoupling cap
    [PX4FMUlite_V0_4.brd, PX4FMUlite_V0_4.sch]
2013-12-28 Everything fitted before autoroute
    [PX4FMUlite_V0_4.brd, PX4FMUlite_V0_4.sch]
2013-12-28 Tweaked power fills to prevent them being isolated after autoroute
    [PX4FMUlite_V0_4.brd]
2013-12-28 Routed safety switch resistor
    [PX4FMUlite_V0_4.brd]
2013-12-28 Tweaks tweaks
    [PX4FMUlite_V0_4.brd]
2013-12-28 More pre-autoroute tweaks
    [PX4FMUlite_V0_4.brd]
2013-12-28 Moved groundplane flood away from mounting holes
    [PX4FMUlite_V0_4.brd]
2013-12-28 Voltage sense moved from VSERVO to VAUX
    [PX4FMUlite_V0_4.brd, PX4FMUlite_V0_4.sch]
2013-12-28 All clearances and drill distances fixed.
    [PX4FMUlite_V0_4.brd]
2013-12-28 Removed random track spot outside of dimensions
    [PX4FMUlite_V0_4.brd]
2013-12-28 Full routed board added
    [PX4FMUlite_V0_4_routed.brd, PX4FMUlite_V0_4_routed.sch]
2013-12-29 Moved connector labeling
    [PX4FMUlite_V0_4_routed.brd]
2013-12-29 Labeling clearup
    [PX4FMUlite_V0_4_routed.brd]
2013-12-29 Tweaked flood fills to 0.15mm minimum, most 0.2mm
    [PX4FMUlite_V0_4_routed.brd]
2014-01-04 Added PCB Pool high spec design rules file
    [PX4FMUlite_V0_4_routed.brd]
2014-01-04 Added PX4Node_mini_V0_1_1
    [PX4Node_mini_V0_1_1.brd, PX4Node_mini_V0_1_1.sch]
2014-01-04 Removed older generation versions
    [PX4FMUlite_V0_1.brd, PX4FMUlite_V0_1.sch, PX4FMUlite_V0_2.brd, PX4FMUlite_V0_2.sch]
2014-01-05 Some tweaks
    [PX4Node_mini_V0_1_1.brd, PX4Node_mini_V0_1_1.sch]
2014-01-06 Tweaks to power and grounds
    [PX4Node_mini_V0_1_1.brd]
2014-01-06 Rename to mNode
    [PX4mNode_V0_1_1.brd, PX4mNode_V0_1_1.sch]
2014-01-06 Parts renumber
    [PX4mNode_V0_1_1.brd, PX4mNode_V0_1_1.sch]
2014-01-06 Sensor 3V3 supply changed to default enabled
    [PX4mNode_V0_1_1.brd, PX4mNode_V0_1_1.sch]
2014-01-06 Spektrum 3v3 pulldown resistor moves for better groundplane
    [PX4mNode_V0_1_1.brd]
2014-01-06 Added spektrum 3V3 enable signal
    [PX4mNode_V0_1_1.brd, PX4mNode_V0_1_1.sch]
2014-01-06 Locked connectors
    [PX4mNode_V0_1_1.brd]
2014-01-06 Moved boot pad to safer position
    [PX4mNode_V0_1_1.brd, PX4mNode_V0_1_1.sch]
2014-01-06 More fiddling about
    [PX4mNode_V0_1_1.brd]
2014-01-06 Modified EP solder paste masks with crosshatch to reduce solder voids
    [PX4mNode_V0_1_1.brd, PX4mNode_V0_1_1.sch]
2014-01-06 Removed dull soldering comment
    [PX4mNode_V0_1_1.brd]
2014-01-06 Renamed and moved some component names
    [PX4mNode_V0_1_1.brd, PX4mNode_V0_1_1.sch]
2014-01-06 pre-sbus checkpoint
    [PX4mNode_V0_1_1.brd, PX4mNode_V0_1_1.sch]
2014-01-07 Added SBUS input inverter
    [PX4mNode_V0_1_1.brd, PX4mNode_V0_1_1.sch]
2014-01-07 Added power selector for PPM/Spektrum/SBUS power output
    [PX4mNode_V0_1_1.brd, PX4mNode_V0_1_1.sch]
2014-01-07 Added fiducials to bottom side to support fine pitch packages
    [PX4mNode_V0_1_1.brd, PX4mNode_V0_1_1.sch]
2014-01-08 Reworked sbus input to make space for sbus output
    [PX4mNode_V0_1_1.brd, PX4mNode_V0_1_1.sch]
2014-01-08 SBUS output fitted
    [PX4mNode_V0_1_1.brd, PX4mNode_V0_1_1.sch]
2014-01-09 Shuffled USB ESD protector to make a little more space
    [PX4mNode_V0_1_1.brd]
2014-01-09 Another autorouter detangle tidyup
    [PX4mNode_V0_1_1.brd]
2014-01-09 Reworked VBAT pullup to make psace around PSU
    [PX4mNode_V0_1_1.brd]
2014-01-09 Added schottky diode for VBAT charging
    [PX4mNode_V0_1_1.brd, PX4mNode_V0_1_1.sch]
2014-01-09 More untangling
    [PX4mNode_V0_1_1.brd]
2014-01-09 Reconnected missing UART filtered 5V power
    [PX4mNode_V0_1_1.brd]
2014-01-09 Graphic shuffle
    [PX4mNode_V0_1_1.brd]
2014-01-10 Realigned bad autoroute alignment on microcontroller pins
    [PX4mNode_V0_1_1.brd]
2014-01-10 Part renumbering again
    [PX4mNode_V0_1_1.brd, PX4mNode_V0_1_1.sch]
2014-01-10 Moved VDD_3V3_SPEKTRUM_EN to a spare ADC to make space for FMU_CH10
    [PX4mNode_V0_1_1.brd, PX4mNode_V0_1_1.sch]
2014-01-10 Patched MAX21100 DRDY to MAG_DRDY
    [PX4mNode_V0_1_1.brd, PX4mNode_V0_1_1.sch]
2014-01-10 Clearing a few tracks
    [PX4mNode_V0_1_1.brd]
2014-01-11 Corrected kyocera filter stop mask on center ground pad
    [PX4mNode_V0_1_1.brd, PX4mNode_V0_1_1.sch]
2014-01-11 Added nReset SWD connection to !FMU_RESET
    [PX4mNode_V0_1_1.brd, PX4mNode_V0_1_1.sch]
2014-01-11 Moved analog connector pads
    [PX4mNode_V0_1_1.brd]
2014-01-11 Added extra ground and power connections
    [PX4mNode_V0_1_1.brd, PX4mNode_V0_1_1.sch]
2014-01-11 Simplified GYRO_DRDY route
    [PX4mNode_V0_1_1.brd]
2014-01-11 Stop mask removed from vias
    [PX4mNode_V0_1_1.brd, PX4mNode_V0_1_1.sch]
2014-01-11 Tracking simplification around MAX21100
    [PX4mNode_V0_1_1.brd]
2014-01-11 Cleared more clearance errors
    [PX4mNode_V0_1_1.brd]
2014-01-11 More clearances cleared
    [PX4mNode_V0_1_1.brd]
2014-01-11 BOM EXLUDES added to solder jumpers, 0.1" conns etc..
    [PX4mNode_V0_1_1.brd, PX4mNode_V0_1_1.sch]
2014-01-11 a few bom tweaks
    [PX4mNode_V0_1_1.brd, PX4mNode_V0_1_1.sch]
2014-01-12 Groundplanes added
    [PX4mNode_V0_1_1.brd]
2014-01-12 Corrected Winbond flash package and added suitable keepout area. Extended top groundplane
    [PX4mNode_V0_1_1.brd, PX4mNode_V0_1_1.sch]
2014-01-12 Top groundplane shrunk
    [PX4mNode_V0_1_1.brd]
2014-01-15 Added uNode, Removed old versions of mNode
    [PX4FMUlite_V0_3.brd, PX4FMUlite_V0_3.sch, PX4FMUlite_V0_4_routed.brd, PX4FMUlite_V0_4_routed.sch, PX4uNode_V0_1_1.brd, PX4uNode_V0_1_1.sch]
2014-01-15 Some uNode first layout
    [PX4uNode_V0_1_1.brd, PX4uNode_V0_1_1.sch]
2014-01-15 uNode - Bit more layout
    [PX4uNode_V0_1_1.brd, PX4uNode_V0_1_1.sch]
2014-01-16 CAN layout done
    [PX4uNode_V0_1_1.brd, PX4uNode_V0_1_1.sch]
2014-01-16 uNode - More layout
    [PX4uNode_V0_1_1.brd, PX4uNode_V0_1_1.sch]
2014-01-17 uNode - Just more layout
    [PX4uNode_V0_1_1.brd, PX4uNode_V0_1_1.sch]
2014-01-18 Layout UART 1&2
    [PX4uNode_V0_1_1.brd, PX4uNode_V0_1_1.sch]
2014-01-18 UART 3 ESD swap
    [PX4uNode_V0_1_1.brd, PX4uNode_V0_1_1.sch]
2014-01-18 uNode - Memory layout
    [PX4uNode_V0_1_1.brd, PX4uNode_V0_1_1.sch]
2014-01-18 uNode - Lots more layout
    [PX4uNode_V0_1_1.brd]
2014-01-18 Removed unused 3V3 peripheral power from regulator
    [PX4uNode_V0_1_1.brd, PX4uNode_V0_1_1.sch]
2014-01-19 uNode - More pullup resistor placed
    [PX4uNode_V0_1_1.brd, PX4uNode_V0_1_1.sch]
2014-01-19 PTH for boot and bat
    [PX4uNode_V0_1_1.brd, PX4uNode_V0_1_1.sch]
2014-01-19 uNode - CAN river 3V3 connected
    [PX4uNode_V0_1_1.brd, PX4uNode_V0_1_1.sch]
2014-01-20 little tweak
    [PX4uNode_V0_1_1.brd]
2014-01-20 Changed SBUS inverter for TSSOP part with output enable
    [PX4uNode_V0_1_1.brd, PX4uNode_V0_1_1.sch]
2014-01-20 SBUS inverter changed to VSSOP and layout done
    [PX4uNode_V0_1_1.brd, PX4uNode_V0_1_1.sch]
2014-01-20 Battery added. Floods added to power tracks
    [PX4uNode_V0_1_1.brd, PX4uNode_V0_1_1.sch]
2014-01-20 Groundplane added
    [PX4uNode_V0_1_1.brd]
2014-01-20 Almost routed
    [PX4uNode_V0_1_1.brd]
2014-01-21 Servo output channels ripped up for reshuffle
    [PX4uNode_V0_1_1.brd]
2014-01-21 Layout done
    [PX4uNode_V0_1_1.brd, PX4uNode_V0_1_1.sch]
2014-01-21 Much trace tidying and simplification
    [PX4uNode_V0_1_1.brd, PX4uNode_V0_1_1.sch]
2014-01-21 More layout cleanup done
    [PX4uNode_V0_1_1.brd]
2014-01-21 Placement labels arranged
    [PX4uNode_V0_1_1.brd]
2014-01-22 Nice and tidy
    [PX4uNode_V0_1_1.brd]
2014-02-02 Added more vias to regulator power paths
    [PX4uNode_V0_1_1.brd, PX4uNode_V0_1_1.sch]
2014-02-02 All design rules violations fixed or approved
    [PX4uNode_V0_1_1.brd]
2014-02-02 Thickened pogo connector traces where possible
    [PX4uNode_V0_1_1.brd]
2014-02-02 Removed extra Vbat hole
    [PX4uNode_V0_1_1.brd, PX4uNode_V0_1_1.sch]
2014-02-02 A little more grounding
    [PX4uNode_V0_1_1.brd, PX4uNode_V0_1_1.sch]
2014-02-03 Excluded 0.1" connectors from BOM
    [PX4uNode_V0_1_1.brd]
2014-02-03 General track thickening
    [PX4uNode_V0_1_1.brd, PX4uNode_V0_1_1.sch]
2014-02-03 Final track tweaks
    [PX4uNode_V0_1_1.brd]
2014-02-03 final final track tweaks
    [PX4uNode_V0_1_1.brd]
2014-02-03 yet more final track tweaks
    [PX4uNode_V0_1_1.brd]
2014-02-03 Added PARTNO and EXCLUDE to BOM. Parts renumbered
    [PX4uNode_V0_1_1.brd, PX4uNode_V0_1_1.sch]
2014-02-03 More BOM tweaks
    [PX4uNode_V0_1_1.brd, PX4uNode_V0_1_1.sch]
2014-02-04 One last track thickening
    [PX4uNode_V0_1_1.brd]
2014-02-04 PCB component smash and name placement
    [PX4mNode_V0_1_1.brd, PX4uNode_V0_1_1.brd]
2015-01-09 Added uNode V0_1_2
    [PX4uNode_V0_1_2.brd, PX4uNode_V0_1_2.sch]
2015-01-10 Added PX4uNode_V01_01_3
    [PX4uNode_V0_1_3.brd, PX4uNode_V0_1_3.sch]
2015-01-11 Tweaks of uNode_V0_1_3
    [PX4uNode_V0_1_3.brd]
2015-01-16 Added PX4uNode_v0_2_1 files
    [PX4uNode_V0_2_1.brd, PX4uNode_V0_2_1.sch]
